mthsladeira/projetos1/README.md

# projetos1
Repositório para relatório e arquivos relativos à matéria Projetos de Aeronaves I (2018/1)
