mthsladeira/projetos1/titlepage.tex

\begin{titlepage}
	\centering
    \vfill
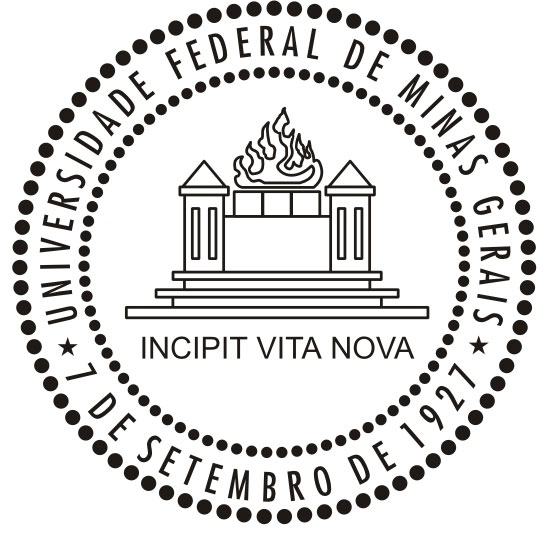
[picture p1: images/UFMG.jpg]
    \\[1.5 cm]	
    \textsc{\LARGE Universidade Federal de Minas Gerais}\\[1.0 cm]
	\textsc{\Large Engenharia Aeroespacial}\\[0.5 cm]
	\textsc{\large Projetos de Aeronaves I - EMA052}\\[0.5 cm]
    \vfill
	\rule{\linewidth}{0.2 mm} \\[0.4 cm]
	{ \huge \bfseries \thetitle}\\
	\rule{\linewidth}{0.2 mm} \\
	
    \vfill

	\theauthor
    
    \vfill
    
	{\large \thedate}\\
	
\end{titlepage}
