mthsladeira/projetos1/text/parte3/tabela_resumo.tex

\chapter{Resumo da Aeronave}
\label{tabelaresumo}

O forma em planta da aeronave está no \textbf{Anexo D} e as dimensões geométricas estão apresentadas no desenho. A \autoref{tbl:resumo} resumo as principais característica da aeronave.

\begin{table}[H]
\centering
\begin{tabular}{rcrc}
\toprule
$S$ & 53 $m^2$ & $MTOW$  & 20806 kg\\
$W/S$ & 341 $kg/m^2$ & $P/W$  & 0.183 $kW/kg$ \\
$P$ & 1846 kW & Motor & PW127 \\
$AR$ & 14 & $\lambda$ & 0.45 \\
$ROC$ & 11.2 $m/s$ & $V_C$ & 140 $m/s$ \\
Teto de Serviço & 7600 $m$ & TOFL (ISA SL) & 1200 $m$ \\
\bottomrule
\end{tabular}
\caption{Resumo da Aeronave}
\label{tbl:resumo}
\end{table}
