mthsladeira/projetos1/text/parte2/londonCityDecol.pdf

AD 2-EGLC-8-6 (15 Dec 11) | UK AIP
VISUAL APPROACH PROFILE | LONDON/CITY

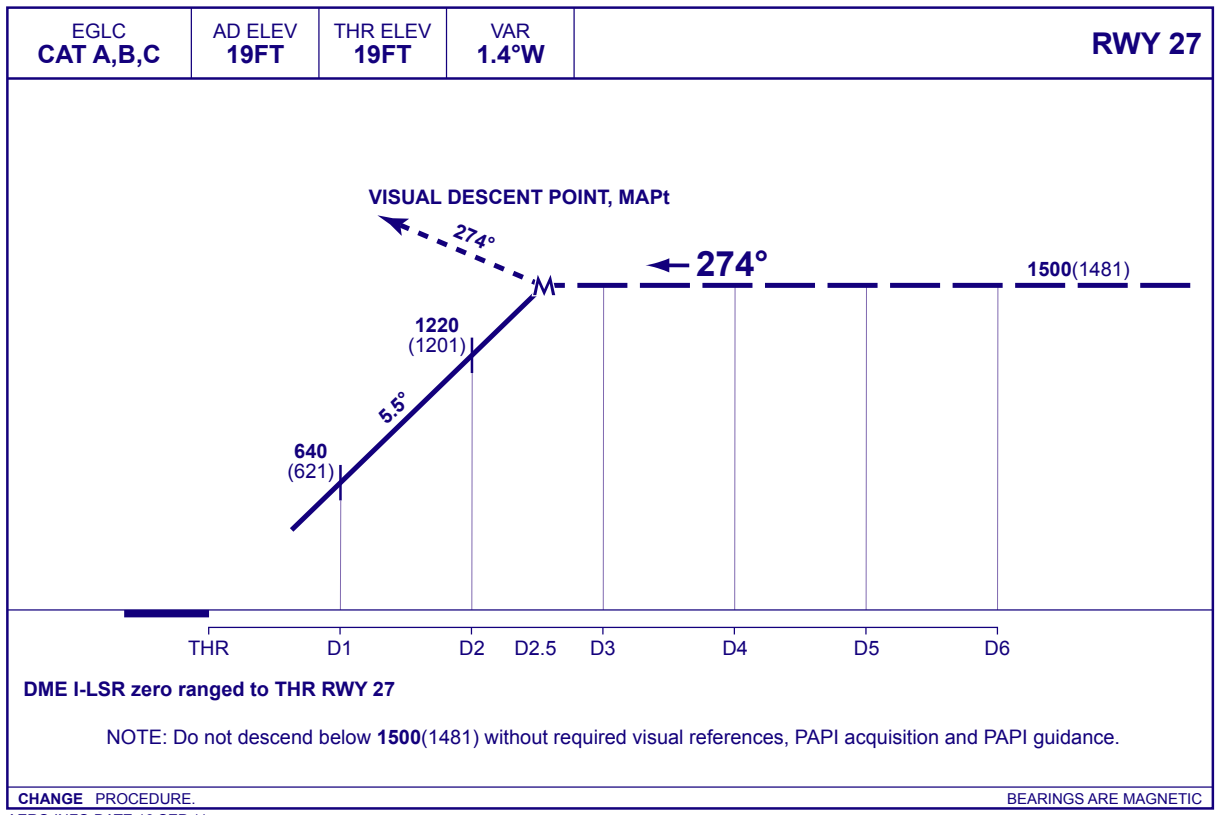
[picture p2: figure]
CHANGE PROCEDURE.; BEARINGS ARE MAGNETIC; EGLC CAT A,B,C; AD ELEV 19FT; THR ELEV 19FT; VAR; RWY 27; THR; DME I-LSR zero ranged to THR RWY 27; VISUAL DESCENT POINT, MAPt

AMDT 13/11 | Civil Aviation Authority

AERO INFO DATE 16 SEP 11

NOTE: Do not descend below 1500(1481) without required visual references, PAPI acquisition and PAPI guidance.
