mthsladeira/projetos1/header_and_footer.tex

\renewcommand{\footrulewidth}{0.4pt}%add line above footer
\pagestyle{fancy}
\fancyhf{}
\lhead{
	\vfill
    
    \vfill
}
\chead{
    \vfill
    \textsf{\textbf{\footnotesize
        Centro de Estudos Aeronáuticos UFMG \\
        Curso de Engenharia Aeroespacial \\
        }
        {\scriptsize
        Av. Antônio Carlos, 6627 – Pampulha – 31270-901 \\
        Belo Horizonte – Minas Gerais \\[-1.5\baselineskip]
        }
    }
}
\rhead{
\vfill

%\vspace{3pt}
}

\lfoot{Bernardo, Geovana, João,\\Laura, Matheus, Talitha}
\cfoot{\thepage\ de \pageref{LastPage}}
\rfoot{\thetitle}

\fancypagestyle{plain}{%
   \pagestyle{fancy}
}

%\fancypagestyle{empty}{
%	\pagestyle{fancy}
 %   \vfill
   % THIS PAGE LEFT BLANK
  %  \vfill
%}
