mthsladeira/projetos1/text/anexos.tex

\part*{Anexo A:\\~\\ Tabela Comparativa}
\addcontentsline{toc}{part}{Anexo A: Tabela Comparativa}
\label{anexoA}
  \includepdf[pages=-]{text/parte1/tabela_comparativa.pdf}

\part*{Anexo B:\\~\\ Cartas dos aeroportos London City e Santos Dumond}
\addcontentsline{toc}{part}{Anexo B: Cartas dos aeroportos London City e Santos Dumond}
\label{anexoB}
  \includepdf[pages=-]{text/parte2/londonCityAprox.pdf}
  \includepdf[pages=-]{text/parte2/londonCityDecol.pdf}
  \includepdf[pages=-]{text/parte2/santosDumond.pdf}

\part*{Anexo C:\\~\\ Tabela de CGs}
\addcontentsline{toc}{part}{Anexo C: Tabela de CGs}
\label{anexoC}
  \includepdf[pages=-]{text/parte2/tabelaCGs.pdf}

\part*{Anexo D:\\~\\ Desenho em 3 vistas inicial}
\addcontentsline{toc}{part}{Anexo D: Desenho em 3 vistas inicial}
\label{anexoD}
  \includepdf[pages=-]{text/parte3/3vistas.pdf}

\part*{Anexo E:\\~\\ Entradas do Programa AVL}
\addcontentsline{toc}{part}{Anexo E: Entradas do Programa AVL}
\label{anexoE}
\section*{Geometria da Aeronave}

\VerbatimInput{text/avl/aircraft.txt}

\section*{Condição de Voo}

\VerbatimInput{text/avl/batch_ref.txt}

\part*{Anexo F:\\~\\ Desenhos da aeronave}
\addcontentsline{toc}{part}{Anexo F: Desenhos da aeronave}
\label{anexoF}
  % \includepdf[pages=-, noautoscale]{Desenho/Aeronave-Modelo.pdf}
  % \includepdf[pages=-, noautoscale]{Desenho/Asa-Modelo.pdf}
  % \includepdf[pages=-, noautoscale]{Desenho/nervuras-Modelo.pdf}
  % \includepdf[pages=-, noautoscale]{Desenho/EH-Modelo.pdf}
  % \includepdf[pages=-, noautoscale]{Desenho/nervuras_EH-Modelo.pdf}
  % \includepdf[pages=-, noautoscale]{Desenho/fuselagem_estrutura-Modelo.pdf}
  % \includepdf[pages=-, noautoscale]{Desenho/fuselagem_estrutura_transversal-Modelo.pdf}
