mthsladeira/projetos1/text/parte2/aerodinamica.tex

\chapter{Aerodinâmica}
\section{Perfil aerodinâmico da asa}
\label{perfilasa}

O objetivo mais importante na escolha do perfil da asa foi a redução do arrasto, visando melhor desempenho e menor consumo em cruzeiro. Além disso, também foram considerados a sustentação máxima do perfil e a sua espessura. A sustentação máxima é essencial para o pouso e decolagem, mas ficou em segundo plano porque ela pode ser incrementada com o uso de superfícies hipersustentadoras---flaps e slats. Perfis mais espessos são desejáveis porque aumentam a eficiência estrutural da asa e o espaço disponível para combustível.

Com esses critérios em vista, é natural escolher um perfil de escoamento laminar (Natural Laminar Flow, NLF). Devido aos amplos dados experimentais disponíveis, a seleção se limitou à família NACA série 6. Os perfis selecionados após uma triagem inicial estão na tabela \ref{tbl:perfisNACASelecionados}.

\begin{table}[h]
  \label{tbl:perfisNACASelecionados}
  \caption{Perfis NACA selecionados}
  \centering
  \begin{tabular}{lcccc}
    \toprule
    Perfil &
    $ c_{l_{\max}} $ & $ c_{d_{\min}} $ & $ c_{m_{ac}} $ & t/c \\
    \midrule
    NACA 63\textsubscript{1}-412 & 1,77 &0,0044 & -0.075 & 0,12 \\
    NACA 64\textsubscript{2}-415 & 1,66 &0,0046 & -0.070 & 0,15 \\
    NACA 65\textsubscript{1}-412 & 1,64 &0,0038 & -0.070 & 0,12 \\
    NACA 66\textsubscript{3}-418 & 1,57 &0,0037 & -0.075 & 0,18 \\
    \bottomrule
  \end{tabular}
\end{table}

\begin{figure}[p]
    \input{autogenerated/tikzplots/aero_coef}
    \caption[Coeficientes Aerodinâmicos dos Perfis Selecionados]{Os dados foram
    obtidos através do software de CFD XFOIL\cite{xfoil}, configurado
    para $\text{Re} = 5\cdot10^6$ e $\text{Ma} =0,3$.}
    \label{fig:aero_coef}
\end{figure}

O perfil escolhido para o projeto foi o 66\textsubscript{3}-418, devido ao seu baixo ${c_d}_{\min}$ e grande balde laminar. Além disso ele é bem comportado no estol,que ocorre com relativamente alto ângulo de ataque e em um $c_l$ na mesma faixa dos outros perfis da série 6. Sua alta espessura é vantajosa para reduzir o peso estrutural da aeronave e permite amplo espaço para tanques de combustível.

A escolha de um perfil de escoamento laminar só é vantajosa se a operação do avião ocorrer dentro do balde laminar. Para verificar o atendimento a esse critério, é necessário calcular o coeficiente de sustentação para a situação de cruzeiro e subida.
\begin{equation}
  (C_L)_{\text{cruise}} =
    \left.
      \frac {W} {\frac{1}{2} \rho V^2 S}
    \right|_{\text{cruise}} =
    \frac
      {14549\si{kg} \cdot 9,8\si{N/kg} }
      {\frac{1}{2} \cdot 0,4135 \si{kg/m^3} \cdot (140\si{m/s})^2 \cdot 53 \si{m^2}}
    = 0,66
\end{equation}

\begin{equation}
  (C_L)_{\text{climb}} =
    \left.\frac
      {W}
      {\frac{1}{2} \rho V^2 S}
    \right|_{\text{climb}} =
    \frac
      {16957\si{kg} \cdot 9,8\si{N/kg}}
      {\frac{1}{2} \cdot 1,225 \si{kg/m^3}
    (58\si{m/s})^2 \cdot 53 \si{m^2}}
    = 1,52
\end{equation}

Considerando o peso de cruzeiro como o peso do avião com o máximo de passageiros e metade do combustível máximo, a 30000ft, e o início da subida, ao nível do mar, com o máximo de passageiros e 96,5\% do combustível, conforme sugerido por \cite{roskam} e velocidade ideal de subida.

A \autoref{fig:aero_coef} mostra que, no ponto de projeto atual, o valor de
$C_l$ para o cruzeiro está no balde laminar. O $C_l$ de subida está preocupantemente próximo do estol, então a velocidade de subida deve ser maior que $58\si{m/s}$. Com $62\si{m/s}$ o $C_l$ diminui para 1,33.

\section{Forma em planta da asa}
\label{formaemplanta_asa}

Para uma primeira aproximação, a asa foi definida como trapezoidal com um afilamento de $\lambda = 0,45$, conforme sugerido por \cite{raymer2012aircraft} para aproximar a distribuição de sustentação da ideal, elíptica. O alongamento foi estimado com base na comparação entre aeronaves da categoria como $A = 14$, ligeiramente maior que a dos concorrentes, para maior eficiência aerodinâmica. Veja a \autoref{fig:alongamento}. Além disso, conforme definido na \autoref{sec:ponto_de_projeto}, a área alar é de $S=53\si{m^2}$. O bordo de ataque será reto para evitar interferência da asa com a hélice, e também para melhorar as características de estol. O efeito estrutural do enflexamento negativo pode ser compensando com o uso de compósitos. Com esses parâmetros, é fácil derivar os outros parâmetros da asa, descritos na \autoref{tbl:asa_trapezoidal}

\begin{table} [H]
\caption{Parâmetros da asa trapezoidal}
\label{tbl:asa_trapezoidal}
\begin{tabular}{llccrl}
\toprule
					  & Nome        & Símbolo   & Fórmula & Valor & \\ \midrule
Parâmetros de projeto & Alongamento & $A$       &         & 14    & \\
                      & Afilamento  & $\lambda$ &         & 0,45  & \\
                      & Área alar   & $S$		&         & 53    & \si{m^2}\\ \midrule
Parâmetros calculados & Envergadura & $b$       & $\sqrt{AS}$ & 27,240&\si{m} \\
                      & Corda na raiz & $c_r$ & $\frac{2b}{(1+\lambda)A}$ & 2,684 & \si{m} \\
                      & Corda média aerodinâmica & CMA & $\frac{2}{3} c_r \frac{1+\lambda +\lambda^2}{1+\lambda}$ & 2,039 & \si{m} \\
                      & Corda na ponta & $c_t$ & $\lambda c_r$ & 1,207 & \si{m} \\
                      & Enflexamento & $\gamma$ & $-\arctan\left(\frac{c_r-c_t}{2b}\right)$ & -1,55 & deg\\
\bottomrule
\end{tabular}
\end{table}

\section{Dimensionamento Inicial das Empenagens}
\label{formaemplanta_empenagens}
% --------------------------
% DIMENSIONAMENTO EMPENAGENS
% --------------------------

Definido o ponto de projeto em termos de P, W e S, a próxima etapa é a determinação das áreas das empenagens. A metodologia aplicada consiste em atingir o volume de cauda típico para a classe de aeronaves turboélice como sugerido por \cite{raymer2012aircraft}. A definição do volume de cauda para empenagens horizontal e vertical são apresentadas abaixo.

%%%%%%%%%
% DEIXAR EQUAÇÕES BONITAS
%%%%%%%%%

%% Equação volume de cauda
\begin{equation}
\overline{V}_{eh} = \frac{S \overline{c}_w}{S_{eh} l_t} 
\end{equation}

\begin{equation}
\overline{V}_{ev} = \frac{S b_w}{S_{ev} l_t} 
\end{equation}

Os valores típicos para o volume de cauda utilizados foram baseados em \cite{raymer2012aircraft} e estão apresentados na tabela abaixo para aeronaves turboélice.

\begin{table}[H]
\centering
\caption{Volume de cauda típicos para aeronaves turboélice}
\label{tbl:vbar}
\begin{tabular}{cc}
\toprule
$\overline{V}_{eh}$ & 0.9  \\
$\overline{V}_{ev}$  & 0.08  \\
\bottomrule
\end{tabular}
\end{table}

Para dimensionamento das empenagens, é necessário o conhecimento da corda média aerodinâmica ($\overline{c}_w$) e envergadura da asa e distância do centro aerodinâmico da asa ao centro aerodinâmico das empenagens que, por simplicidade, é considerado o mesmo para a empenagem horizontal e vertical ($l_t$). A estimativa considerou o ponto de projeto escolhido e o comprimento de fuselagem definido na Parte I deste trabalho ($l_{fus} = 29.87$). A tabela abaixo apresenta os valores considerados

\begin{table}[H]
\centering
\caption{Corda média aerodinâmica da asa e distância do centro aerodinâmico da asa ao centro aerodinâmico das empenagens}
\label{tbl:lt}
\begin{tabular}{cc}
\toprule
$\overline{c}_w$ & 2.039 m \\
$b_w$  & 27.240 m \\
$l_t$  & 13.5 m \\
\bottomrule
\end{tabular}
\end{table}

A partir do volume de cauda típico e estimativas referentes a geometria externas da aeronave, tem-se abaixo as áreas necessárias para a empenagem horizontal e vertical.

\begin{table}[H]
\centering
\caption[Área das Empenagens]{Área das empenagens}
\label{tbl:s_eh}
\begin{tabular}{cc}
\toprule
$S_{eh}$ & 7.1 $m^2$ \\
$S_{ev}$  & 8.8 $m^2$ \\
\bottomrule
\end{tabular}
\end{table}

Por fim, a \autoref{tbl:Dimensoes_iniciais} resume os parâmetros da aeronave definidos a partir do ponto de projeto escolhido e do dimensionamento das empenagens.

\begin{table}[H]
\centering
\caption[Dimensionamento inicial da aeronave]{Dimensionamento inicial da aeronave}
\label{tbl:Dimensoes_iniciais}
\begin{tabular}{cc}
\toprule
$P$ & 1846 $kW$ \\
$S$ & 53 $m^2$ \\
$S_{eh}$ & 7.1 $m^2$ \\
$S_{ev}$  & 8.8 $m^2$ \\
$l_t$ & 13.5 $m$ \\
$\overline{c}_w$ & 2 $m$ \\
\bottomrule
\end{tabular}
\end{table}
