mthsladeira/projetos1/text/parte3/3vistas.docx

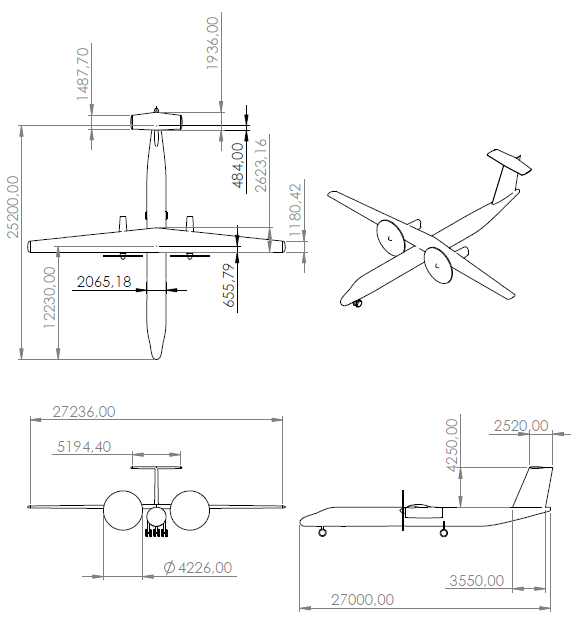
[picture p3: figure]

Projeto PRJ-400 Date: 25/9/2018 Page: 1/1 Revision: Execution:

Centro de Estudos Aeronáuticos UFMG Curso de Engenharia Aeroespacial Av. Antônio Carlos, 6627 – Pampulha – 31270-901 Belo Horizonte – Minas Gerais Report number: Approved:
