mthsladeira/projetos1/Desenho/configuracao_interna.pdf

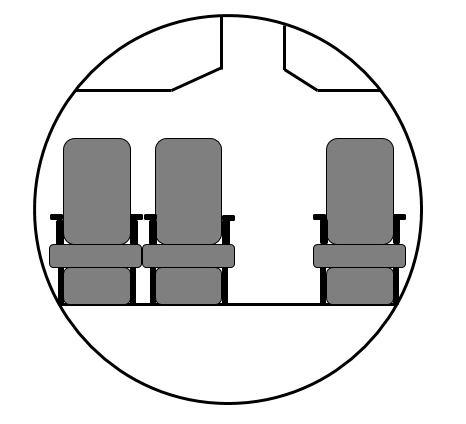
[picture p4: figure]

Configuração interna
