mthsladeira/projetos1/images/parte1/Tabela_Comparativa_-_RASCUNHO2.pdf

n | Modelo | Passageiros | Tipo de motor Ano - Primeiro Voo Posicao Asa | | | Forma em Planta da Asa | Geometria Empenagens | Trem de Pouso | Enflechamento
4 | Douglas DC-3 | 32 | Piston | 1935 | Baixa | Trapezoidal | Convencional | Convencional | Nulo
6 | Curtis C46 Commando | 36 | Piston | 1940 | Baixa | Retotrapezoidal | Convencional | Triciclo | Nulo
12 | Douglas DC-4 | 44 | Piston | 1942 | Baixa | Trapezoidal | Convencional | Triciclo | Nulo
29 | Douglas DC-6 | 54 | Piston | 1946 | Baixa | Trapezoidal | Convencional | Triciclo | Nulo
10 | Convair 240 | 40 | Piston | 1947 | Baixa | Trapezoidal | Convencional | Triciclo | Nulo
21 | Canadair CL-600 Regional Jet CRJ-100 & 200 | 50 | Turbofan | 1978 | Baixa | Bitrapezoidal com winglet | Em T | Triciclo | Positivo
20 | Bombardier CRJ200 | 50 | Turbofan | 1991 | Baixa | Bitrapezoidal com winglet | Em T | Triciclo | Positivo
16 | Embraer ERJ145 | 48 | Turbofan | 1995 | Baixa | Bitrapezoidal | Em T | Triciclo | Positivo
5 | Fairchild Dornier 328JET | 34 | Turbofan | 1996 | Alta | Retotrapezoidal | Em T | Triciclo | Nulo
35 | Embraer E170 | 72 | Turbofan | 2002 | Baixa | Bitrapezoidal com winglet | Convencional | Triciclo | Positivo
30 | Convair 580 | 56 | Turboprop | 1947 | Baixa | Trapezoidal | Convencional | Triciclo | Nulo
27 | Convair 440 | 52 | Turboprop | 1947 | Baixa | Trapezoidal | Convencional | Triciclo | Nulo
26 | Convair 340 | 52 | Turboprop | 1947 | Baixa | Trapezoidal | Convencional | Triciclo | Nulo
28 | Fokker F-27 | 52 | Turboprop | 1955 | Alta | Trapezoidal | Convencional | Triciclo | Nulo
15 | Handley Page Herald | 47 | Turboprop | 1955 | Alta | Retotrapezoidal | Convencional | Triciclo | Nulo
17 | Antonov An-24 | 50 | Turboprop | 1959 | Alta | Retotrapezoidal | Convencional | Triciclo | Nulo
24 | Hawker Siddeley HS-748 | 51 | Turboprop | 1960 | Baixa | Trapezoidal | Convencional | Triciclo | Nulo
2 | Aerospatiale N 262 Fregate a Mohawk 298 | 29 | Turboprop | 1962 | Alta | Trapezoidal | Convencional | Triciclo | Nulo
36 | BAe 146-100 / Avro RJ70 | 82 | Turboprop | 1981 | Alta | Trapezoidal | Em T | Triciclo | Positivo
7 | Short 360 | 36 | Turboprop | 1981 | Alta | Reta | Convencional | Triciclo | Nulo
37 | Bombadier Dash 8 Q400 | 82 | Turboprop | 1983 | Alta | Trapezoidal | Em T | Triciclo | Nulo
14 | Casa/IPTN CN235 | 45 | Turboprop | 1983 | Alta | Retotrapezoidal | Convencional | Triciclo | Nulo
13 | Casa CN235 | 45 | Turboprop | 1983 | Alta | Retotrapezoidal | Convencional | Triciclo | Nulo
19 | Bombadier Dash 8 Q300 | 50 | Turboprop | 1983 | Alta | Retotrapezoidal | Convencional | Triciclo | Nulo
8 | Bombardier Dash 8 Q200 | 37 | Turboprop | 1983 | Alta | Retotrapezoidal | Em T | Triciclo | Nulo
3 | Embraer EMB120 Brasilia | 30 | Turboprop | 1983 | Baixa | Bitrapezoidal | Em T | Triciclo | Nulo
18 | ATR 42-600 | 50 | Turboprop | 1984 | Alta | Retotrapezoidal | Em T | Triciclo | Nulo
22 | Fokker 50 | 50 | Turboprop | 1985 | Alta | Trapezoidal | Convencional | Triciclo | Nulo
1 | Piaggio P180 Avanti | 8 | Turboprop | 1986 | Alta | Trapezoidal | Em T | Triciclo | Nulo
34 | ATR 72-600 | 70 | Turboprop | 1988 | Alta | Retotrapezoidal | Em T | Triciclo | Nulo
33 | Ilyushin 114 | 64 | Turboprop | 1990 | Baixa | Trapezoidal | Convencional | Triciclo | Nulo
9 | Dornier 328 | 39 | Turboprop | 1991 | Alta | Retotrapezoidal | Em T | Triciclo | Nulo
11 | Let L-610 | 40 | Turboprop | 1992 | Alta | Trapezoidal | Em T | Triciclo | Nulo
31 | Saab 2000 | 58 | Turboprop | 1992 | Baixa | Retotrapezoidal | Convencional | Triciclo | Nulo
23 | IPTN N-25050 | 50 | Turboprop | 1995 | Alta | Trapezoidal | Em T | Triciclo | Nulo
25 | Antonov An-140 | 52 | Turboprop | 1997 | Alta | Trapezoidal | Convencional | Triciclo | Nulo
32 | Xian MA60 | 62 | Turboprop | 2000 | Alta | Retotrapezoidal | Convencional | Triciclo | Nulo
