mthsladeira/projetos1/images/parte1/Tabela_Comparativa_CONCEITOS.pdf

n | Modelo | Passageiros | Tipo de motor | Primeiro Voo | Posicao Asa | Forma em Planta da Asa | Geometria Empenagens | Trem de Pouso | Enflechamento
4 | Douglas DC-3 | 32 | Pistão | 1935 | Baixa | Trapezoidal | Convencional | Convencional | Nulo
6 | Curtis C46 Commando | 36 | Pistão | 1940 | Baixa | Retotrapezoidal | Convencional | Triciclo | Nulo
12 | Douglas DC-4 | 44 | Pistão | 1942 | Baixa | Trapezoidal | Convencional | Triciclo | Nulo
29 | Douglas DC-6 | 54 | Pistão | 1946 | Baixa | Trapezoidal | Convencional | Triciclo | Nulo
10 | Convair 240 | 40 | Pistão | 1947 | Baixa | Trapezoidal | Convencional | Triciclo | Nulo
26 | Convair 340 | 52 | Turbo-hélice | 1947 | Baixa | Trapezoidal | Convencional | Triciclo | Nulo
27 | Convair 440 | 52 | Turbo-hélice | 1947 | Baixa | Trapezoidal | Convencional | Triciclo | Nulo
30 | Convair 580 | 56 | Turbo-hélice | 1947 | Baixa | Trapezoidal | Convencional | Triciclo | Nulo
15 | Handley Page Herald | 47 | Turbo-hélice | 1955 | Alta | Retotrapezoidal | Convencional | Triciclo | Nulo
28 | Fokker F-27 | 52 | Turbo-hélice | 1955 | Alta | Trapezoidal | Convencional | Triciclo | Nulo
17 | Antonov An-24 | 50 | Turbo-hélice | 1959 | Alta | Retotrapezoidal | Convencional | Triciclo | Nulo
24 | Hawker Siddeley HS-748 | 51 | Turbo-hélice | 1960 | Baixa | Trapezoidal | Convencional | Triciclo | Nulo
2 | Aerospatiale N 262 Fregate a Mohawk 298 | 29 | Turbo-hélice | 1962 | Alta | Trapezoidal | Convencional | Triciclo | Nulo
7 | Short 360 | 36 | Turbo-hélice | 1981 | Alta | Reta | Convencional | Triciclo | Nulo
3 | Embraer EMB120 Brasilia | 30 | Turbo-hélice | 1983 | Baixa | Bitrapezoidal | Em T | Triciclo | Nulo
8 | Bombardier Dash 8 Q200 | 37 | Turbo-hélice | 1983 | Alta | Retotrapezoidal | Em T | Triciclo | Nulo
13 | Casa CN235 | 45 | Turbo-hélice | 1983 | Alta | Retotrapezoidal | Convencional | Triciclo | Nulo
14 | Casa/IPTN CN235 | 45 | Turbo-hélice | 1983 | Alta | Retotrapezoidal | Convencional | Triciclo | Nulo
19 | Bombadier Dash 8 Q300 | 50 | Turbo-hélice | 1983 | Alta | Retotrapezoidal | Convencional | Triciclo | Nulo
37 | Bombadier Dash 8 Q400 | 82 | Turbo-hélice | 1983 | Alta | Trapezoidal | Em T | Triciclo | Nulo
18 | ATR 42-600 | 50 | Turbo-hélice | 1984 | Alta | Retotrapezoidal | Em T | Triciclo | Nulo
22 | Fokker 50 | 50 | Turbo-hélice | 1985 | Alta | Trapezoidal | Convencional | Triciclo | Nulo
1 | Piaggio P180 Avanti | 8 | Turbo-hélice | 1986 | Alta | Trapezoidal | Em T | Triciclo | Nulo
34 | ATR 72-600 | 70 | Turbo-hélice | 1988 | Alta | Retotrapezoidal | Em T | Triciclo | Nulo
33 | Ilyushin 114 | 64 | Turbo-hélice | 1990 | Baixa | Trapezoidal | Convencional | Triciclo | Nulo
9 | Dornier 328 | 39 | Turbo-hélice | 1991 | Alta | Retotrapezoidal | Em T | Triciclo | Nulo
11 | Let L-610 | 40 | Turbo-hélice | 1992 | Alta | Trapezoidal | Em T | Triciclo | Nulo
31 | Saab 2000 | 58 | Turbo-hélice | 1992 | Baixa | Retotrapezoidal | Convencional | Triciclo | Nulo
23 | IPTN N-25050 | 50 | Turbo-hélice | 1995 | Alta | Trapezoidal | Em T | Triciclo | Nulo
25 | Antonov An-140 | 52 | Turbo-hélice | 1997 | Alta | Trapezoidal | Convencional | Triciclo | Nulo
32 | Xian MA60 | 62 | Turbo-hélice | 2000 | Alta | Retotrapezoidal | Convencional | Triciclo | Nulo
21 | Canadair CL-600 Regional Jet CRJ-100 & 200 | 50 | Turbofan | 1978 | Baixa | Bitrapezoidal com winglet | Em T | Triciclo | Positivo
36 | BAe 146-100 / Avro RJ70 | 82 | Turbofan | 1981 | Alta | Trapezoidal | Em T | Triciclo | Positivo
20 | Bombardier CRJ200 | 50 | Turbofan | 1991 | Baixa | Bitrapezoidal com winglet | Em T | Triciclo | Positivo
16 | Embraer ERJ145 | 48 | Turbofan | 1995 | Baixa | Bitrapezoidal | Em T | Triciclo | Positivo
5 | Fairchild Dornier 328JET | 34 | Turbofan | 1996 | Alta | Retotrapezoidal | Em T | Triciclo | Nulo
35 | Embraer E170 | 72 | Turbofan | 2002 | Baixa | Bitrapezoidal com winglet | Convencional | Triciclo | Positivo
