mthsladeira/projetos1/cargas/imagens/Cargas_tdp.jpg

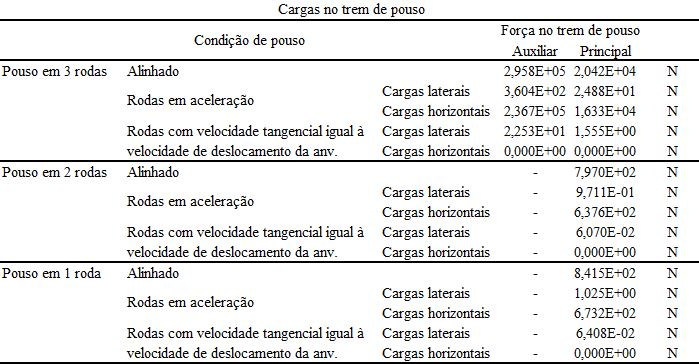
cargas/imagens/Cargas_tdp.jpg
