mthsladeira/projetos1/cargas/imagens/cort_ASA.jpg

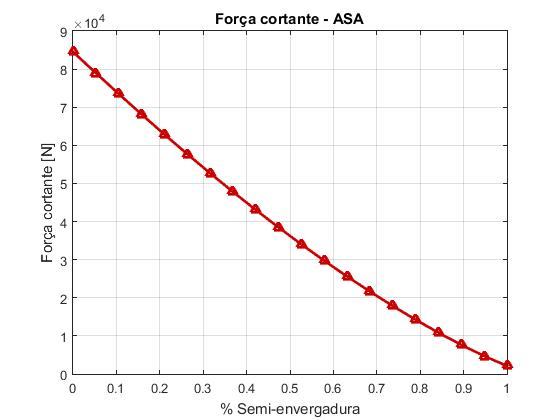
cargas/imagens/cort_ASA.jpg
