mthsladeira/projetos1/cargas/imagens/cort_EH.jpg

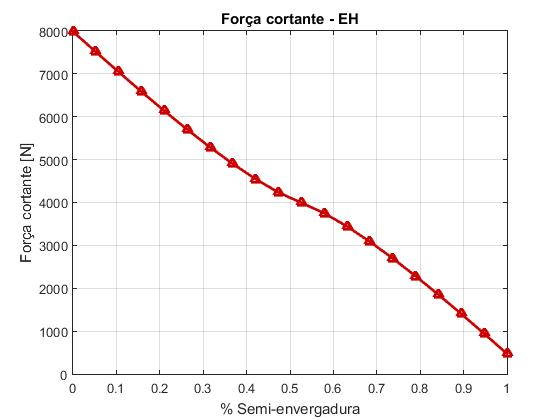
cargas/imagens/cort_EH.jpg
