mthsladeira/projetos1/cargas/imagens/cort_FUS.jpg

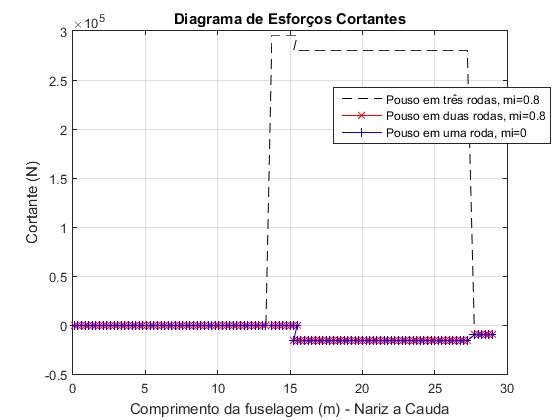
cargas/imagens/cort_FUS.jpg
