mthsladeira/projetos1/cargas/imagens/cort_FUSV.jpg

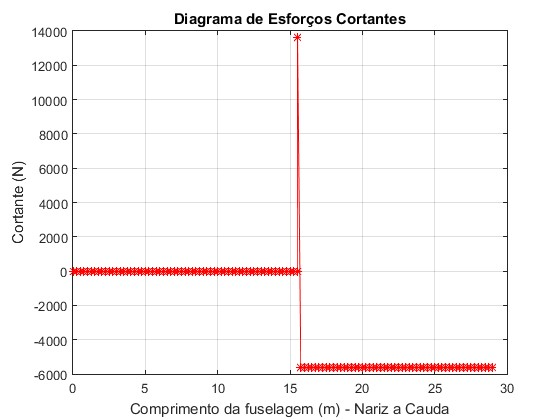
cargas/imagens/cort_FUSV.jpg
