mthsladeira/projetos1/cargas/imagens/flet_ASA.jpg

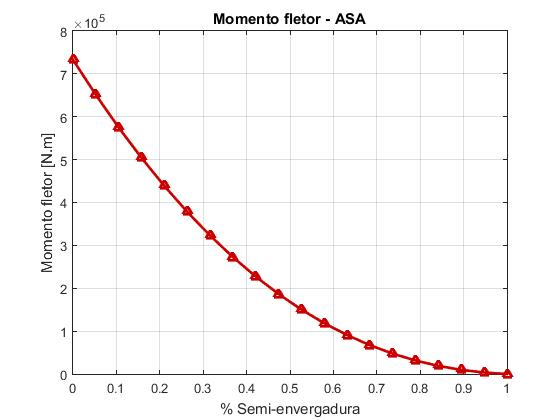
cargas/imagens/flet_ASA.jpg
