mthsladeira/projetos1/cargas/imagens/flet_EH.jpg

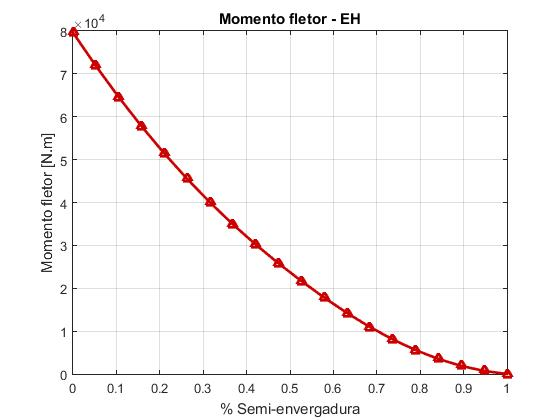
cargas/imagens/flet_EH.jpg
