mthsladeira/projetos1/cargas/imagens/flet_FUS.jpg

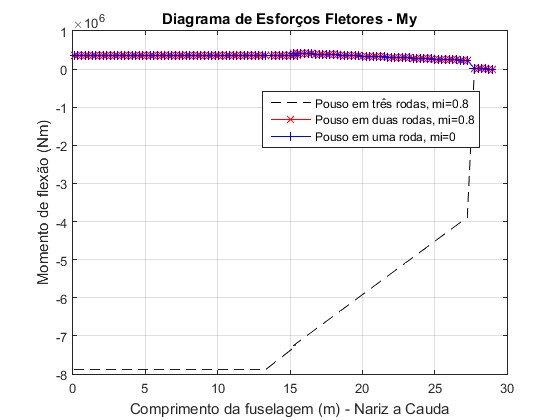
cargas/imagens/flet_FUS.jpg
