mthsladeira/projetos1/cargas/imagens/flet_FUSV2.jpg

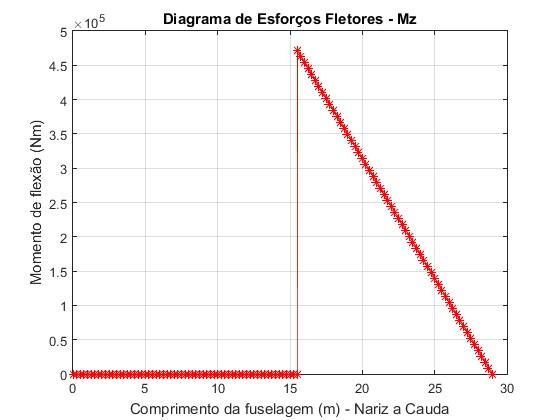
cargas/imagens/flet_FUSV2.jpg
