mthsladeira/projetos1/cargas/imagens/norm_FUS.jpg

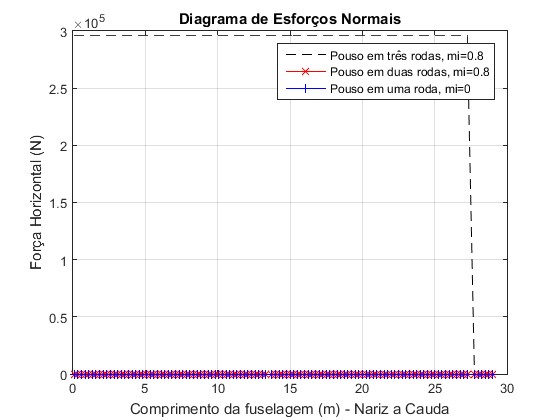
cargas/imagens/norm_FUS.jpg
