mthsladeira/projetos1/cargas/imagens/torc_ASA.jpg

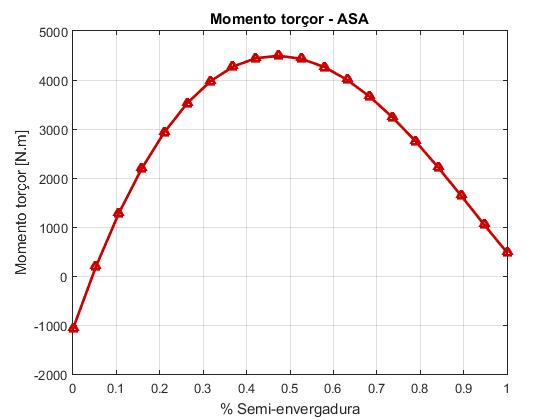
cargas/imagens/torc_ASA.jpg
