mthsladeira/projetos1/cargas/imagens/torc_EH.jpg

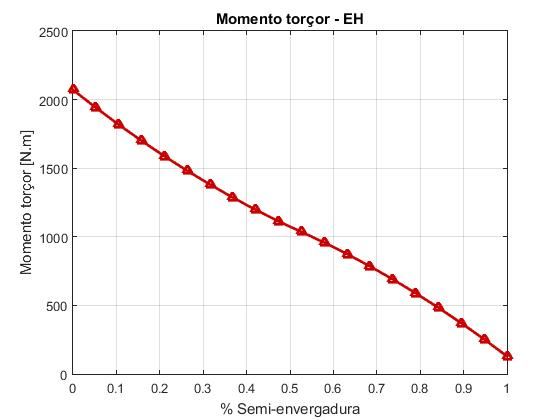
cargas/imagens/torc_EH.jpg
