mthsladeira/projetos1/cargas/imagens/torc_EV.jpg

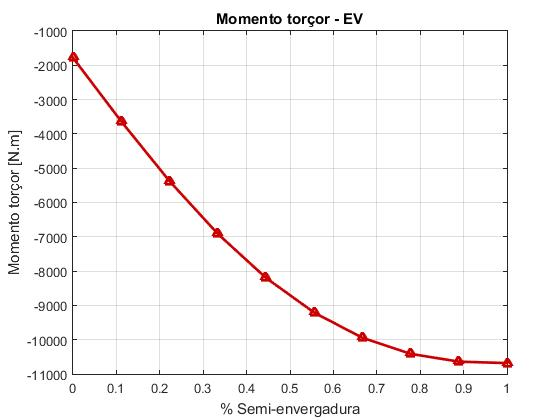
cargas/imagens/torc_EV.jpg
