mthsladeira/projetos1/cargas/imagens/torc_FUSV.jpg

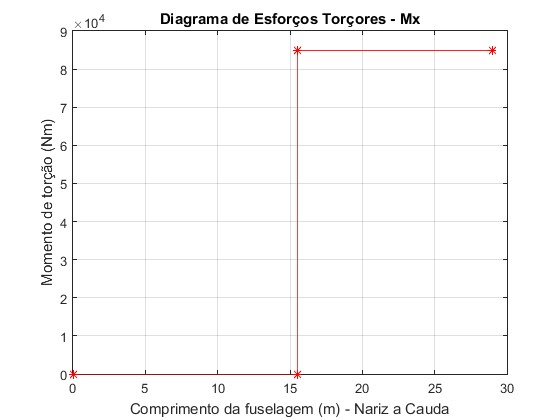
cargas/imagens/torc_FUSV.jpg
