mthsladeira/projetos1/images/cabin_envelope.png

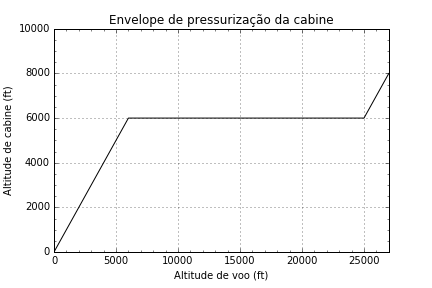
images/cabin_envelope.png
