mthsladeira/projetos1/images/imagem1.jpg

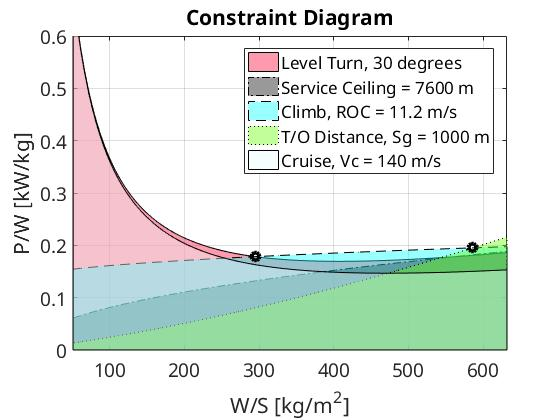
images/imagem1.jpg
