mthsladeira/projetos1/images/imagem3.jpg

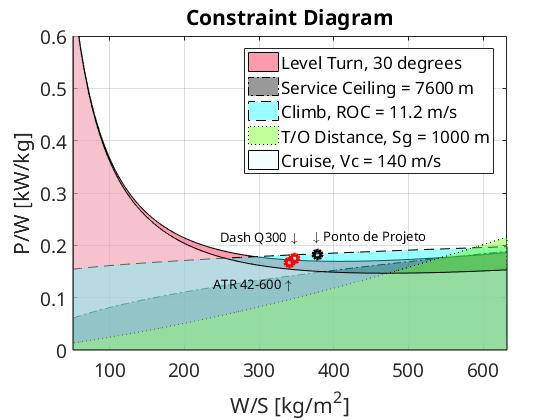
images/imagem3.jpg
