mthsladeira/projetos1/images/naca-helice.png

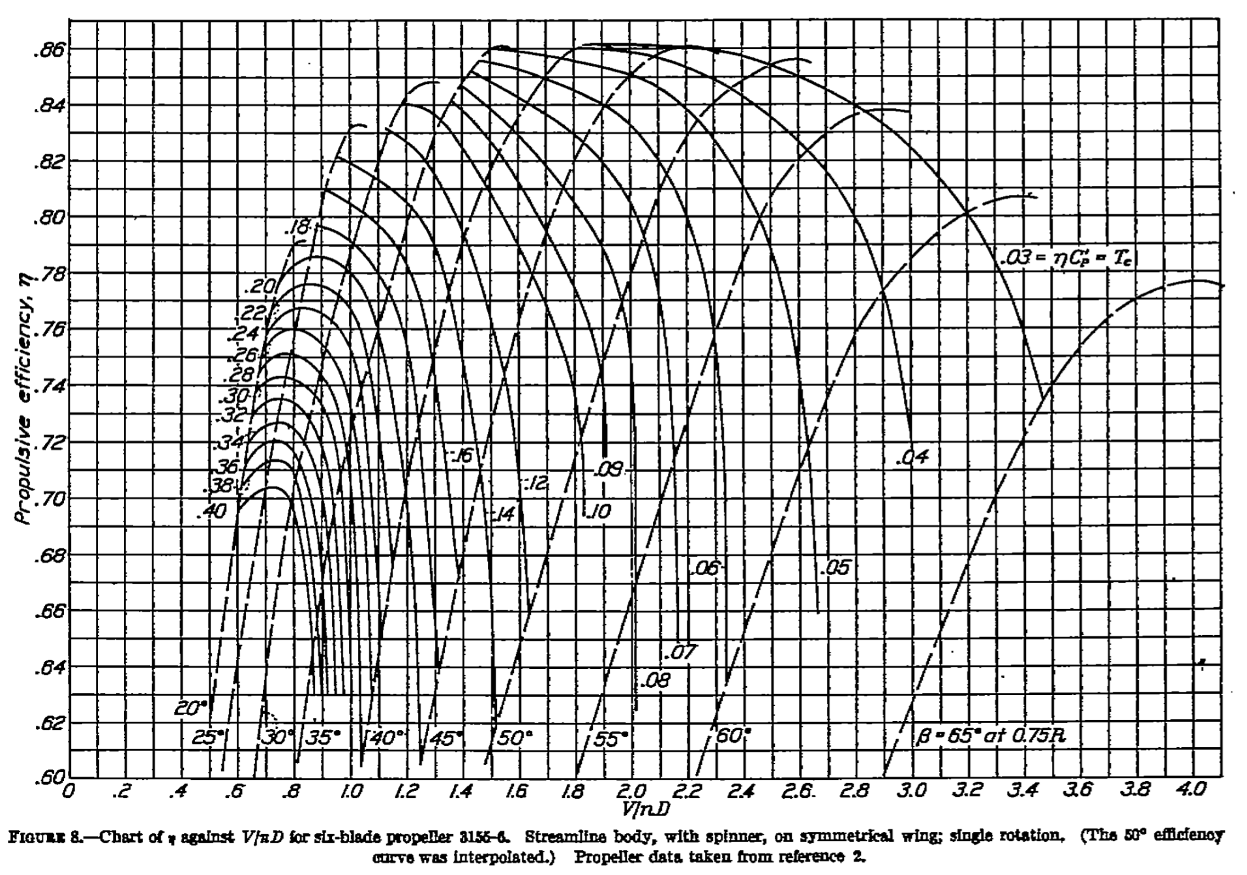
images/naca-helice.png
