mthsladeira/projetos1/images/parte1/LopaPRJ1.JPG

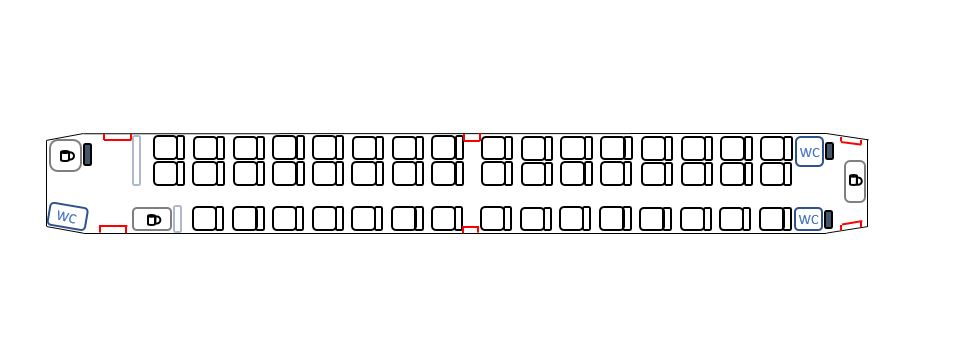
images/parte1/LopaPRJ1.JPG
