mthsladeira/projetos1/images/parte1/MISSAO_GENERICA.png

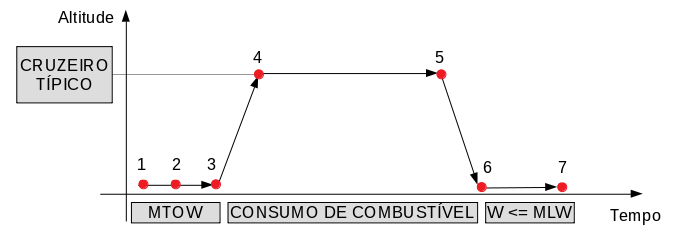
images/parte1/MISSAO_GENERICA.png
