mthsladeira/projetos1/images/parte1/Modelos_Projetos_1_1.jpg

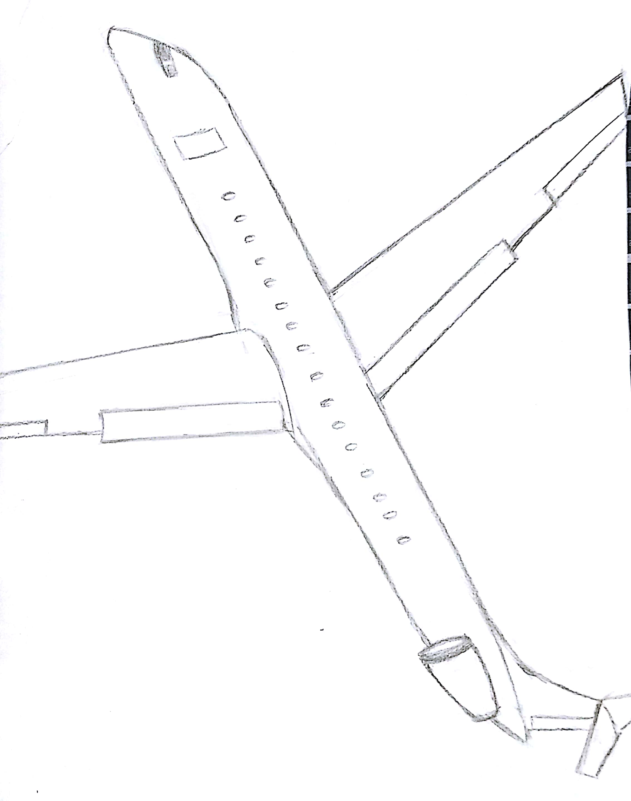
images/parte1/Modelos_Projetos_1_1.jpg
