mthsladeira/projetos1/images/parte1/Modelos_Projetos_1_2.jpg

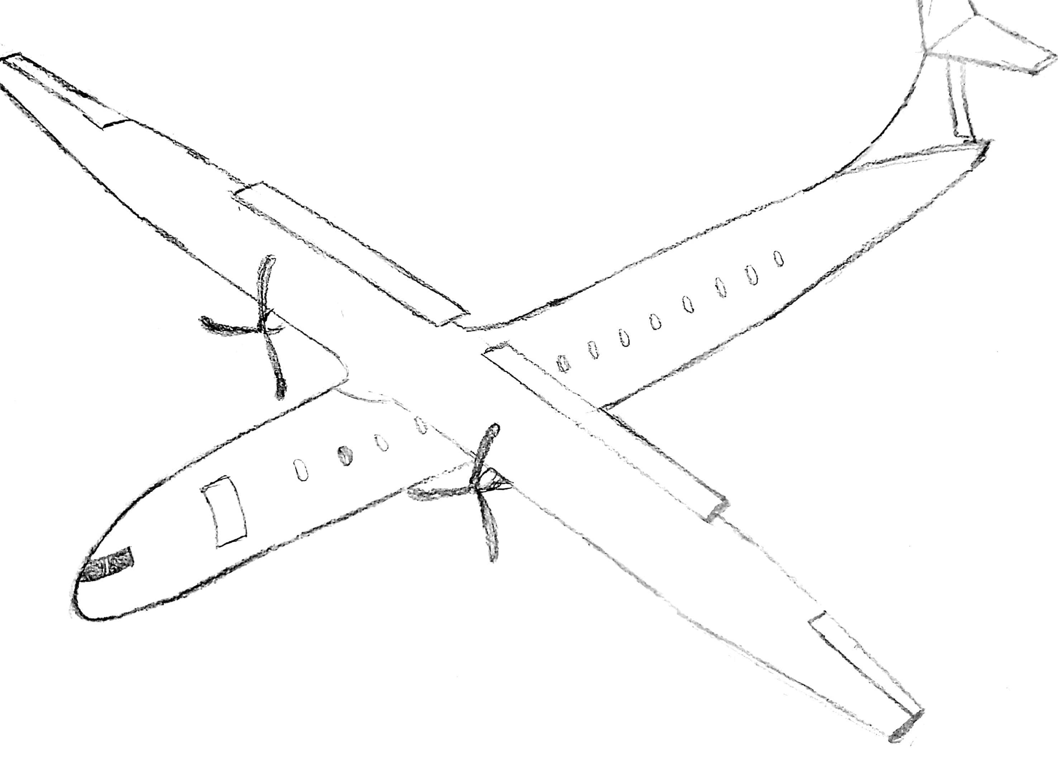
images/parte1/Modelos_Projetos_1_2.jpg
