mthsladeira/projetos1/images/parte1/pesquisademercado/ATR42.jpg

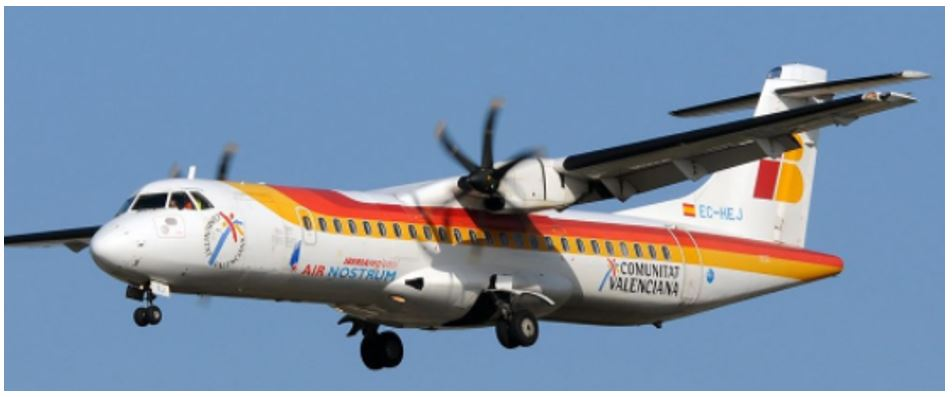
images/parte1/pesquisademercado/ATR42.jpg
