mthsladeira/projetos1/images/parte1/pesquisademercado/BombardierCRJ200.jpg

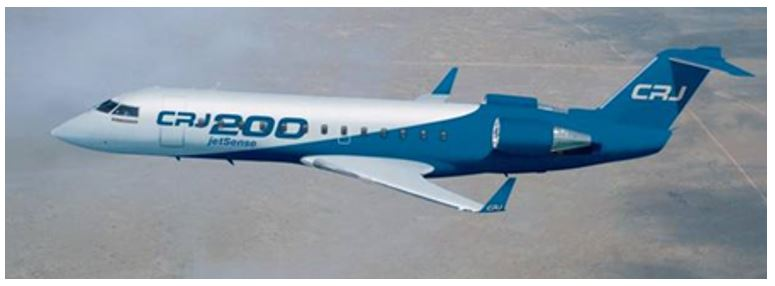
images/parte1/pesquisademercado/BombardierCRJ200.jpg
