mthsladeira/projetos1/images/parte1/pesquisademercado/BombardierDash8.jpg

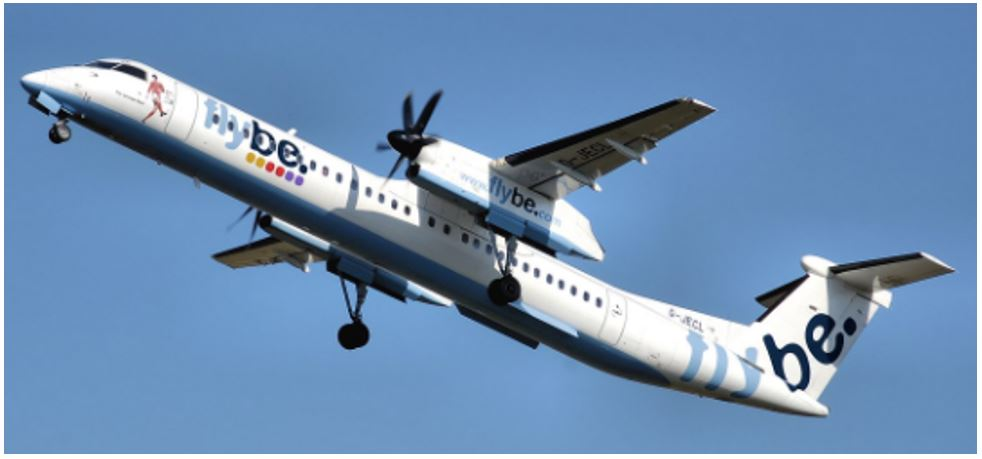
images/parte1/pesquisademercado/BombardierDash8.jpg
