mthsladeira/projetos1/images/parte1/pesquisademercado/dimensoesExternasATR42.jpg

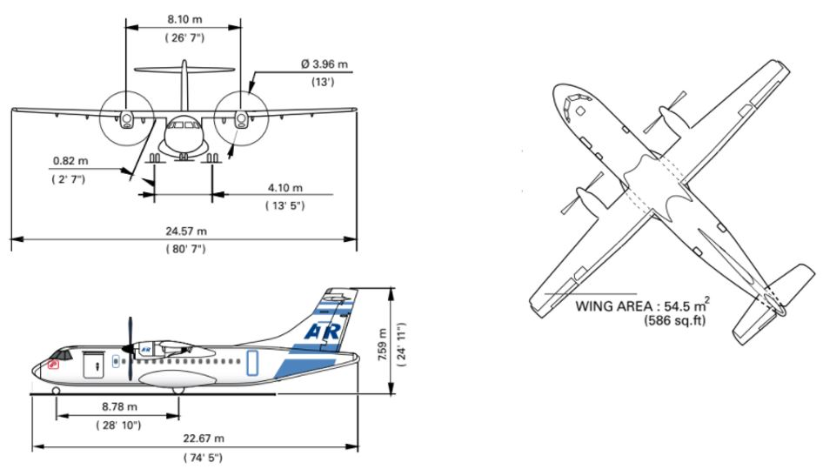
images/parte1/pesquisademercado/dimensoesExternasATR42.jpg
