mthsladeira/projetos1/images/parte1/pesquisademercado/dimensoesExternasBombardierCRJ200.jpg

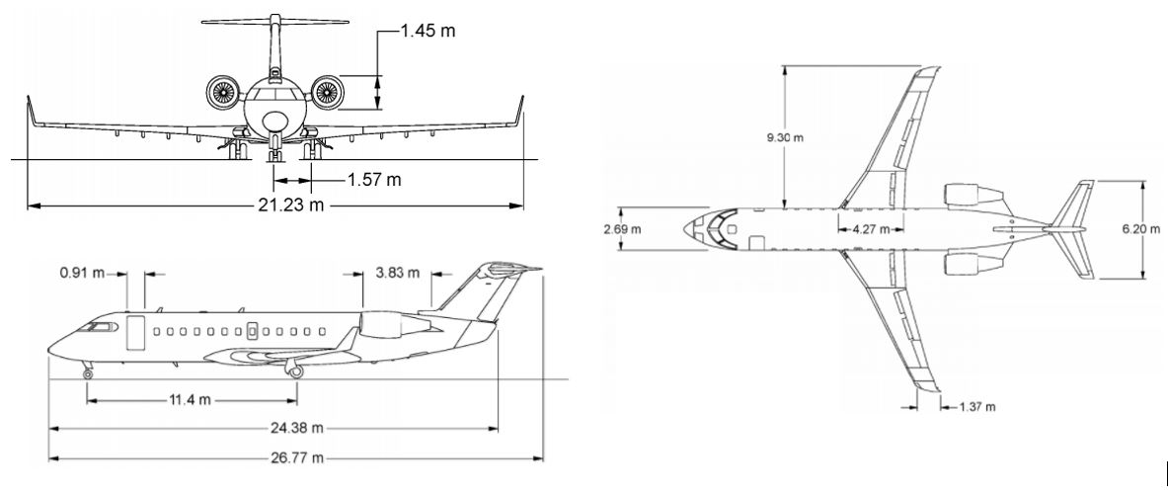
images/parte1/pesquisademercado/dimensoesExternasBombardierCRJ200.jpg
