mthsladeira/projetos1/images/parte1/pesquisademercado/dimensoesExternasBombardierDash8.jpg

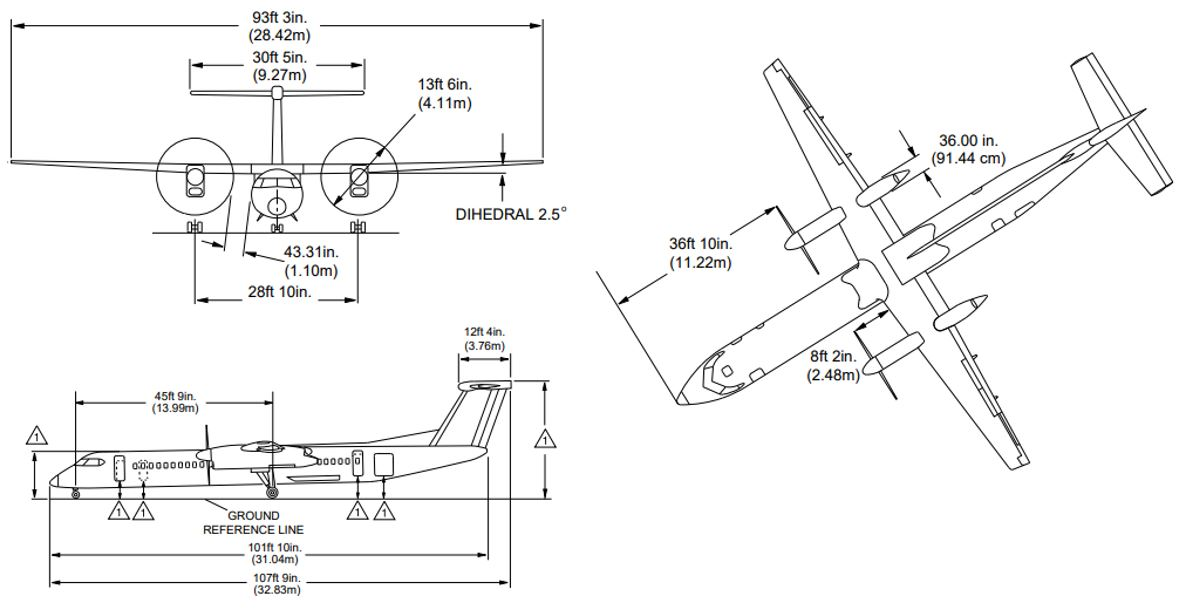
images/parte1/pesquisademercado/dimensoesExternasBombardierDash8.jpg
