mthsladeira/projetos1/images/parte1/pesquisademercado/dimensoesExternasEmbraerE170.jpg

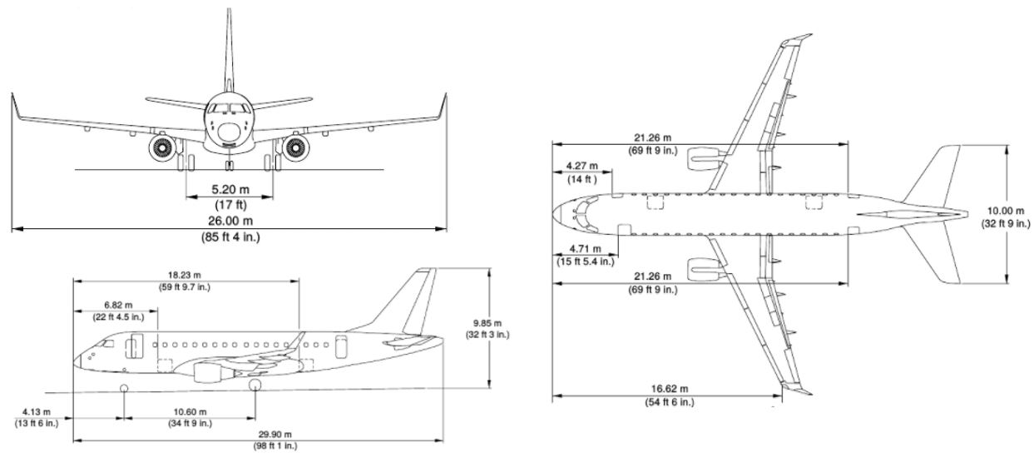
images/parte1/pesquisademercado/dimensoesExternasEmbraerE170.jpg
