mthsladeira/projetos1/images/parte1/pesquisademercado/dimensoesExternasEmbraerEMB120.jpg

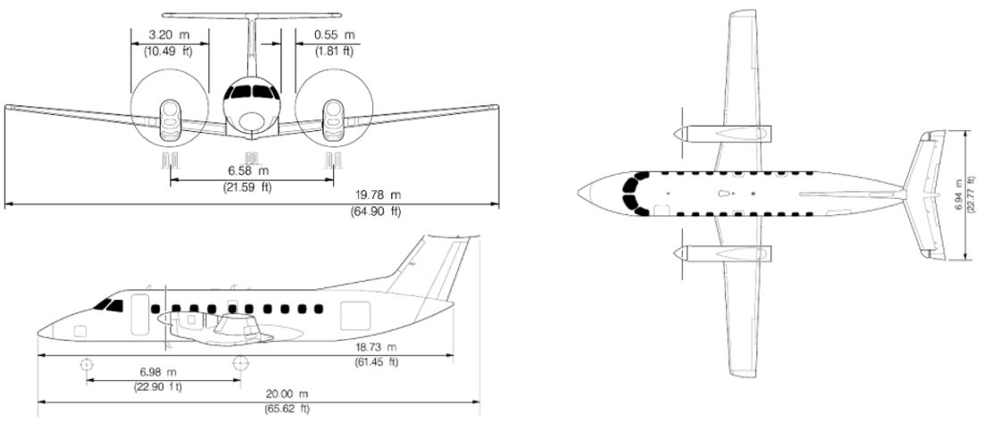
images/parte1/pesquisademercado/dimensoesExternasEmbraerEMB120.jpg
