mthsladeira/projetos1/images/parte1/pesquisademercado/dimensoesExternasEmbraerERJ145.jpg

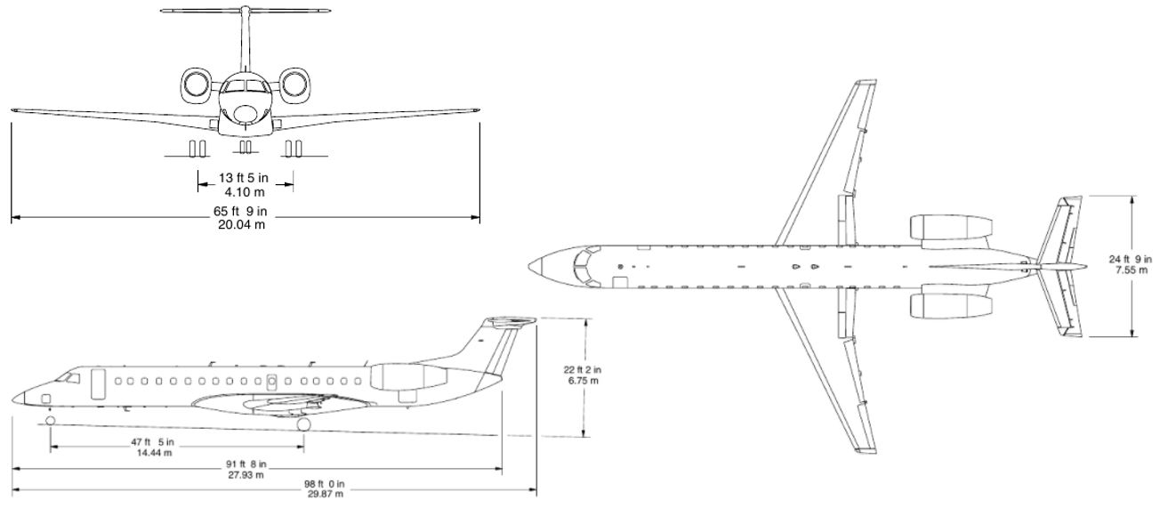
images/parte1/pesquisademercado/dimensoesExternasEmbraerERJ145.jpg
