mthsladeira/projetos1/images/parte1/pesquisademercado/dimensoesInternasATR42.jpg

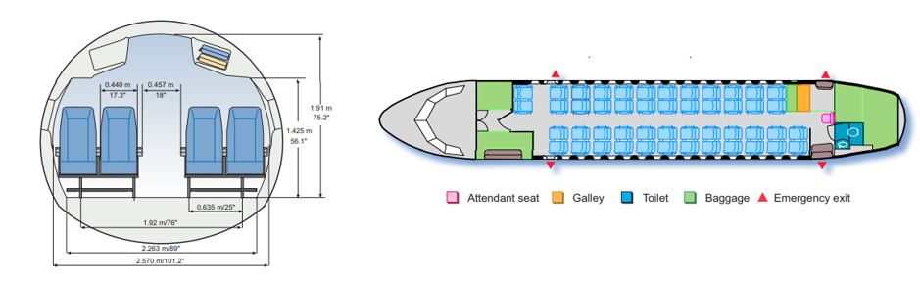
images/parte1/pesquisademercado/dimensoesInternasATR42.jpg
