mthsladeira/projetos1/images/parte1/pesquisademercado/dimensoesInternasBombardierCRJ200.jpg

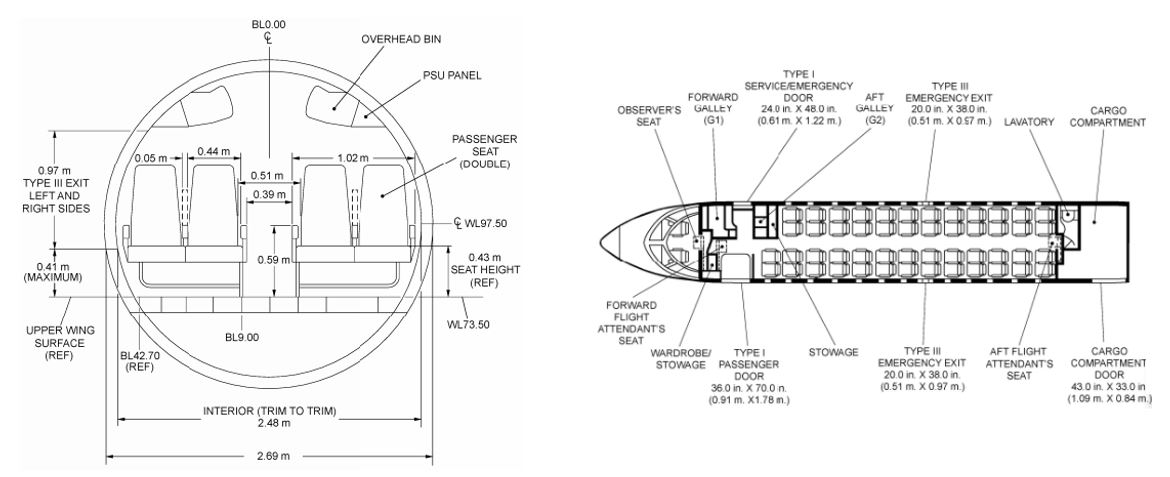
images/parte1/pesquisademercado/dimensoesInternasBombardierCRJ200.jpg
