mthsladeira/projetos1/images/parte1/pesquisademercado/dimensoesInternasBombardierDash8.jpg

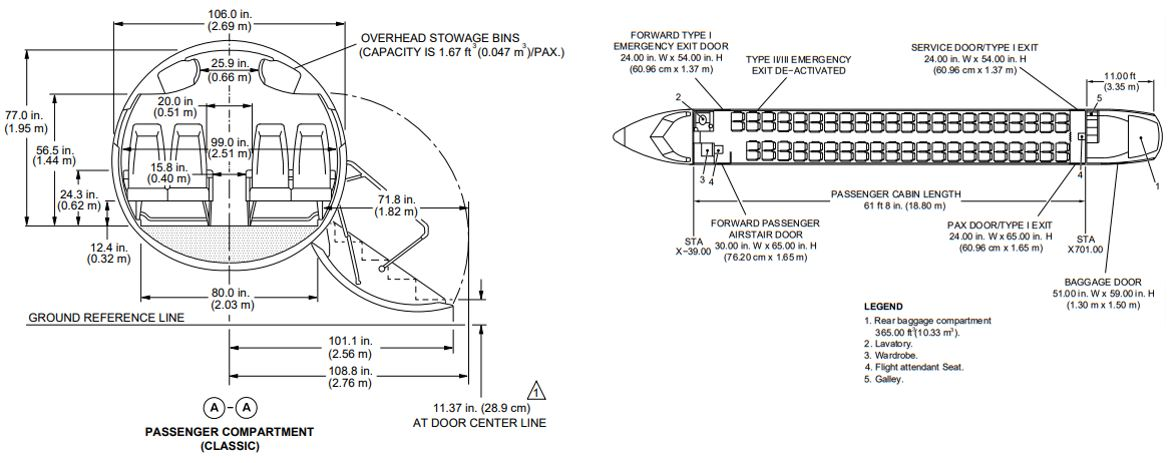
images/parte1/pesquisademercado/dimensoesInternasBombardierDash8.jpg
