mthsladeira/projetos1/images/parte1/pesquisademercado/dimensoesInternasEmbraerE170.jpg

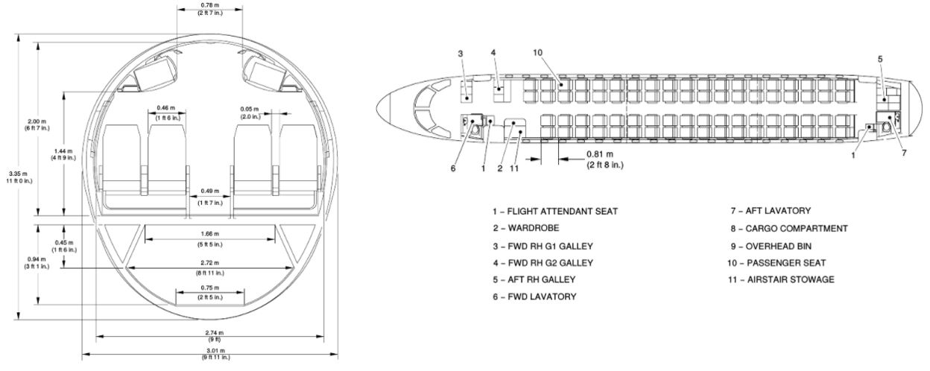
images/parte1/pesquisademercado/dimensoesInternasEmbraerE170.jpg
