mthsladeira/projetos1/images/parte1/pesquisademercado/dimensoesInternasEmbraerEMB120.jpg

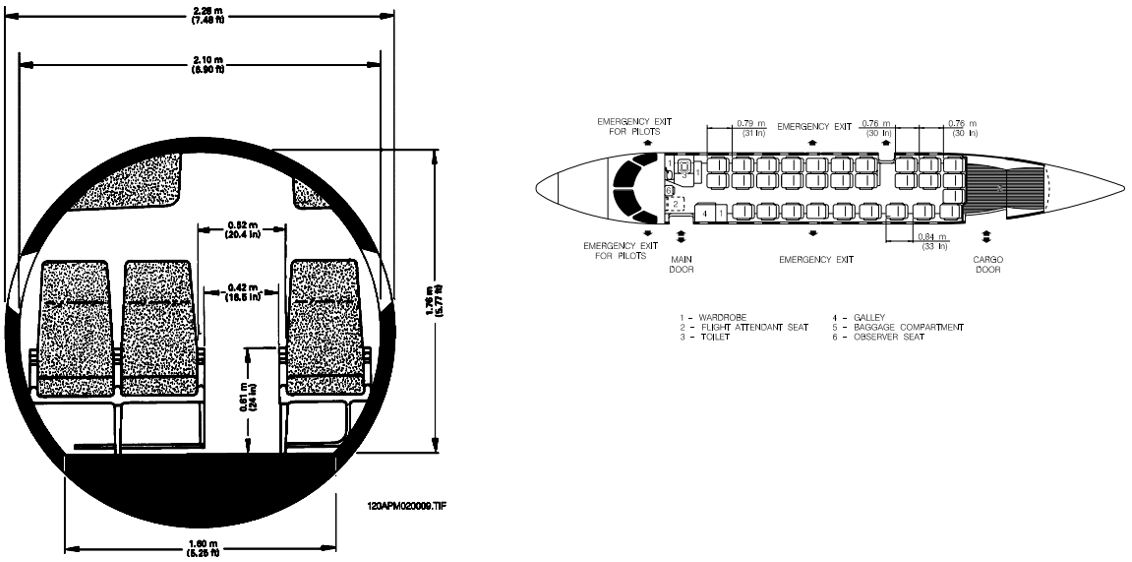
images/parte1/pesquisademercado/dimensoesInternasEmbraerEMB120.jpg
