mthsladeira/projetos1/images/parte1/pesquisademercado/dimensoesInternasEmbraerERJ145.jpg

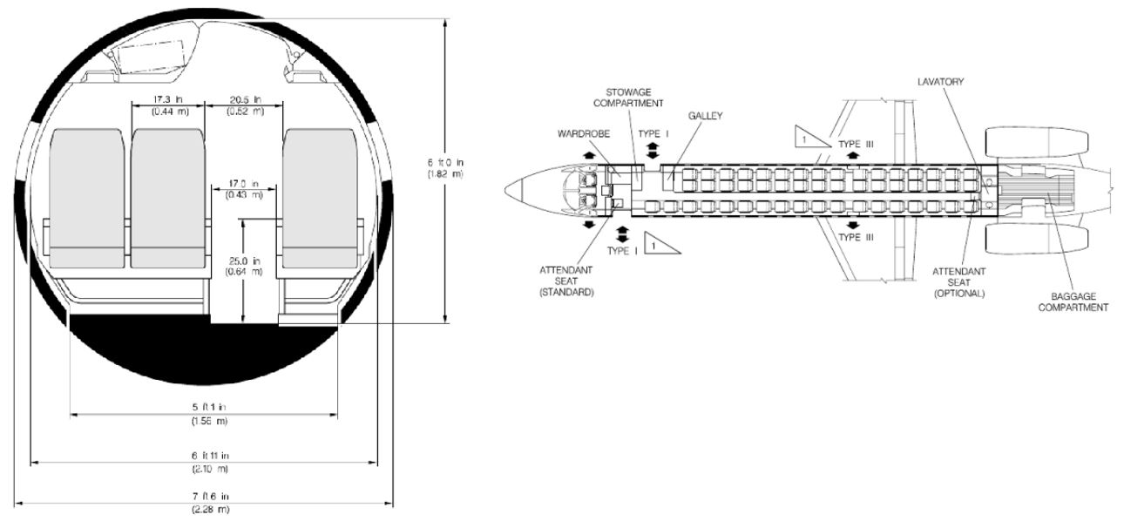
images/parte1/pesquisademercado/dimensoesInternasEmbraerERJ145.jpg
