mthsladeira/projetos1/images/parte1/pesquisademercado/EmbraerE170.jpg

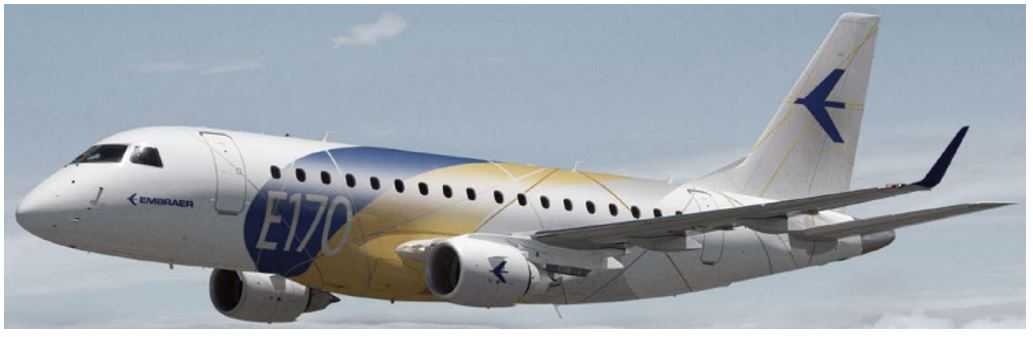
images/parte1/pesquisademercado/EmbraerE170.jpg
