mthsladeira/projetos1/images/parte1/pesquisademercado/EmbraerEMB120.jpg

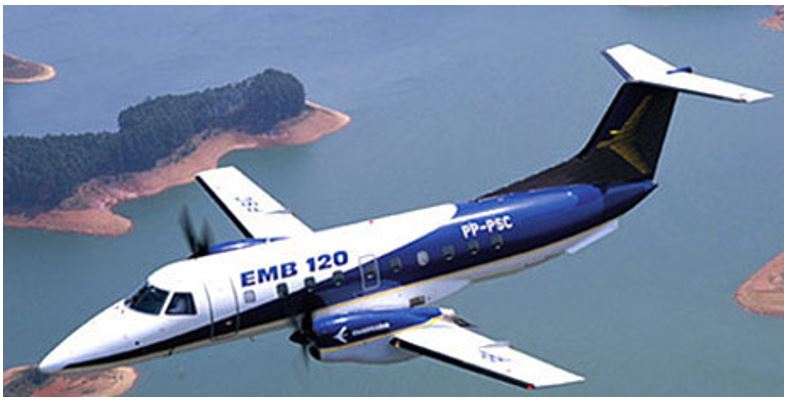
images/parte1/pesquisademercado/EmbraerEMB120.jpg
