mthsladeira/projetos1/images/parte1/pesquisademercado/EmbraerERJ145.jpg

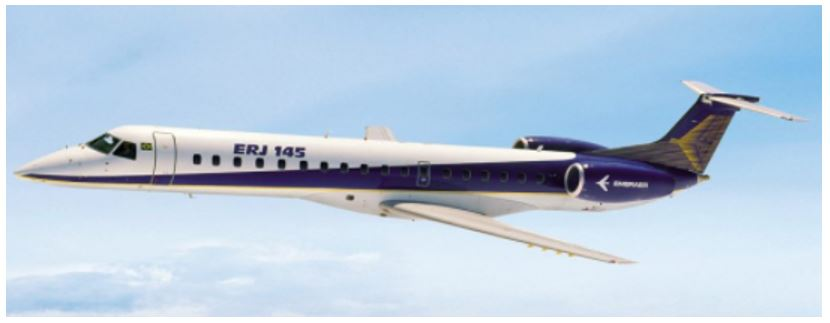
images/parte1/pesquisademercado/EmbraerERJ145.jpg
