mthsladeira/projetos1/images/parte1/pesquisademercado/fleet.jpg

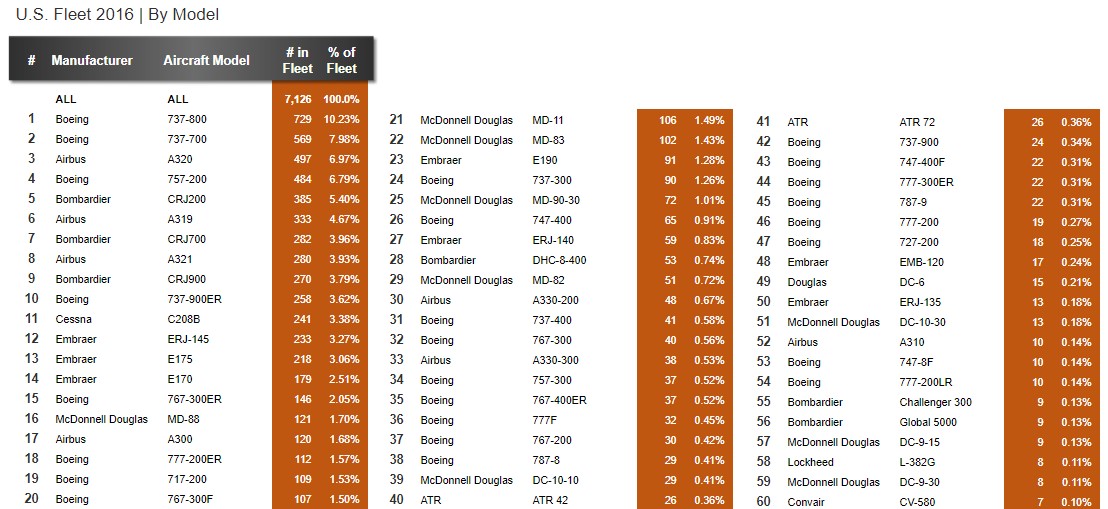
images/parte1/pesquisademercado/fleet.jpg
