mthsladeira/projetos1/images/parte1/pesquisademercado/Frota_EUA.jpg

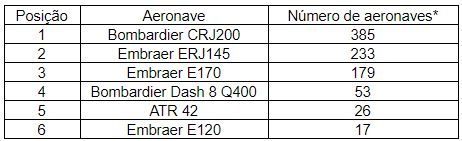
images/parte1/pesquisademercado/Frota_EUA.jpg
