mthsladeira/projetos1/images/parte1/pesquisademercado/major-domestic-markets.png

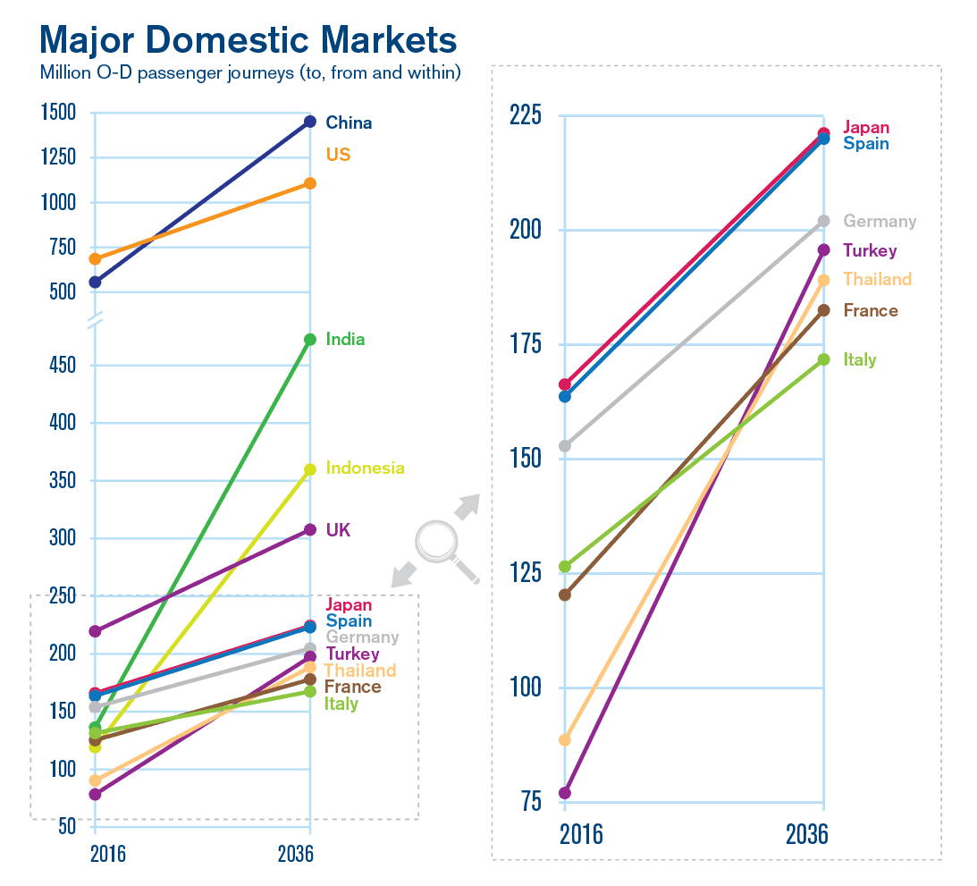
images/parte1/pesquisademercado/major-domestic-markets.png
