mthsladeira/projetos1/images/parte1/pesquisademercado/marketforecast.jpg

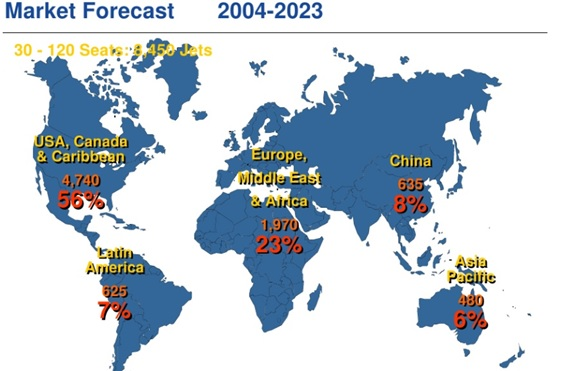
images/parte1/pesquisademercado/marketforecast.jpg
