mthsladeira/projetos1/images/parte1/pesquisademercado/tabelaATR42.jpg

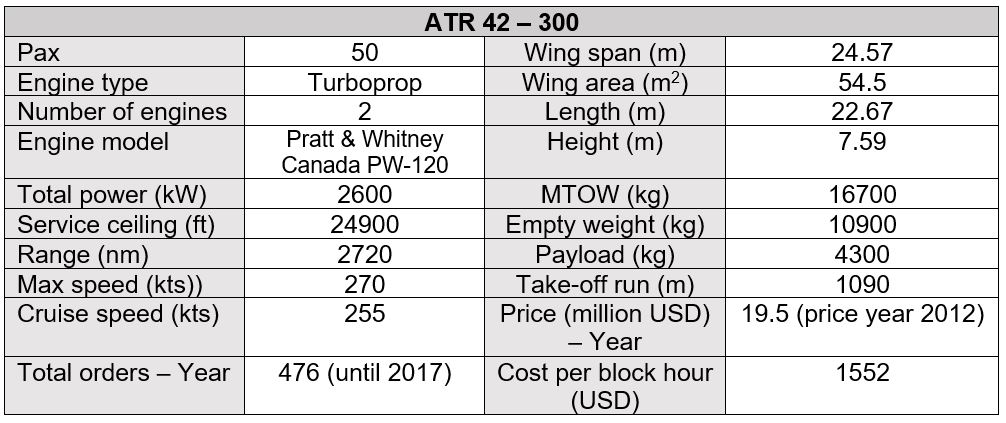
images/parte1/pesquisademercado/tabelaATR42.jpg
