mthsladeira/projetos1/images/parte1/pesquisademercado/tabelaBombardierCRJ200.jpg

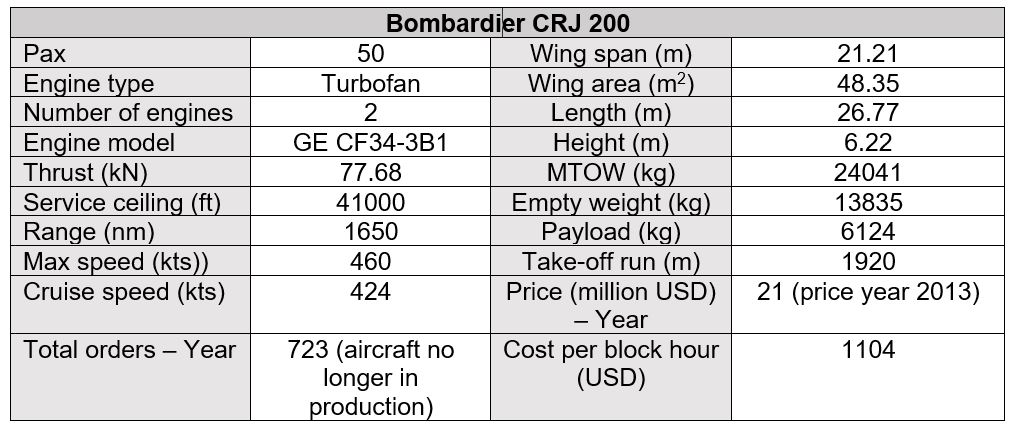
images/parte1/pesquisademercado/tabelaBombardierCRJ200.jpg
