mthsladeira/projetos1/images/parte1/pesquisademercado/tabelaBombardierDash8.jpg

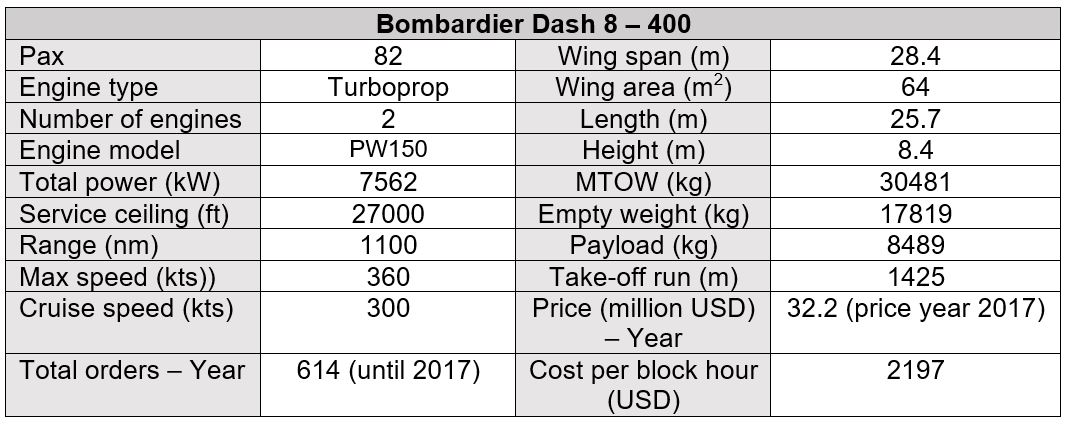
images/parte1/pesquisademercado/tabelaBombardierDash8.jpg
