mthsladeira/projetos1/images/parte1/pesquisademercado/tabelaEmbraerE170.jpg

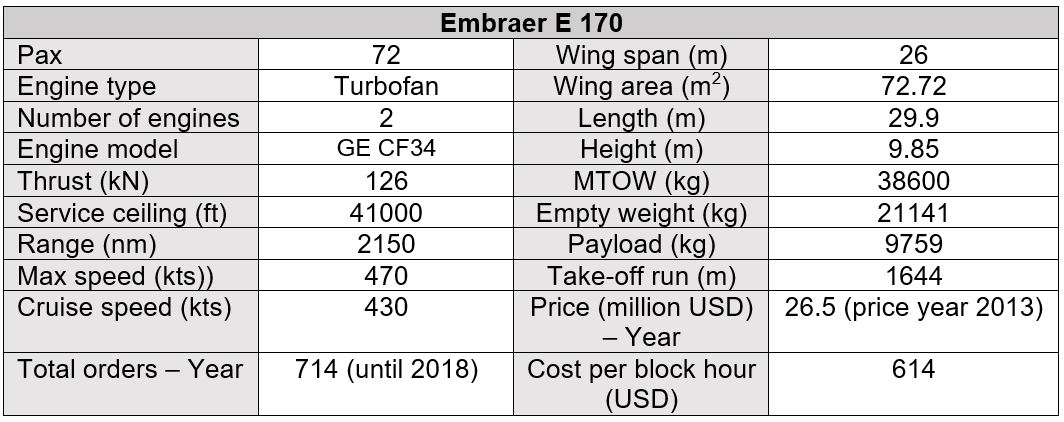
images/parte1/pesquisademercado/tabelaEmbraerE170.jpg
