mthsladeira/projetos1/images/parte1/pesquisademercado/tabelaEmbraerEMB120.jpg

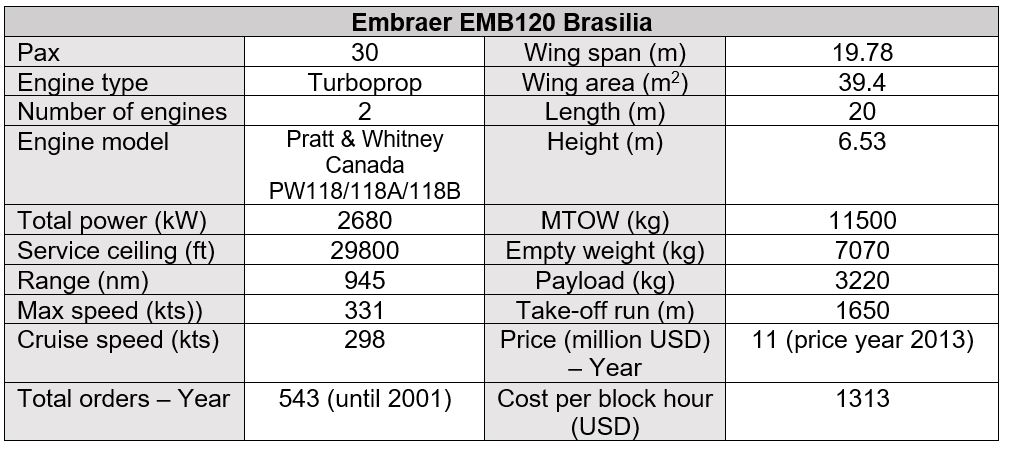
images/parte1/pesquisademercado/tabelaEmbraerEMB120.jpg
