mthsladeira/projetos1/images/parte1/pesquisademercado/tabelaEmbraerERJ145.jpg

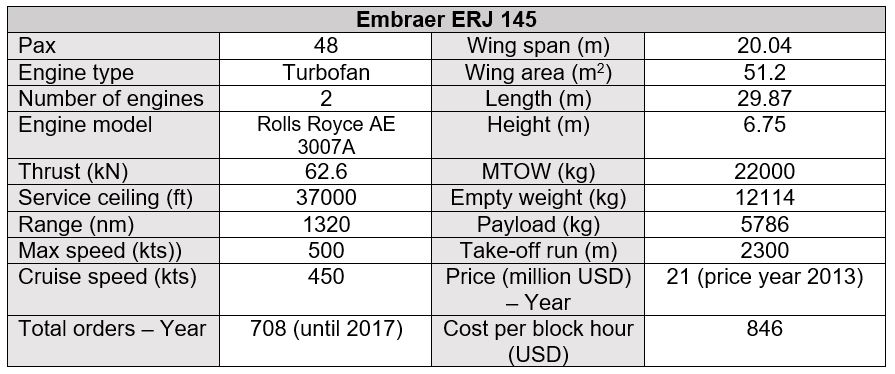
images/parte1/pesquisademercado/tabelaEmbraerERJ145.jpg
