mthsladeira/projetos1/images/parte2/graficosMotores.JPG

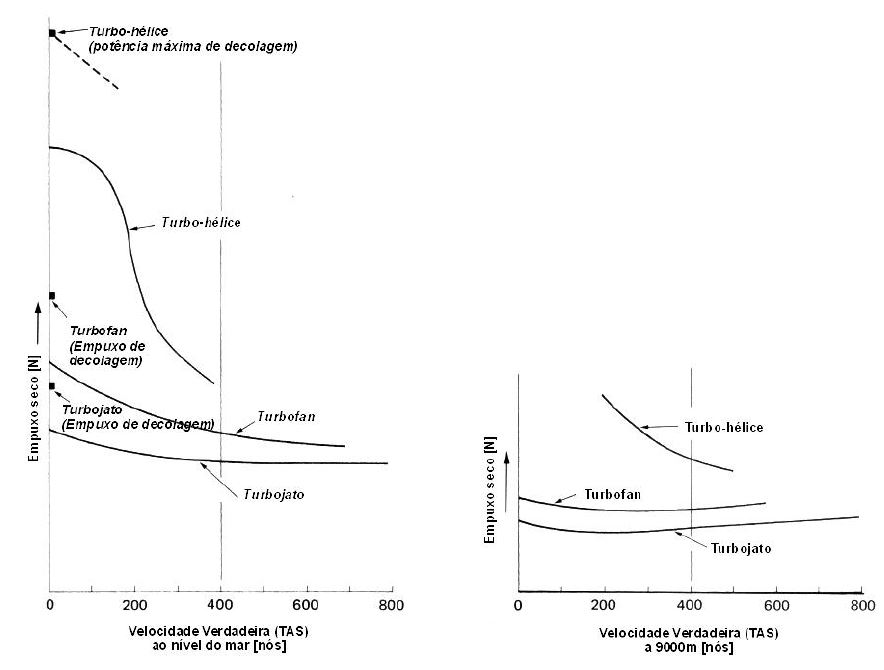
images/parte2/graficosMotores.JPG
