mthsladeira/projetos1/images/parte3/asa_cl_alfa.png

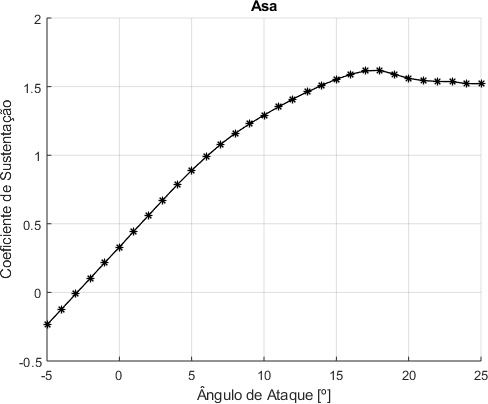
images/parte3/asa_cl_alfa.png
