mthsladeira/projetos1/images/parte3/asa_cl_cd.png

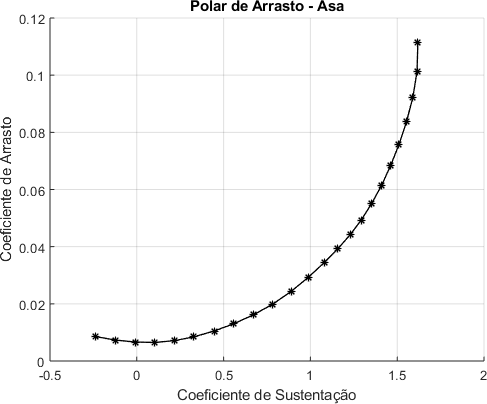
images/parte3/asa_cl_cd.png
