mthsladeira/projetos1/images/parte3/comparacao_deflexao.png

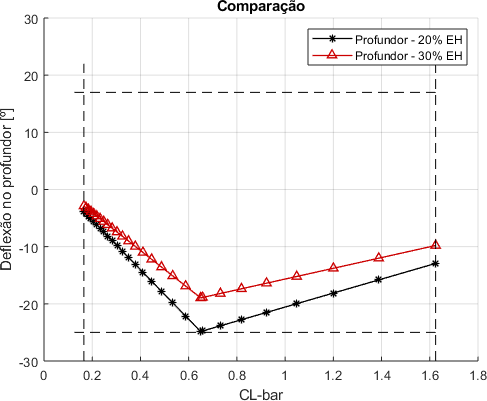
images/parte3/comparacao_deflexao.png
