mthsladeira/projetos1/images/parte3/comparacao_hingemoment.png

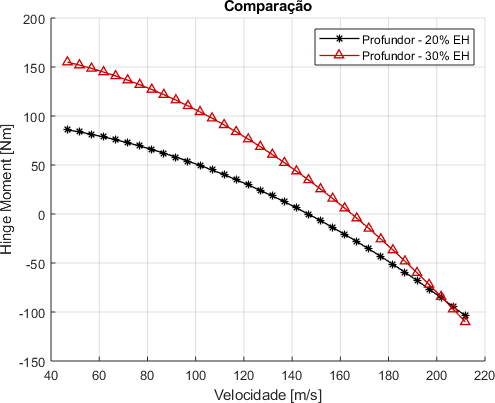
images/parte3/comparacao_hingemoment.png
