mthsladeira/projetos1/images/parte3/De_equi_c20.png

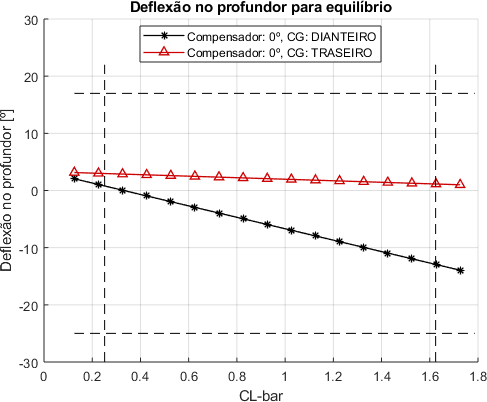
images/parte3/De_equi_c20.png
