mthsladeira/projetos1/images/parte3/diagramavn_asalimpa.png

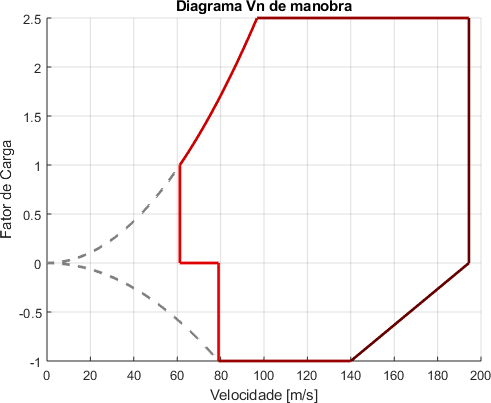
images/parte3/diagramavn_asalimpa.png
