mthsladeira/projetos1/images/parte3/eh_cl_alfa.png

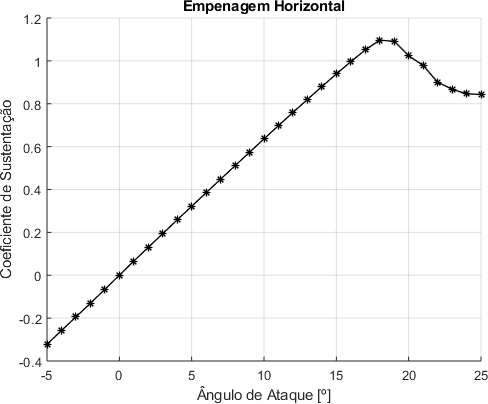
images/parte3/eh_cl_alfa.png
