mthsladeira/projetos1/images/parte3/eh_cl_cd.png

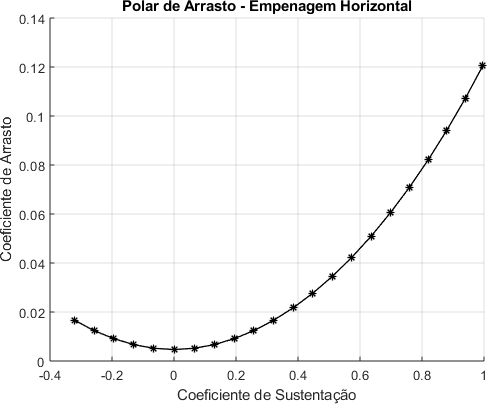
images/parte3/eh_cl_cd.png
