mthsladeira/projetos1/images/parte3/ev_cl_alfa.png

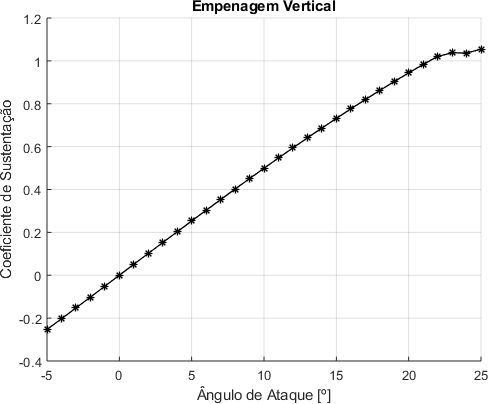
images/parte3/ev_cl_alfa.png
