mthsladeira/projetos1/images/parte3/ev_cl_cd.png

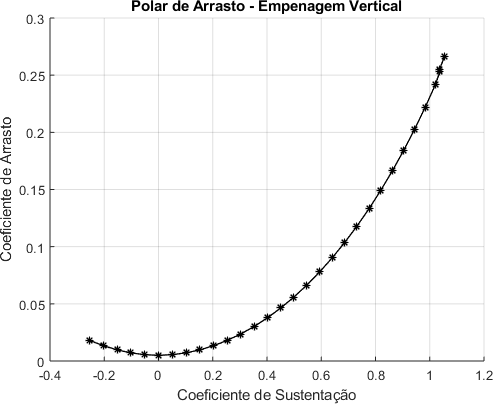
images/parte3/ev_cl_cd.png
