mthsladeira/projetos1/images/parte3/loads_bending.png

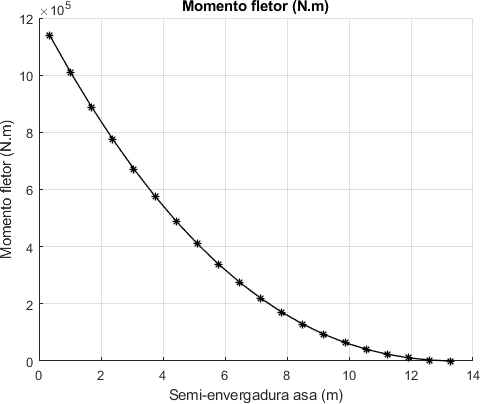
images/parte3/loads_bending.png
