mthsladeira/projetos1/images/parte3/loads_lift.png

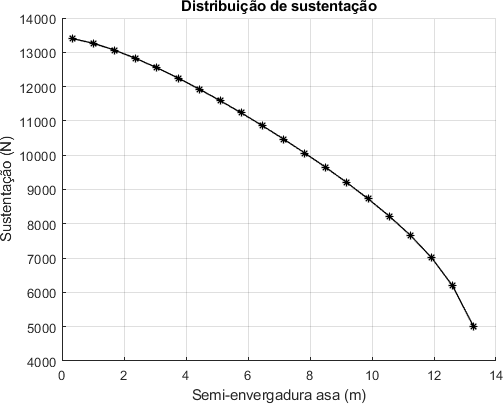
images/parte3/loads_lift.png
