mthsladeira/projetos1/images/parte3/loads_shear.png

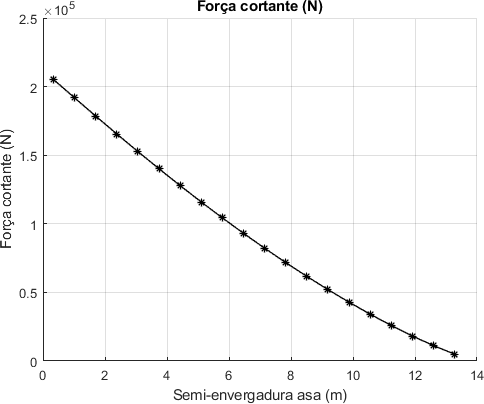
images/parte3/loads_shear.png
