mthsladeira/projetos1/images/parte3/malha_eh.PNG

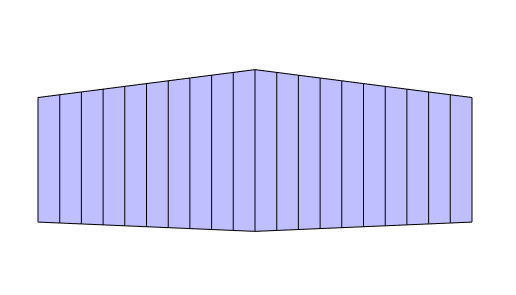
images/parte3/malha_eh.PNG
