mthsladeira/projetos1/images/parte3/malha_ev.PNG

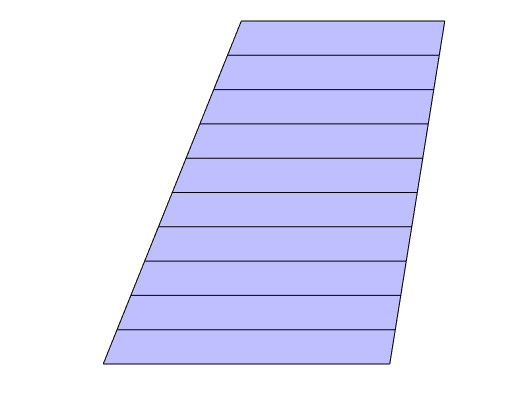
images/parte3/malha_ev.PNG
