mthsladeira/projetos1/images/parte3/passeioCG.PNG

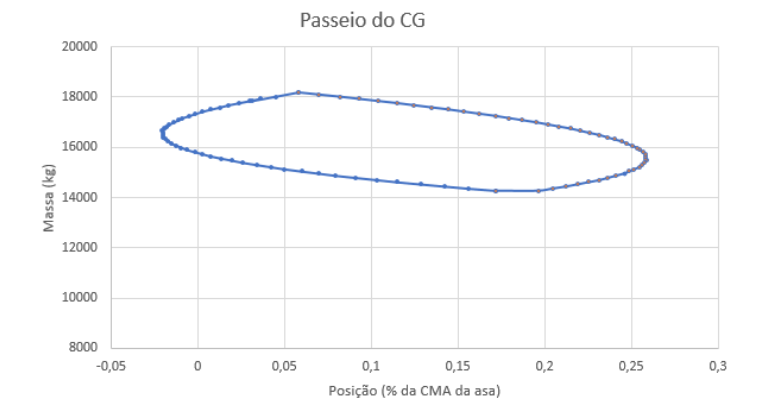
images/parte3/passeioCG.PNG
