mthsladeira/projetos1/images/parte3/sistemas_ambientacao.png

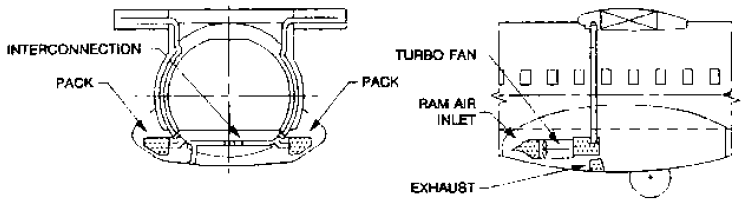
images/parte3/sistemas_ambientacao.png
