mthsladeira/projetos1/images/parte3/sistemas_ambientacao_esquema.png

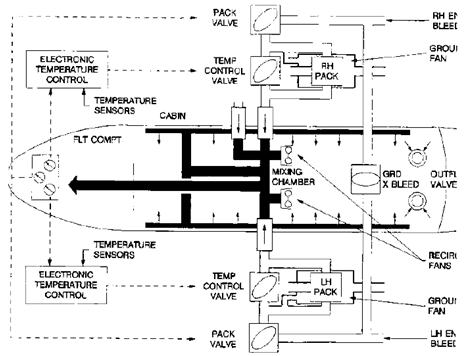
images/parte3/sistemas_ambientacao_esquema.png
