mthsladeira/projetos1/images/parte3/sistemas_ambientacao_esquema_2.png

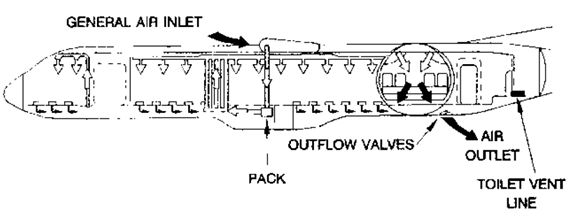
images/parte3/sistemas_ambientacao_esquema_2.png
