mthsladeira/projetos1/images/parte3/sistemas_antigelo_degelo.png

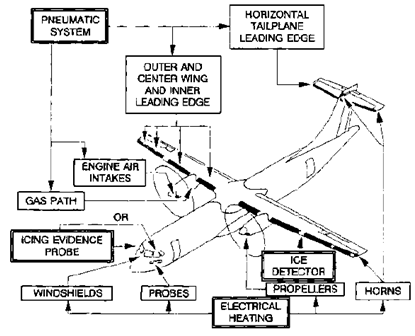
images/parte3/sistemas_antigelo_degelo.png
