mthsladeira/projetos1/images/parte3/sistemas_combustivel.png

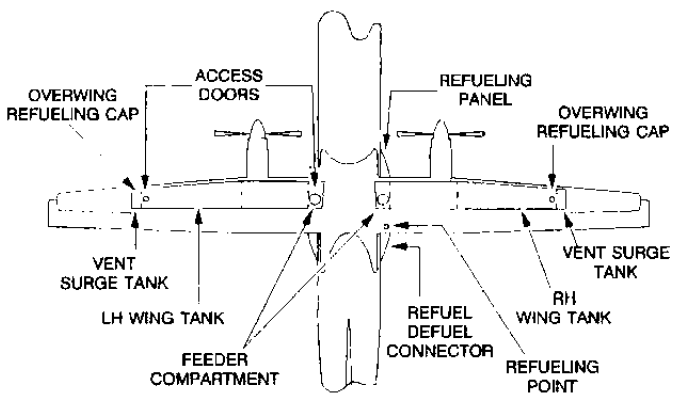
images/parte3/sistemas_combustivel.png
