mthsladeira/projetos1/images/parte3/sistemas_extincao_incendio.png

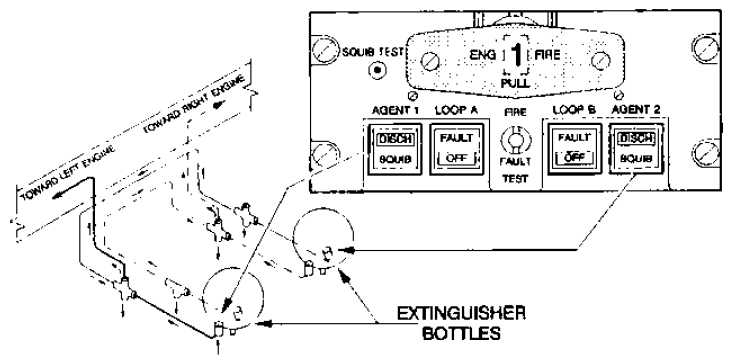
images/parte3/sistemas_extincao_incendio.png
