mthsladeira/projetos1/images/parte3/sistemas_hidraulico.png

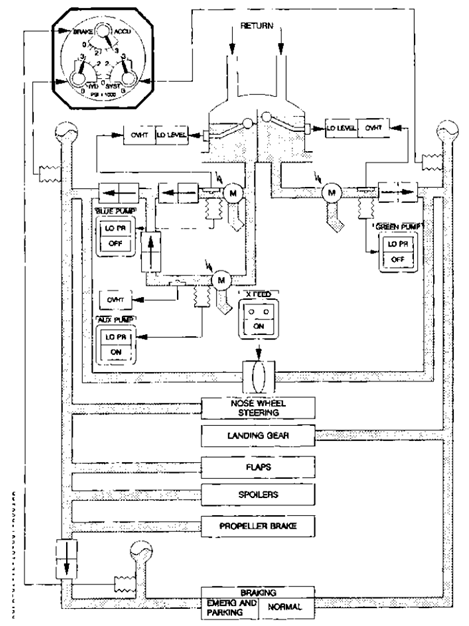
images/parte3/sistemas_hidraulico.png
