mthsladeira/projetos1/images/parte3/sistemas_instrumentacao.png

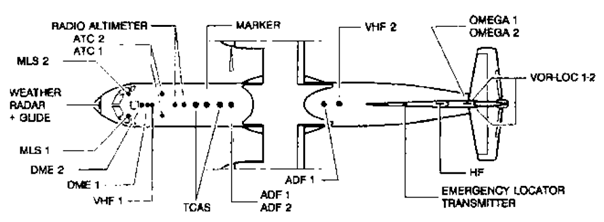
images/parte3/sistemas_instrumentacao.png
