mthsladeira/projetos1/images/parte3/sistemas_pressurizacao.png

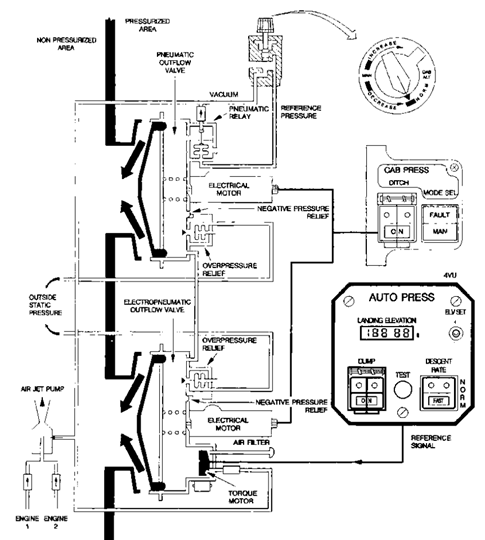
images/parte3/sistemas_pressurizacao.png
