mthsladeira/projetos1/images/parte3/sistemas_trem_de_pouso.png

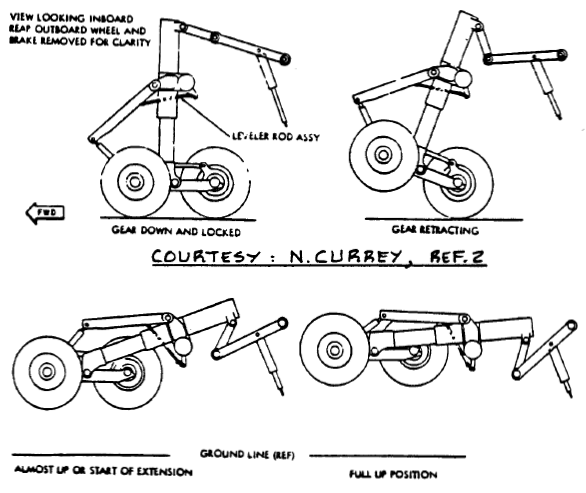
images/parte3/sistemas_trem_de_pouso.png
