mthsladeira/projetos1/images/parte4/aero0.png

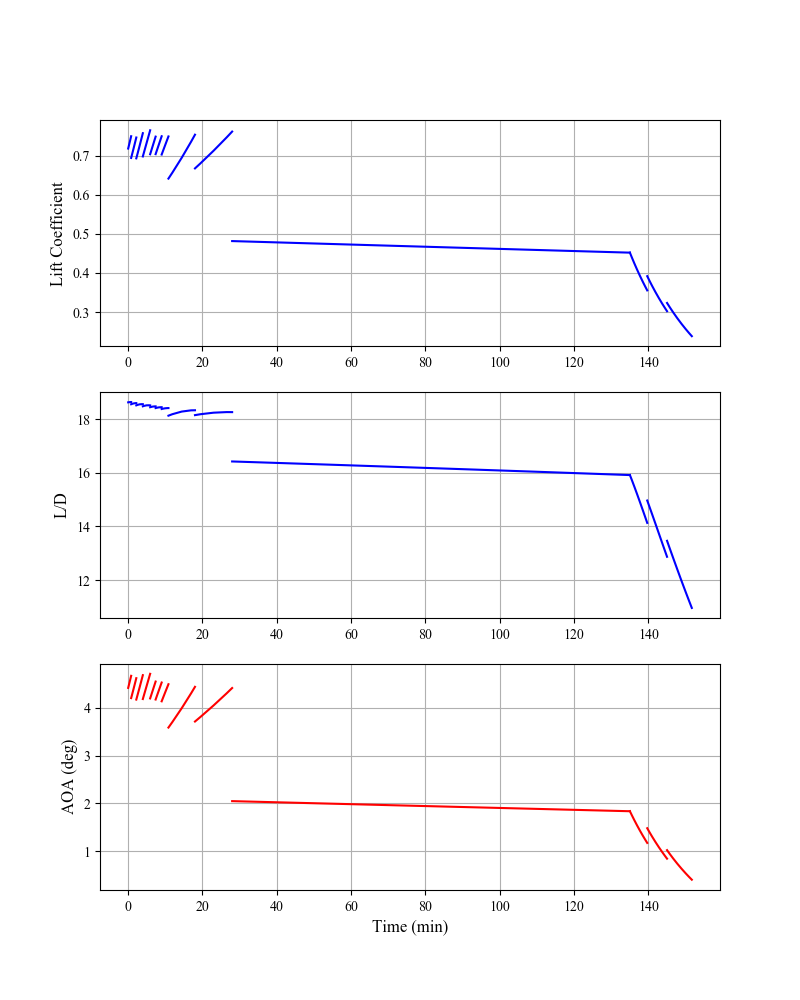
images/parte4/aero0.png
