mthsladeira/projetos1/images/parte4/avl.JPG

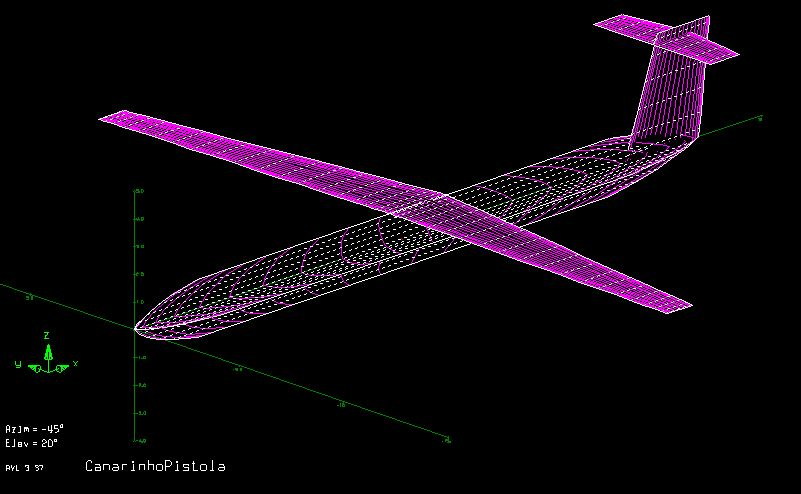
images/parte4/avl.JPG
