mthsladeira/projetos1/images/parte4/cp.png

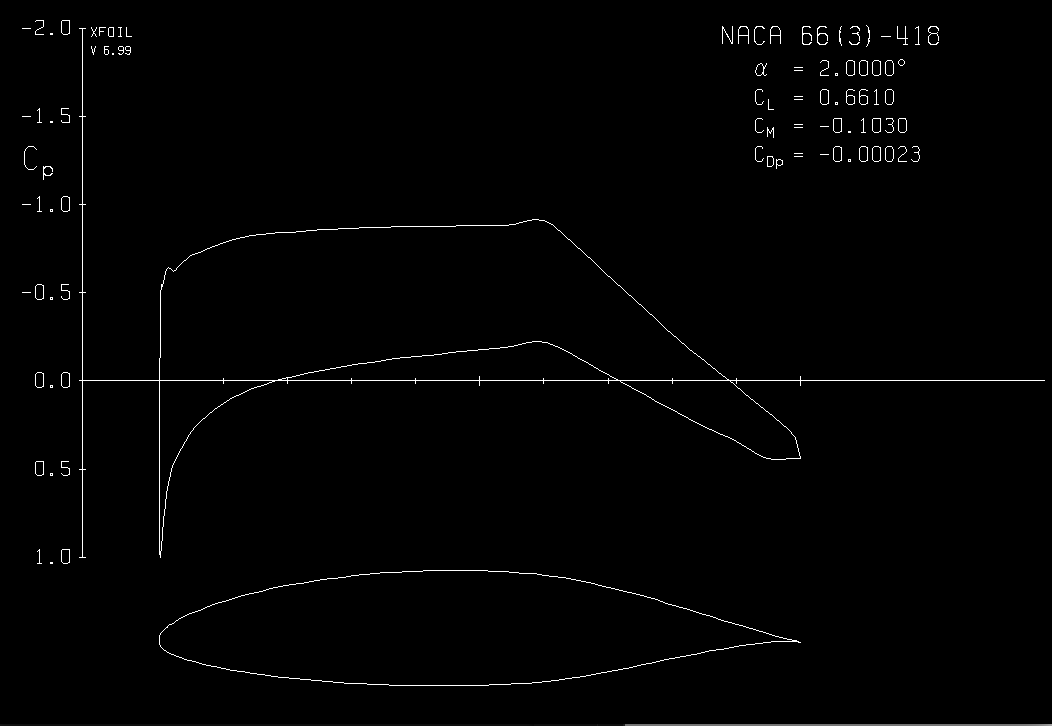
images/parte4/cp.png
