mthsladeira/projetos1/images/parte4/engine0.png

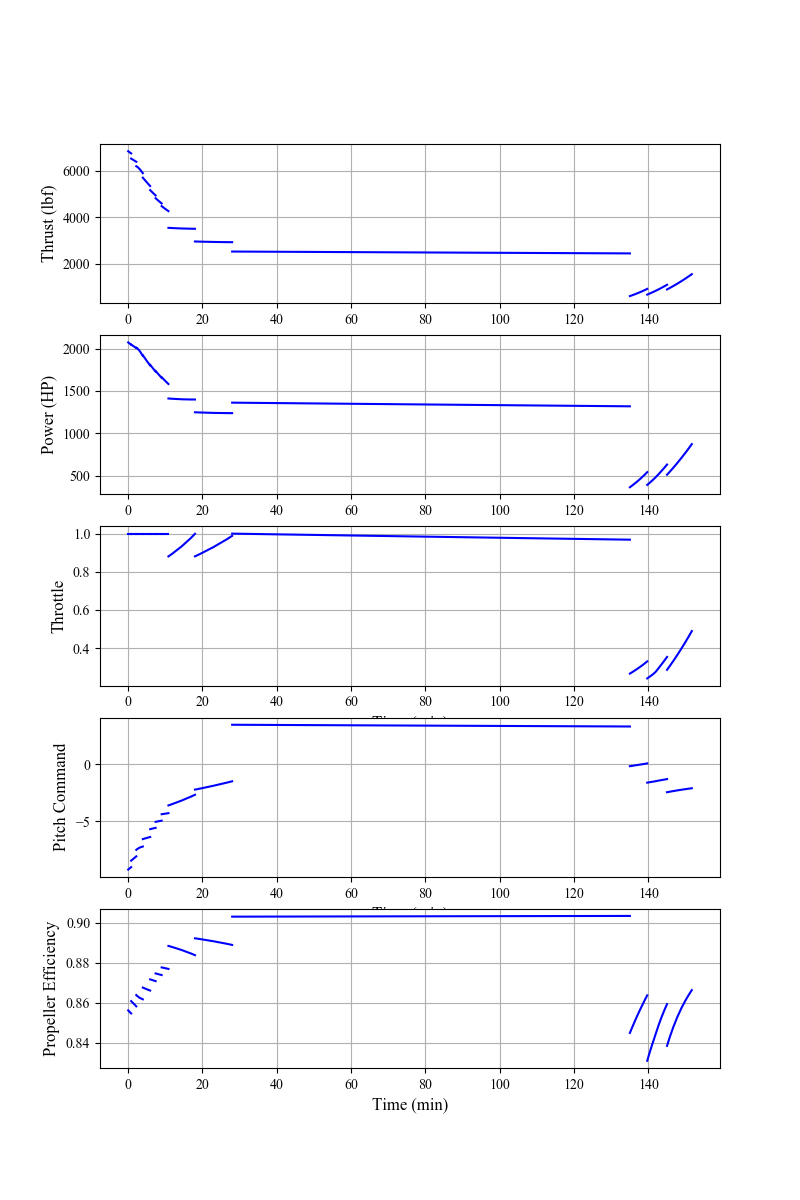
images/parte4/engine0.png
