mthsladeira/projetos1/images/parte4/LFL.JPG

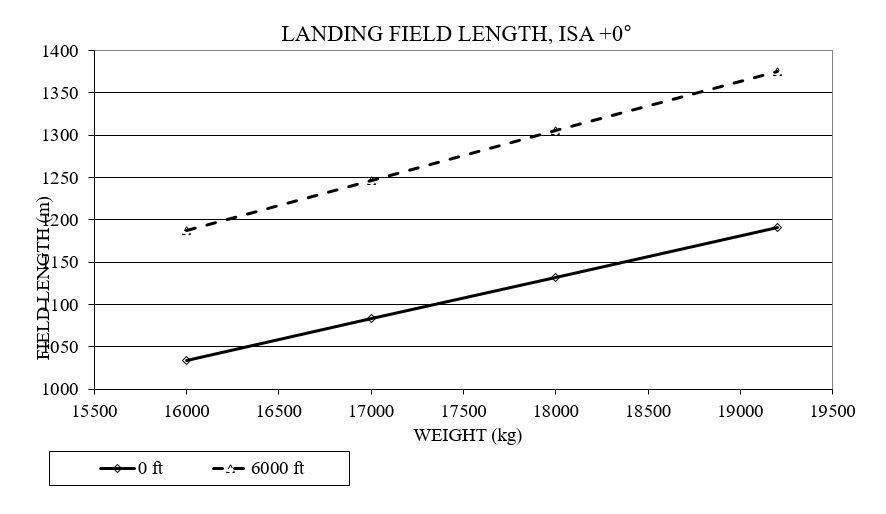
images/parte4/LFL.JPG
