mthsladeira/projetos1/images/parte4/missao_tipica_generica.PNG

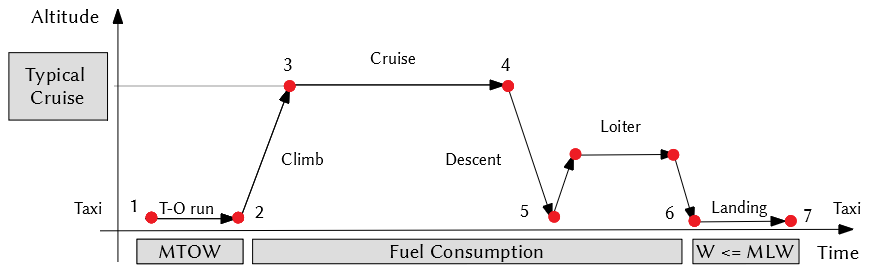
images/parte4/missao_tipica_generica.PNG
