mthsladeira/projetos1/images/parte4/mission0.png

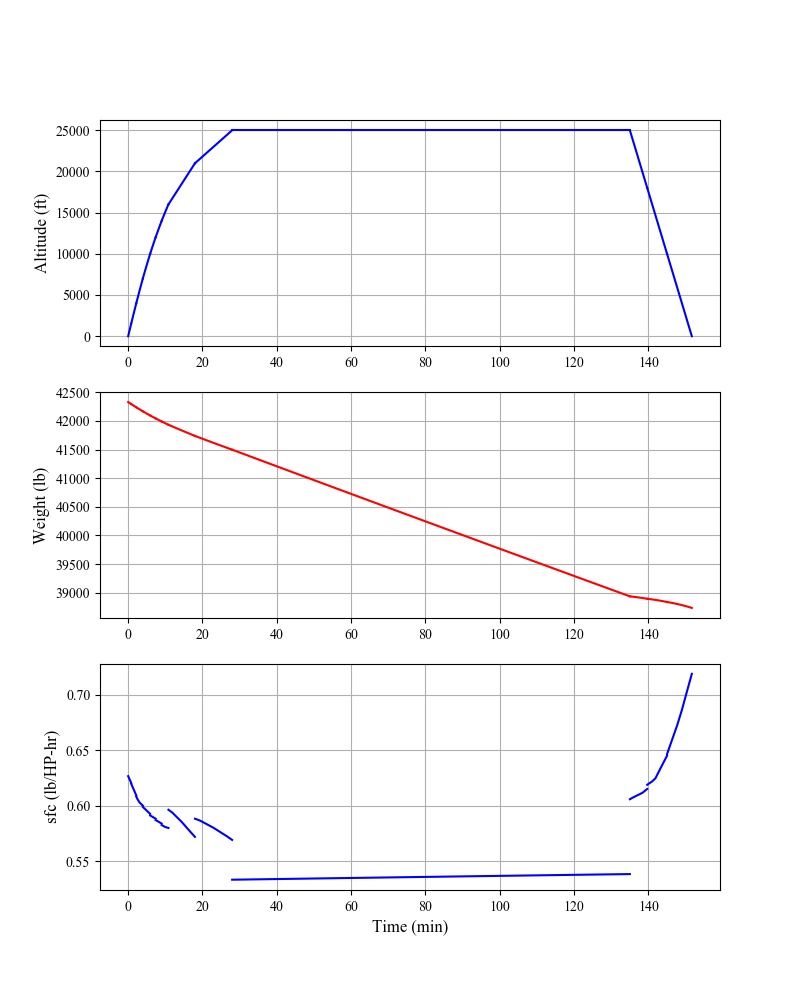
images/parte4/mission0.png
