mthsladeira/projetos1/images/parte4/nervura2.JPG

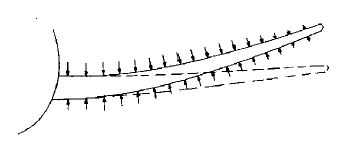
images/parte4/nervura2.JPG
