mthsladeira/projetos1/images/parte4/nervura.JPG

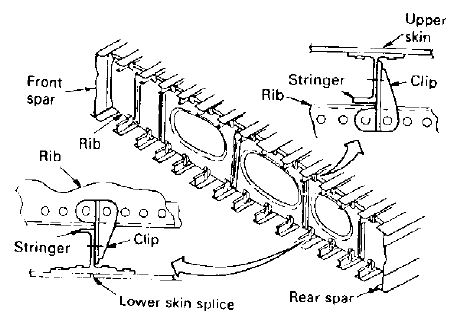
images/parte4/nervura.JPG
