mthsladeira/projetos1/images/parte4/payload_range.JPG

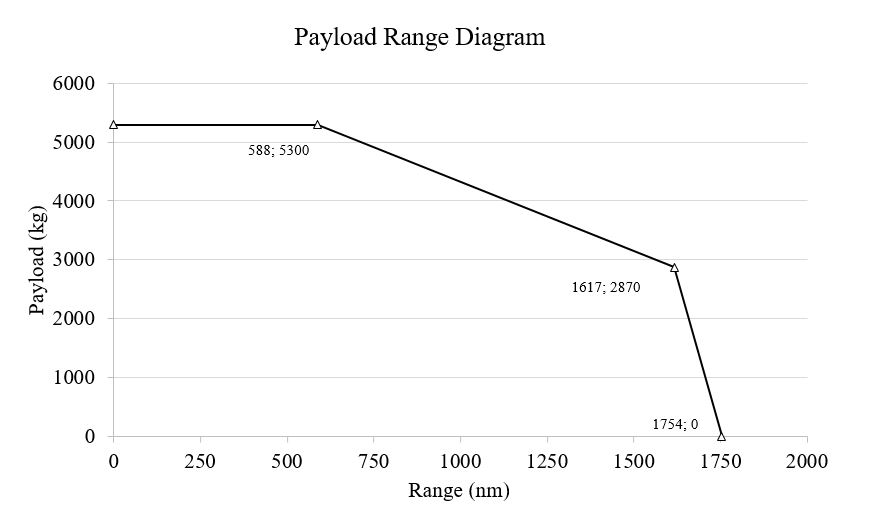
images/parte4/payload_range.JPG
