mthsladeira/projetos1/images/parte4/payloadrangediagram.png

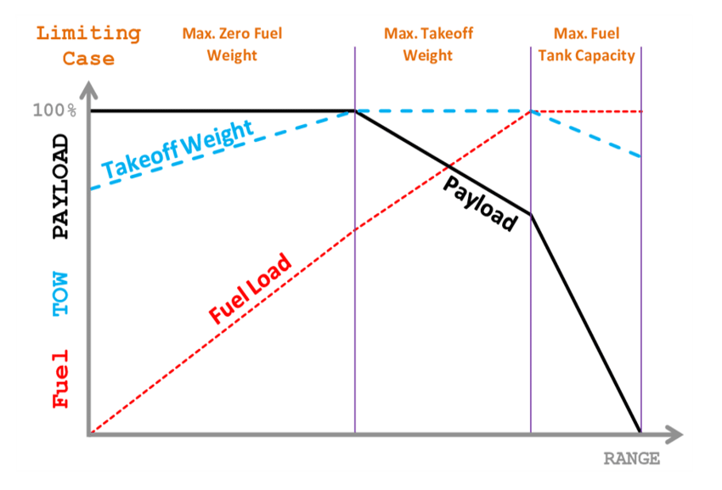
images/parte4/payloadrangediagram.png
