mthsladeira/projetos1/images/parte4/TOFL.JPG

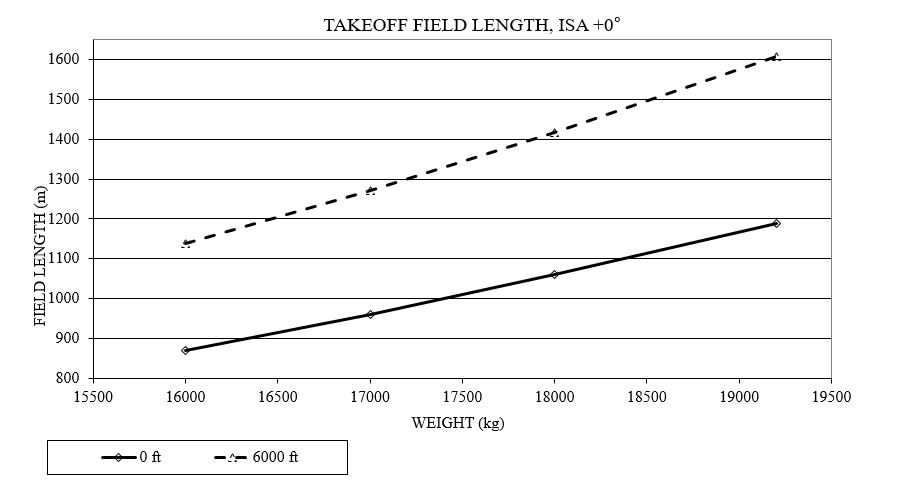
images/parte4/TOFL.JPG
