mthsladeira/projetos1/images/parte4/vel0.png

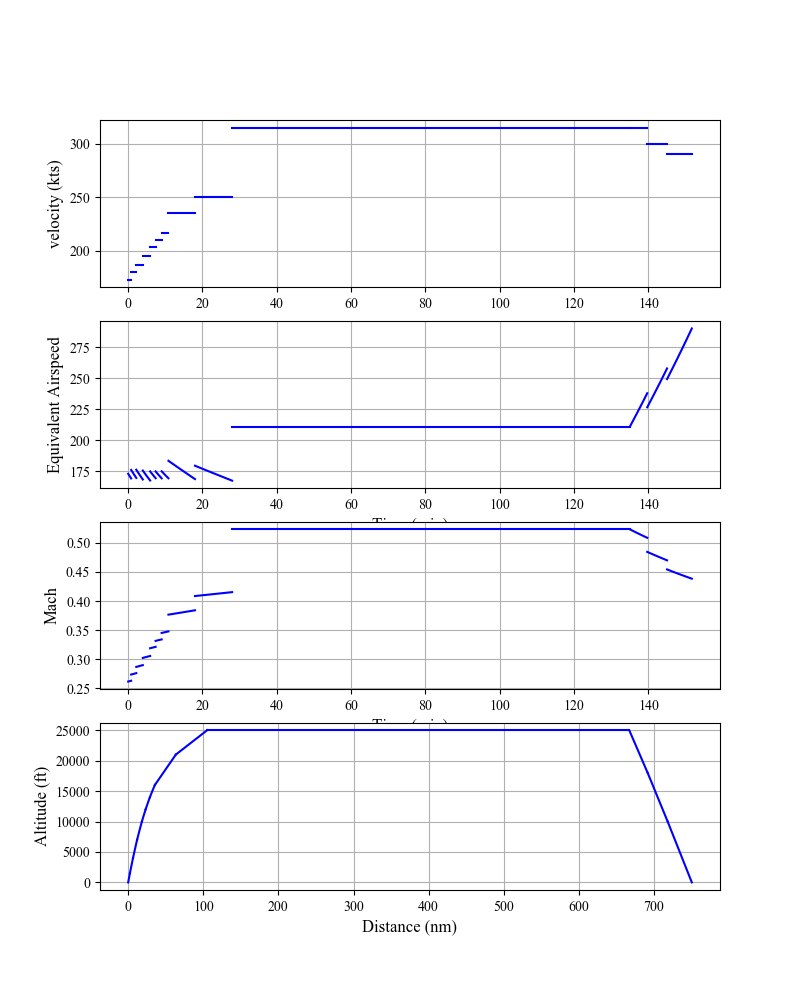
images/parte4/vel0.png
