mthsladeira/projetos1/Desenho/Aeronave.SLDASM

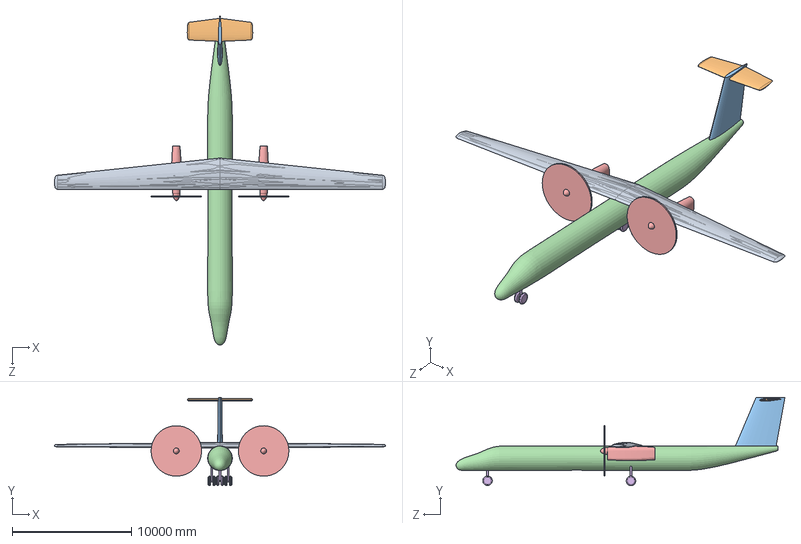
[picture p97: CAD file, 2018-10-27]
Desenho/Aeronave.SLDASM
27740.0 x 7412.8 x 27569.7 mm
Asa
Empenagem horizontal
Empenagem vertical
Fuselagem
Motor x 2
Trem de Pouso x 3
