mthsladeira/projetos1/Desenho/Asa.SLDPRT

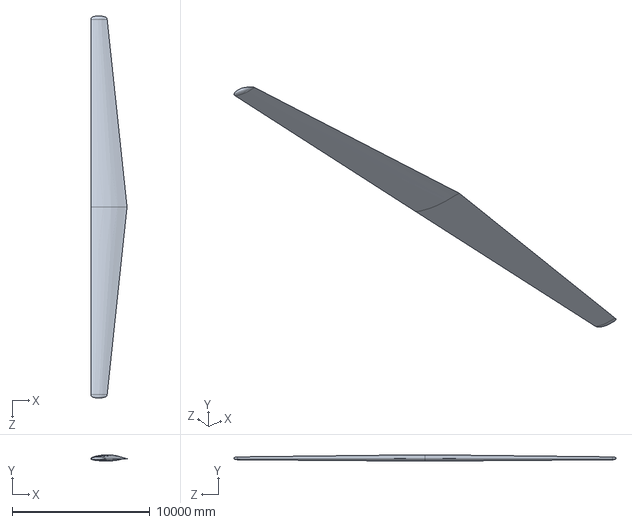
[picture p98: CAD file, 2018-11-25]
Desenho/Asa.SLDPRT
2623.2 x 463.6 x 27740.0 mm
