mthsladeira/projetos1/Desenho/Empenagem vertical.SLDPRT

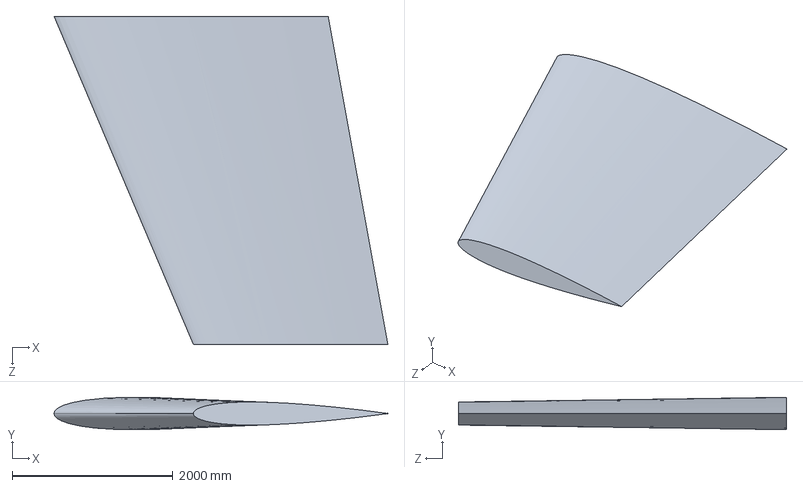
[picture p99: CAD file, 2018-10-27]
Desenho/Empenagem vertical.SLDPRT
4152.5 x 403.1 x 4080.0 mm
