mthsladeira/projetos1/Desenho/Empenagem horizontal.SLDPRT

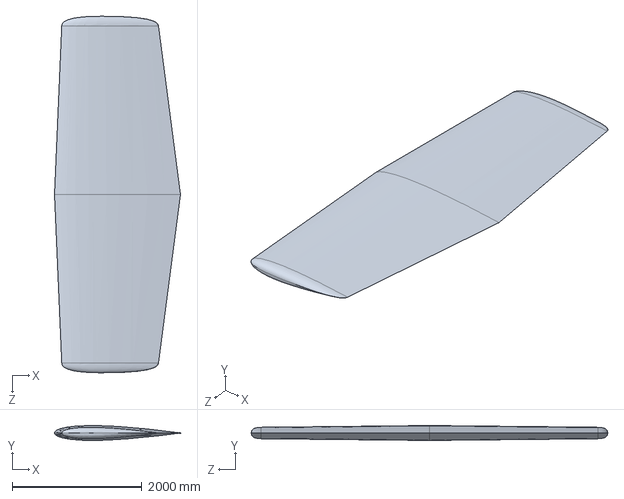
[picture p100: CAD file, 2018-10-27]
Desenho/Empenagem horizontal.SLDPRT
1940.0 x 230.2 x 5490.0 mm
