mthsladeira/projetos1/Desenho/Fuselagem.SLDPRT

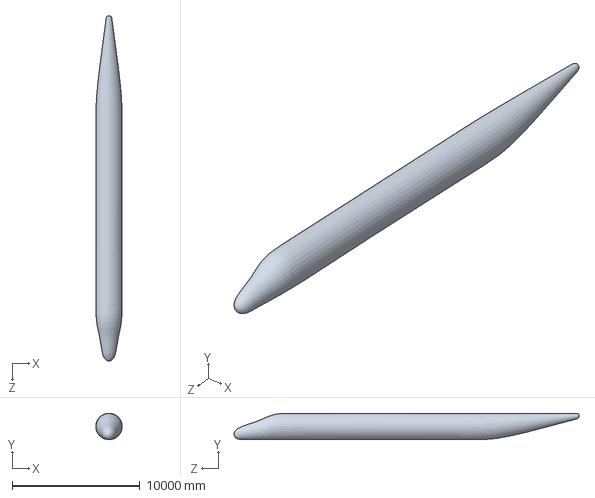
[picture p101: CAD file, 2018-09-24]
Desenho/Fuselagem.SLDPRT
2070.8 x 2073.6 x 27000.0 mm
