mthsladeira/projetos1/Desenho/Trem de Pouso.SLDPRT

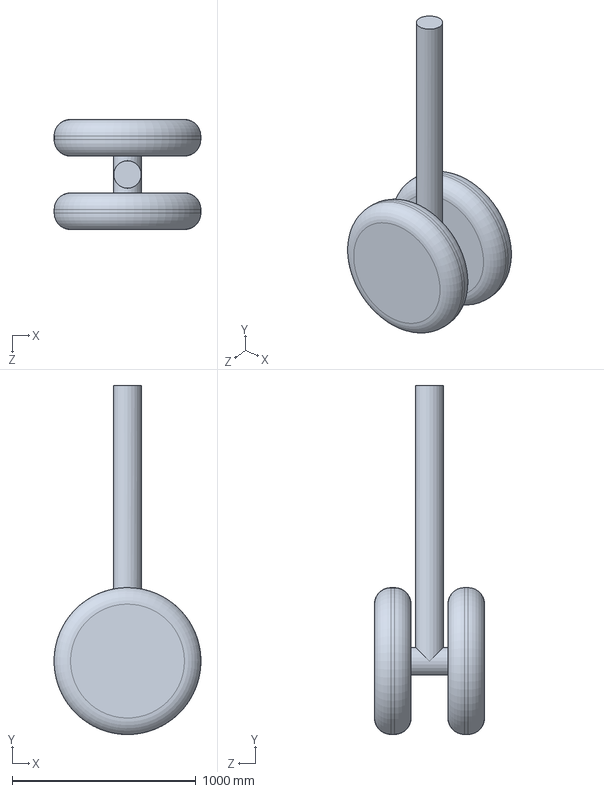
[picture p102: CAD file, 2018-06-22]
Desenho/Trem de Pouso.SLDPRT
800.0 x 1899.8 x 600.0 mm
