mthsladeira/projetos1/Desenho/Motor.SLDPRT

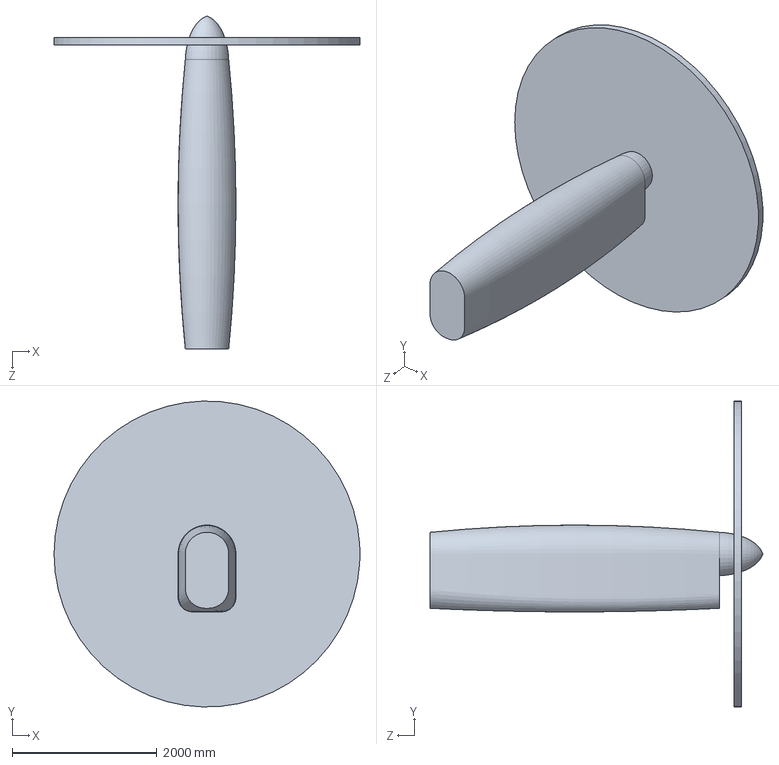
[picture p103: CAD file, 2018-06-22]
Desenho/Motor.SLDPRT
4226.0 x 4224.1 x 4600.0 mm
