mthsladeira/projetos1/(list of files, cad)

Other CAD files:
Desenho/fuselagem_estrutura_transversal.DWG
Desenho/fuselagem_estrutura.DWG
Desenho/EH.DWG
Desenho/posicao sistemas.dwg
Desenho/mecanismo_atuacao2.dwg
Desenho/nervuras.DWG
Desenho/nervuras_EH.DWG
Desenho/mecanismo_atuacao.DWG
Desenho/Aeronave.DWG
Desenho/Aeronave.SLDDRW
Desenho/Asa.DWG
Desenho/Asa.x_t
