mthsladeira/projetos1/TODO.txt

tdp foi modificado de forma que o do nariz leva agora 18% da carga ao inves de 15%
