mthsladeira/projetos1/text/parte3/3vistas (sld).pdf

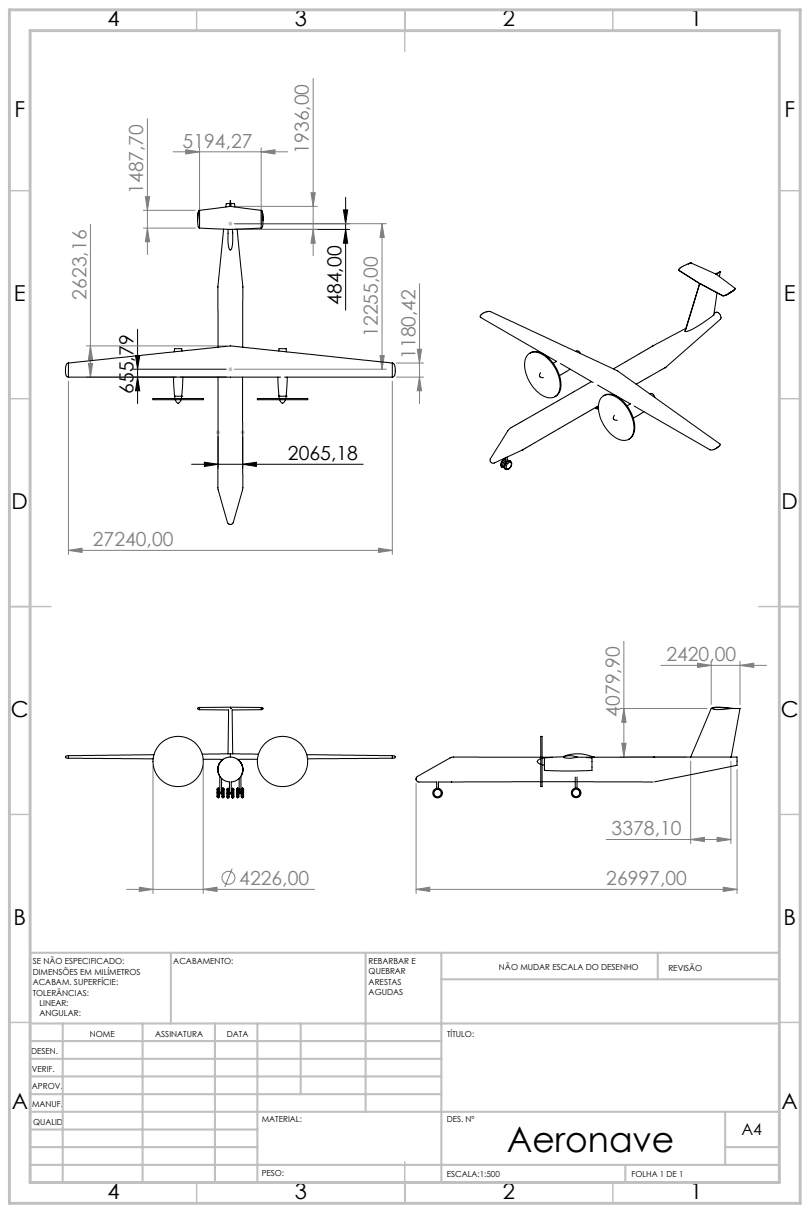
[picture p104: page 1]
ACABAMENTO:; REBARBAR E; NÃO MUDAR ESCALA DO DESENHO; REVISÃO; ESCALA:1:500; FOLHA 1 DE 1

SE NÃO ESPECIFICADO:
DIMENSÕES EM MILÍMETROS
ACABAM. SUPERFÍCIE:
TOLERÂNCIAS:
LINEAR:
ANGULAR:

NOME | ASSINATURA | DATA | | | | TÍTULO:

DESEN.
VERIF.
APROV.
MANUF.
QUALID | | | | MATERIAL: | DES. Nº Aeronave | A4
