mthsladeira/projetos1/autogenerated/graficos_comparativos/alcance.pdf

## Comparac¸ao do Alcance ˜

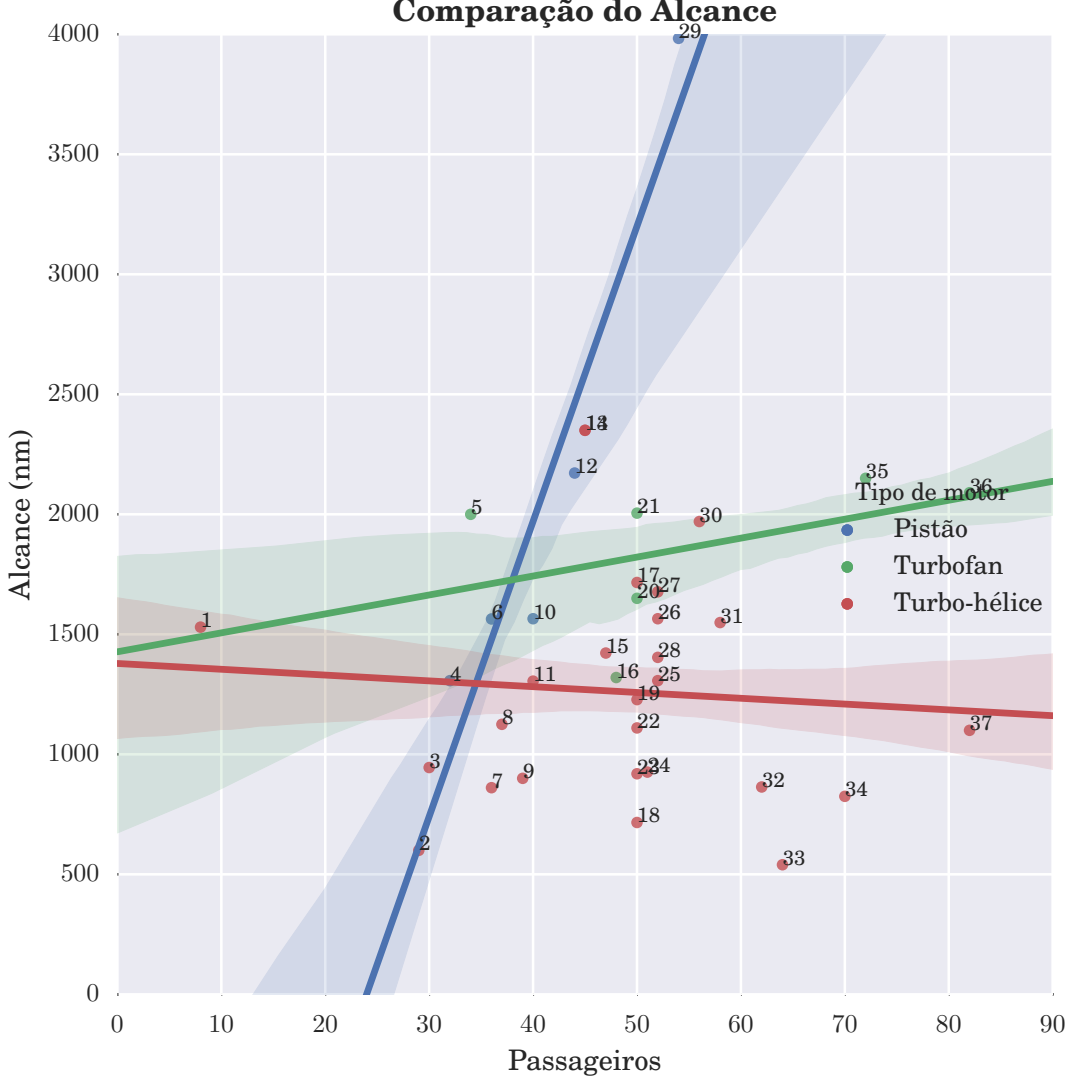
[picture p105: page 1]
Passageiros; Alcance (nm)

5 | 143 12 | 21 30 | | 35 Tipo de motor | 36

1 | | 6 | 10 | 17 27 20 26 31 | | Pistao˜ Turbofan Turbo-helice ´
