mthsladeira/projetos1/autogenerated/graficos_comparativos/alongamento.pdf

## Comparac¸ao do Alongamento ˜

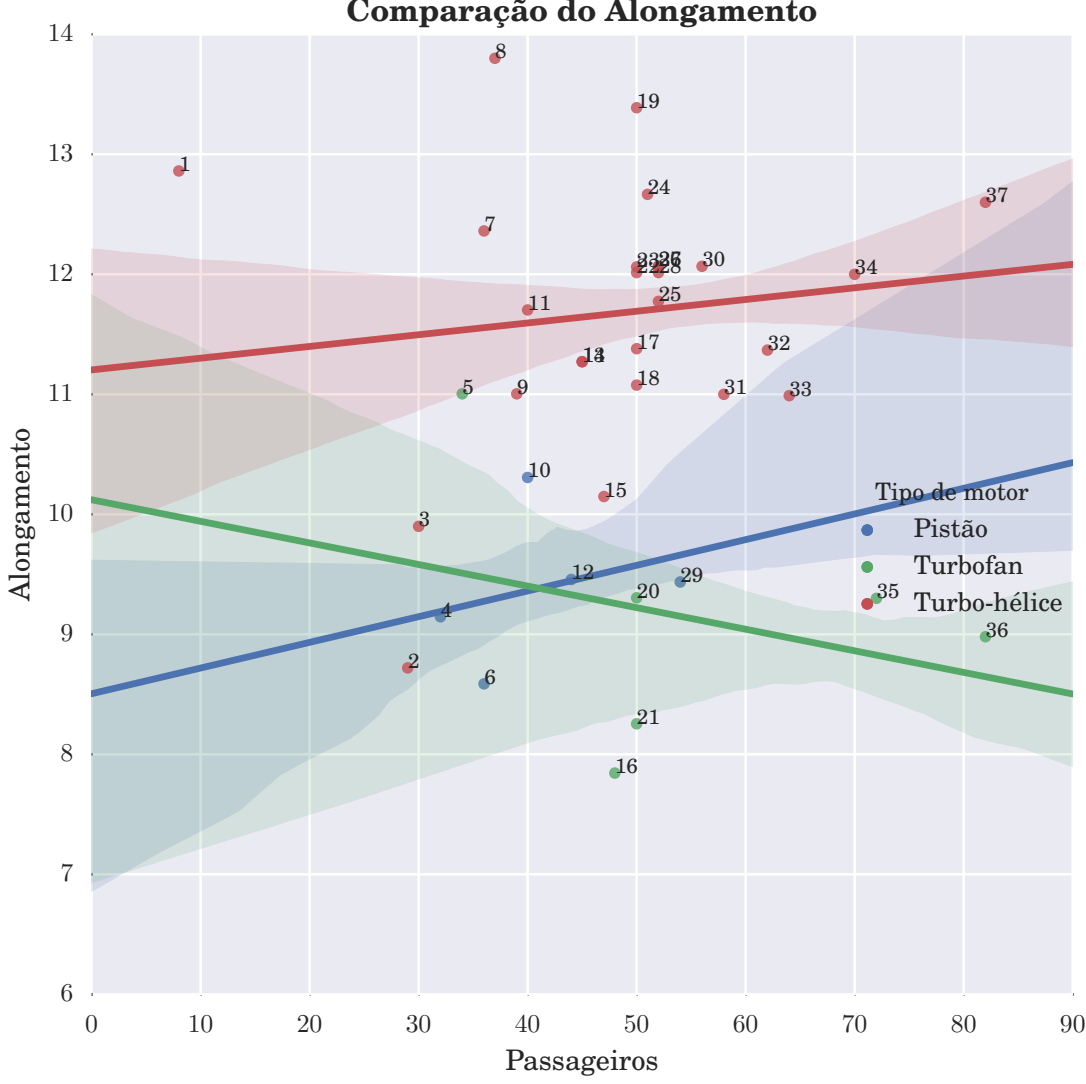
[picture p106: page 1]
Passageiros; Alongamento

10 15 | | | Tipo de motor

3 4 | 12 | 29 20 | | Pistao˜ Turbofan 35 Turbo-helice ´ | 36
