mthsladeira/projetos1/autogenerated/graficos_comparativos/altura.pdf

## Comparac¸ao da Altura ˜

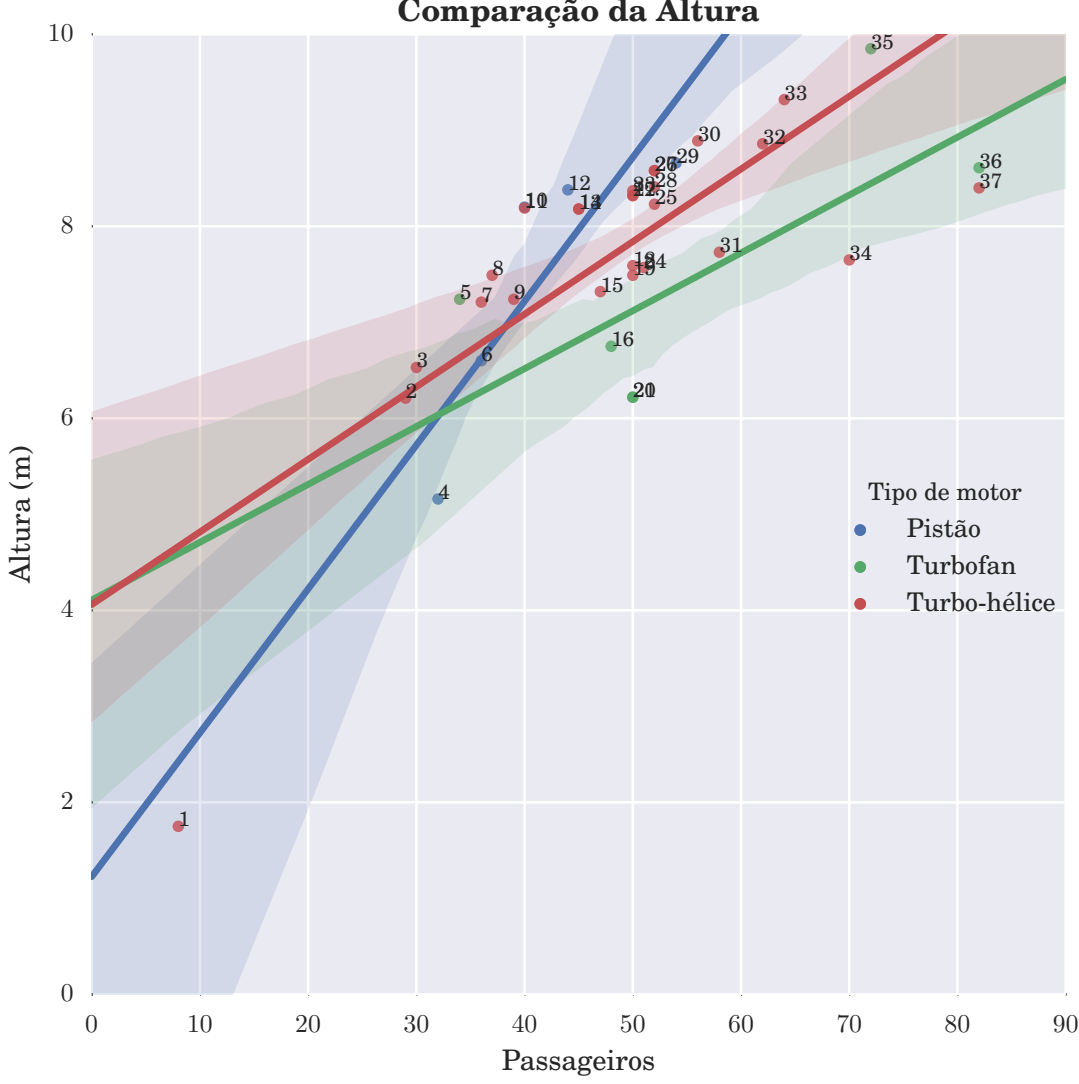
[picture p107: page 1]
Passageiros; Altura (m)

4 | | | | Tipo de motor Pistao˜ Turbofan Turbo-helice ´
