mthsladeira/projetos1/autogenerated/graficos_comparativos/area.pdf

## Comparac¸ao da ˜ Area Alar ´

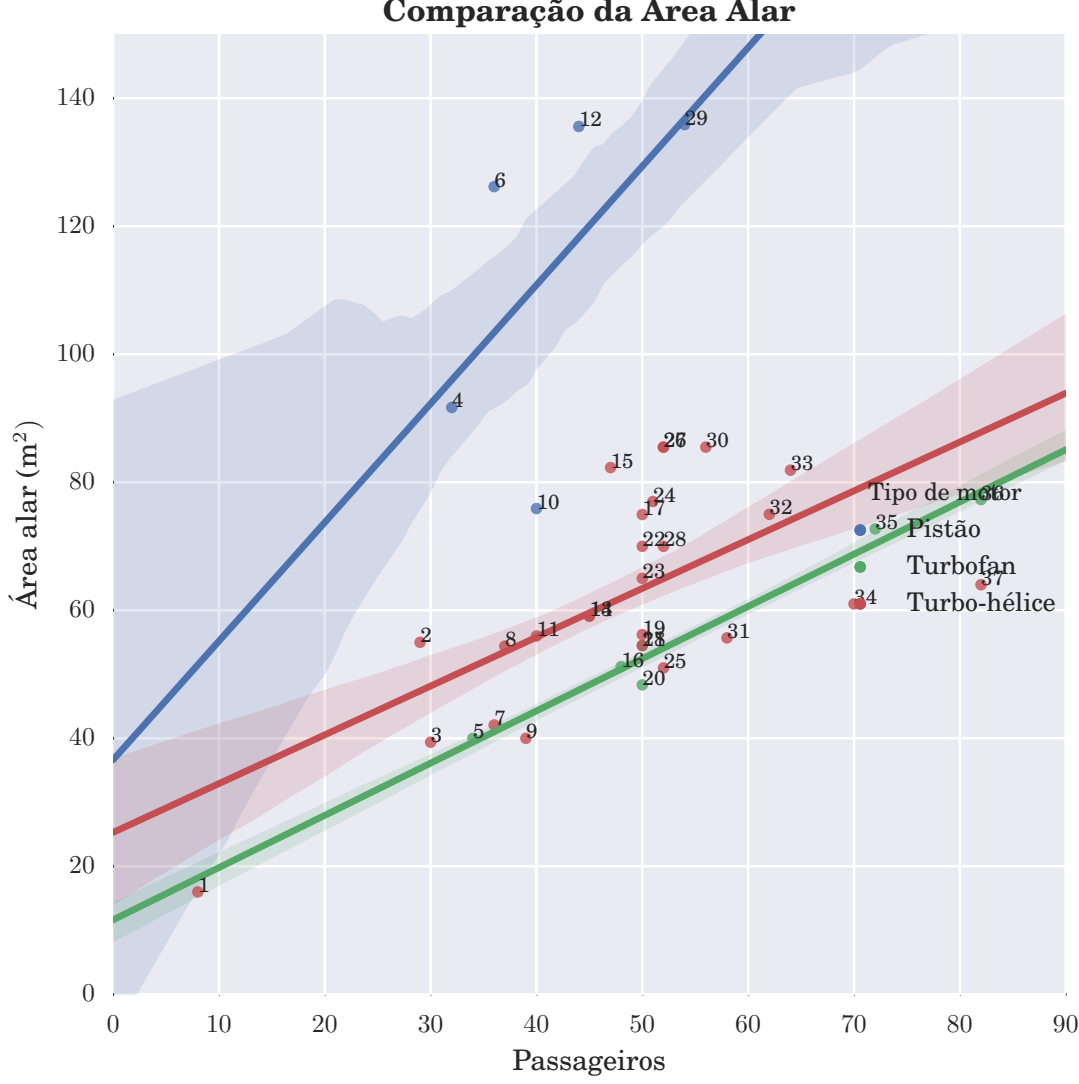
[picture p108: page 1]
Passageiros; Area alar (m2

10 143 | 24 17 22 28 | 32 | Tipo de motor 35 Pistao˜ Turbofan 34 Turbo-helice ´ | 36 37 23
