mthsladeira/projetos1/autogenerated/graficos_comparativos/comprimento.pdf

## Comparac¸ao do Comprimento ˜

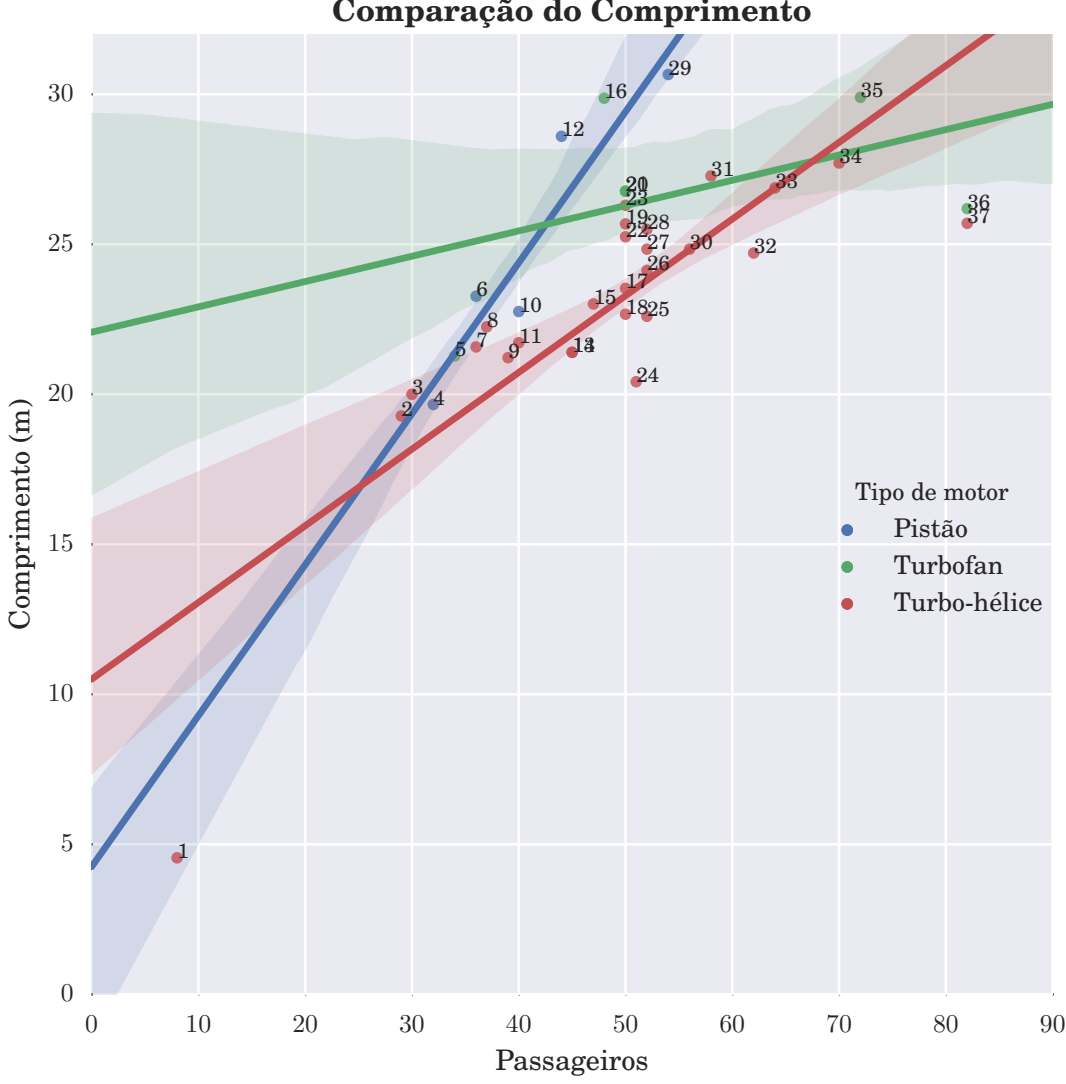
[picture p109: page 1]
Passageiros; Comprimento (m)

2 | | | | | Tipo de motor Pistao˜

Turbofan Turbo-helice ´
