mthsladeira/projetos1/autogenerated/graficos_comparativos/envergadura.pdf

## Comparac¸ao da Envergadura ˜

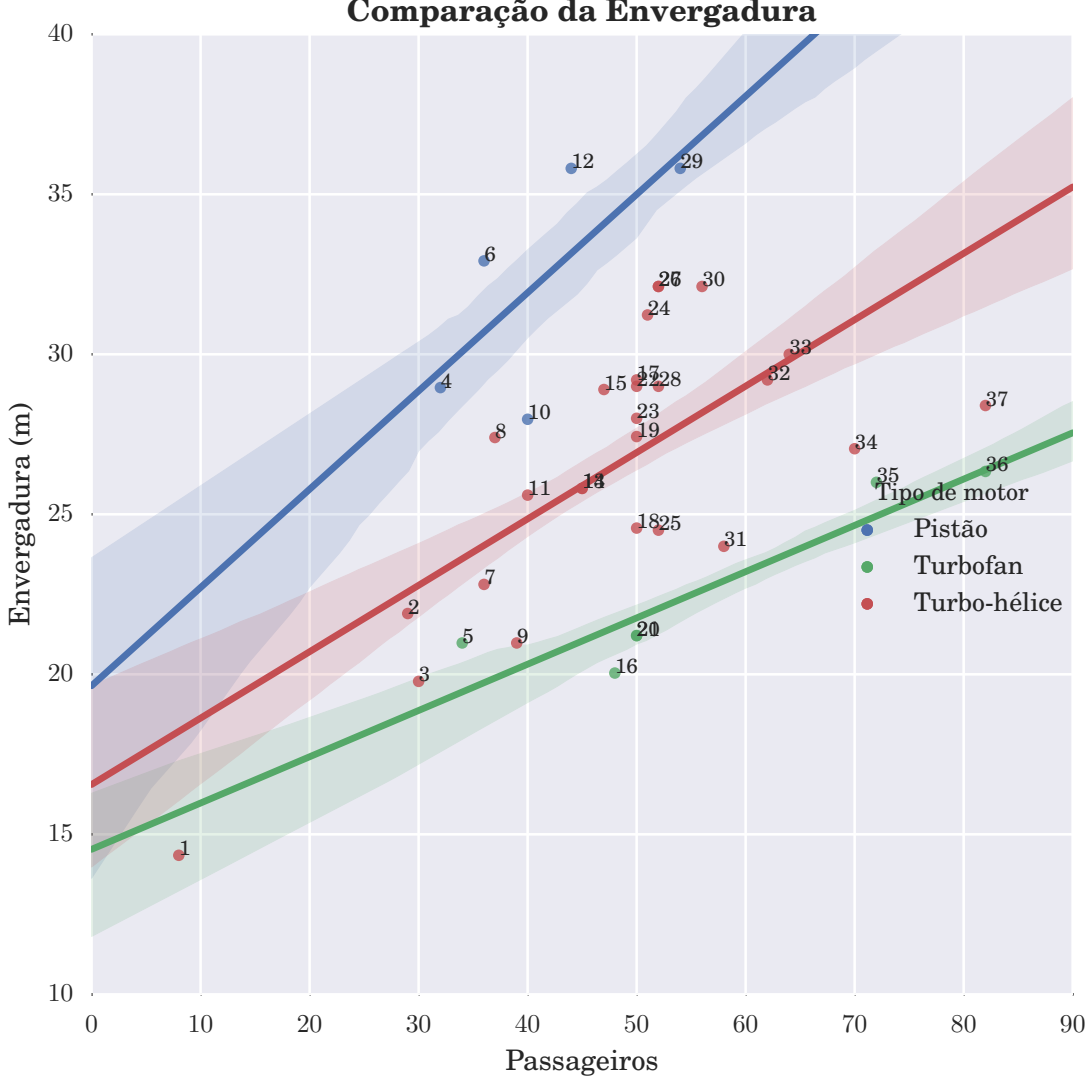
[picture p110: page 1]
Passageiros; Envergadura (m)

4 8 | 15 10 11 143 | 2217 28 19 | 32 | 34 35 Tipo de motor | 37 23 36

2 | 7 5 9 3 | 16 | 18 25 31 201 | | Pistao˜ Turbofan Turbo-helice ´
