mthsladeira/projetos1/autogenerated/graficos_comparativos/mtow.pdf

## Comparac¸ao do MTOW ˜

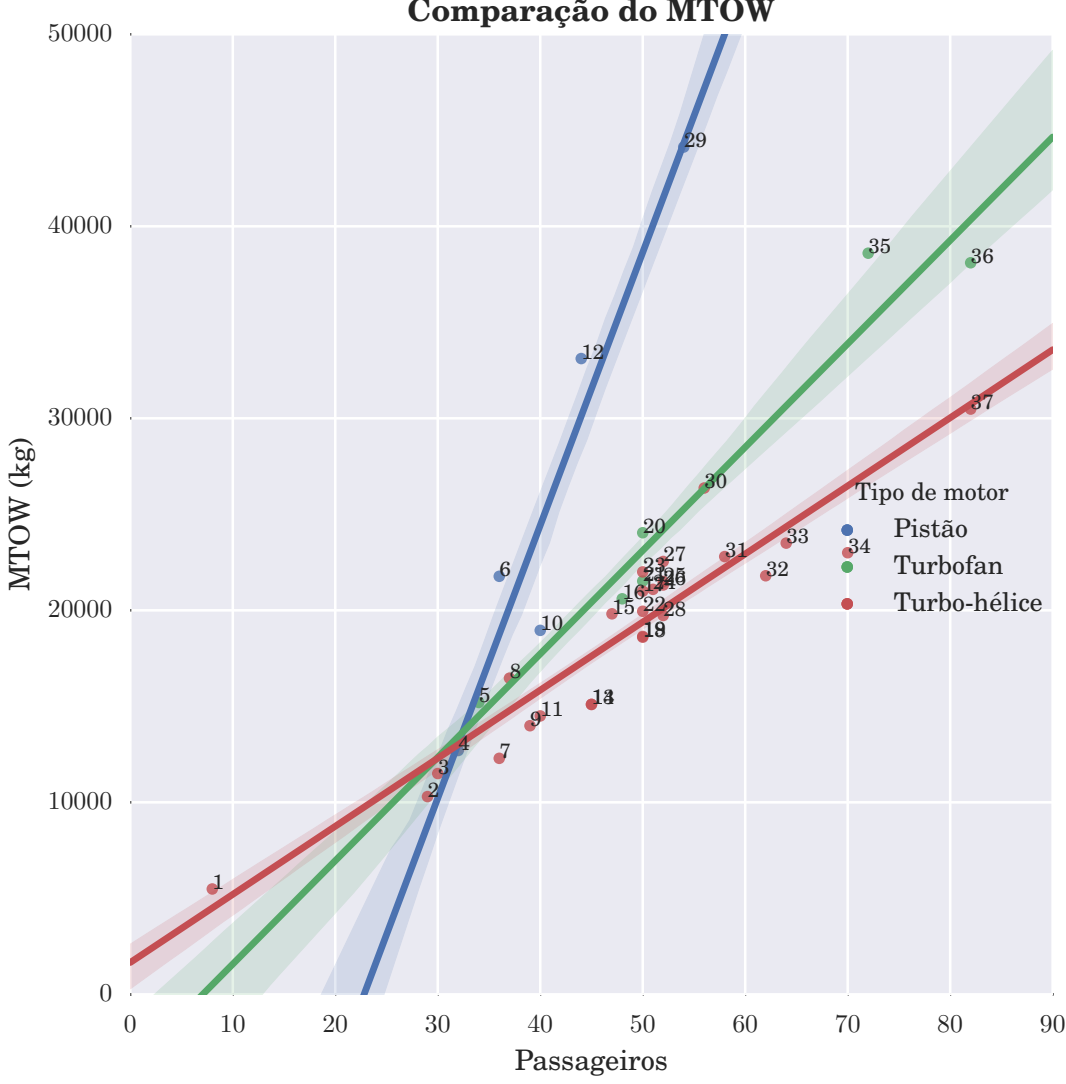
[picture p111: page 1]
Passageiros; MTOW (kg)

6 | 16 | 30 20 31 23 21 1725 24 26 22 | 33 32 27 | Tipo de motor Pistao˜ 34 Turbofan Turbo-helice ´
