mthsladeira/projetos1/autogenerated/graficos_comparativos/pesovazio.pdf

## Comparac¸ao do Peso Vazio ˜

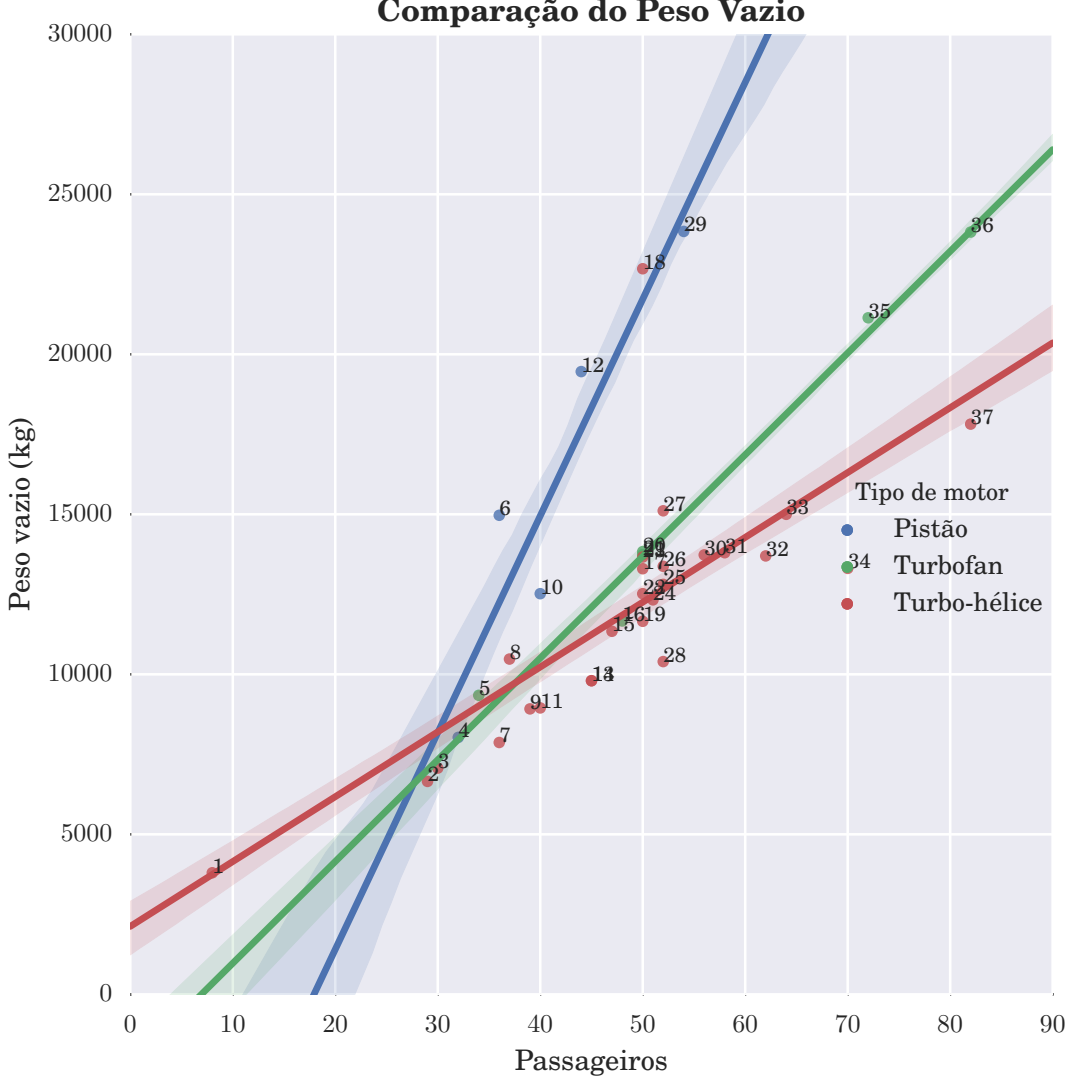
[picture p112: page 1]
Passageiros

6 | 12 | 27 | 33 | Tipo de motor | 37

Peso vazio (kg)

8 | 10 16 15 143 | 2021 23 30 31 26 17 25 22 24 19 28 | 32 | Pistao˜ 34 Turbofan Turbo-helice ´
