mthsladeira/projetos1/autogenerated/graficos_comparativos/teto.pdf

## Comparac¸ao do Teto de Servic¸o ˜

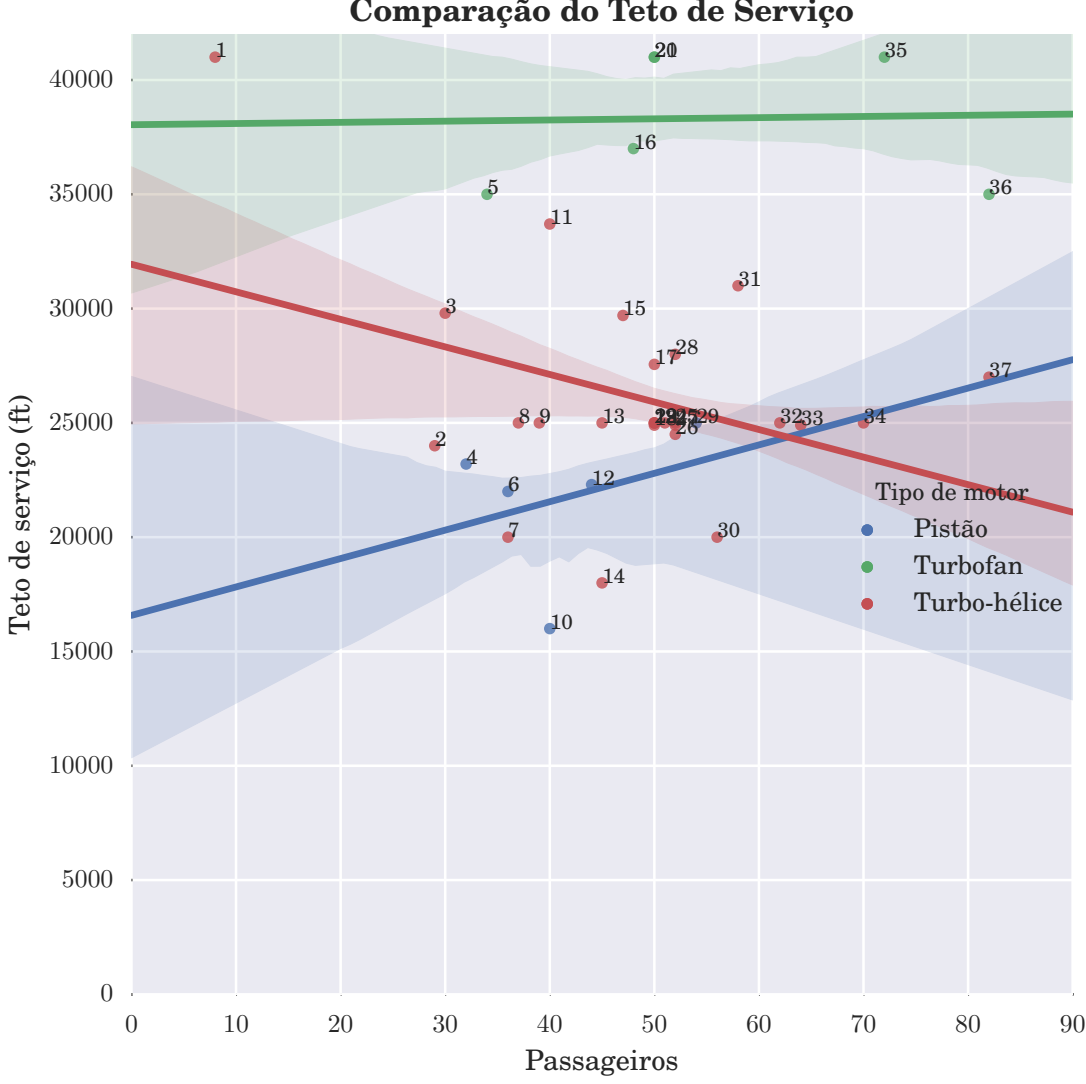
[picture p113: page 1]
Passageiros

Teto de servic¸o (ft)

2 | 4 6 7 | 12 | 30 | | Tipo de motor Pistao˜

14 10 | | | Turbofan Turbo-helice ´
