mthsladeira/projetos1/autogenerated/graficos_comparativos/vcruzeiro.pdf

## Comparac¸ao da Velocidade de Cruzeiro ˜

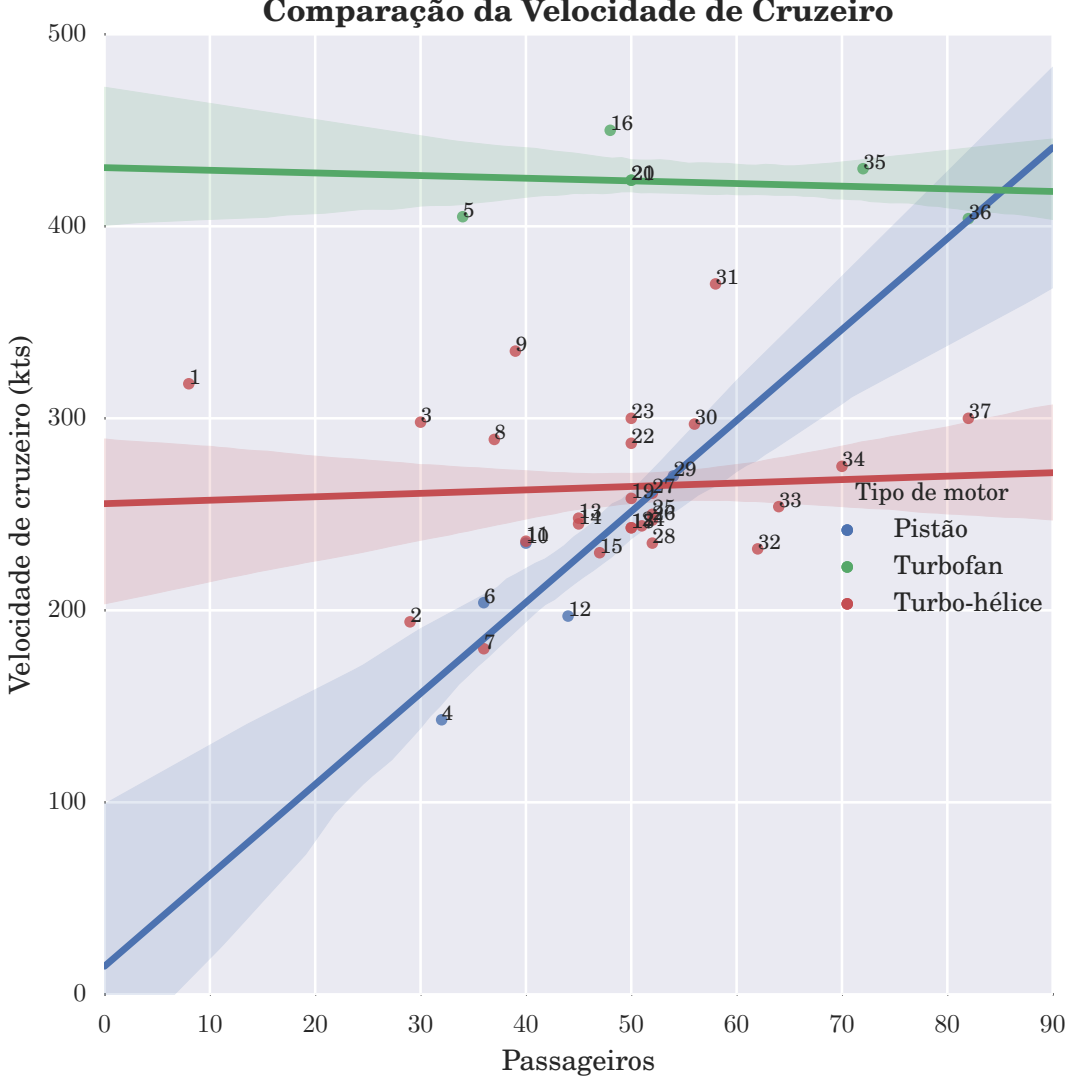
[picture p114: page 1]
Passageiros

Velocidade de cruzeiro (kts)

8 6 | 1413 11 10 15 | 22 29 27 19 1725 1824 26 28 | 33 32 | 34 Tipo de motor Pistao˜ Turbofan Turbo-helice ´
