mthsladeira/projetos1/autogenerated/graficos_comparativos/vmaxima.pdf

Comparac¸ao da Velocidade M ˜ | axima ´

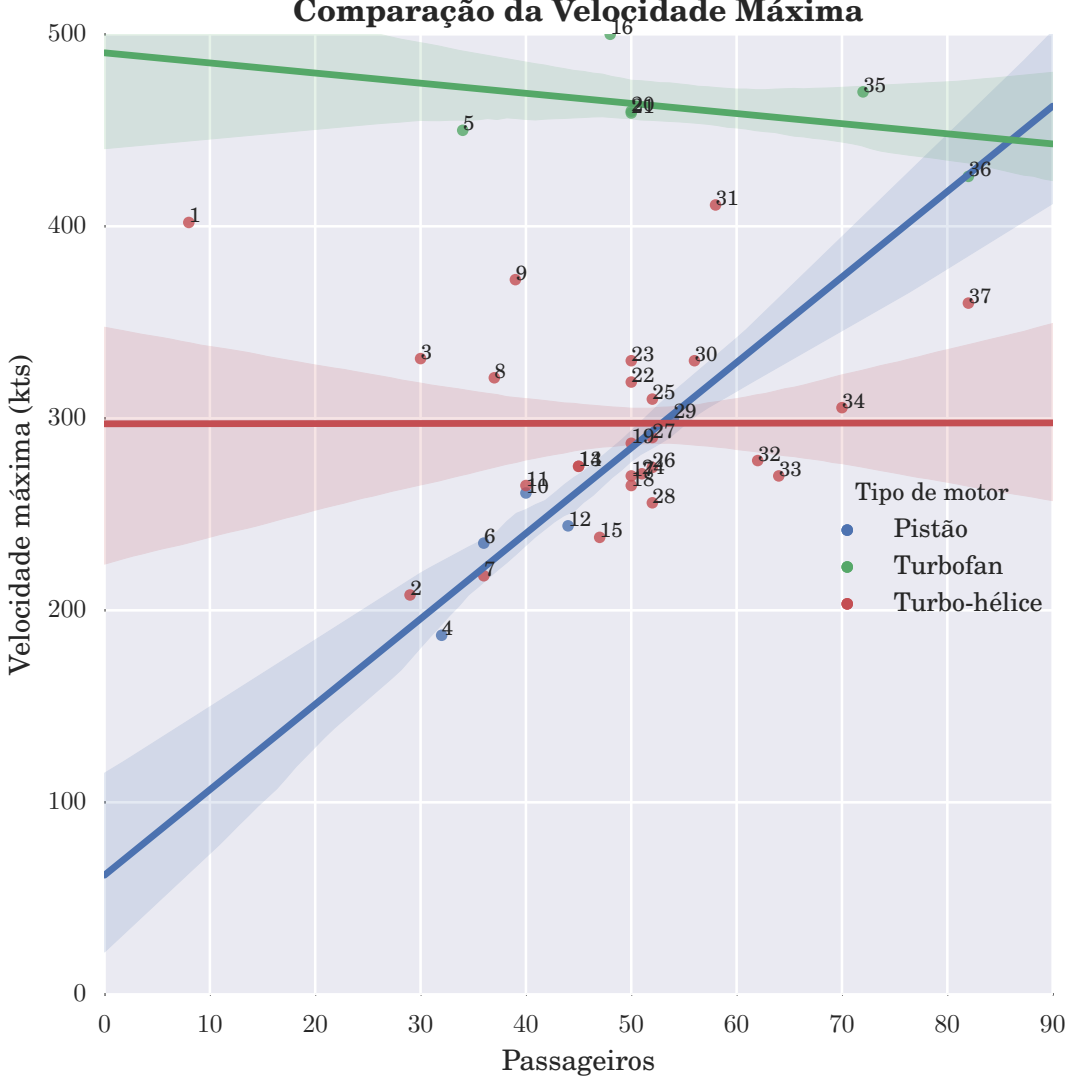
[picture p115: page 1]
Passageiros

Velocidade m´axima (kts)

2 | 6 7 | 143 11 10 12 15 | 27 19 26 17 1824 28 | 32 33 | Tipo de motor Pistao˜ Turbofan Turbo-helice ´
