mthsladeira/projetos1/Desenho/Aeronave.pdf

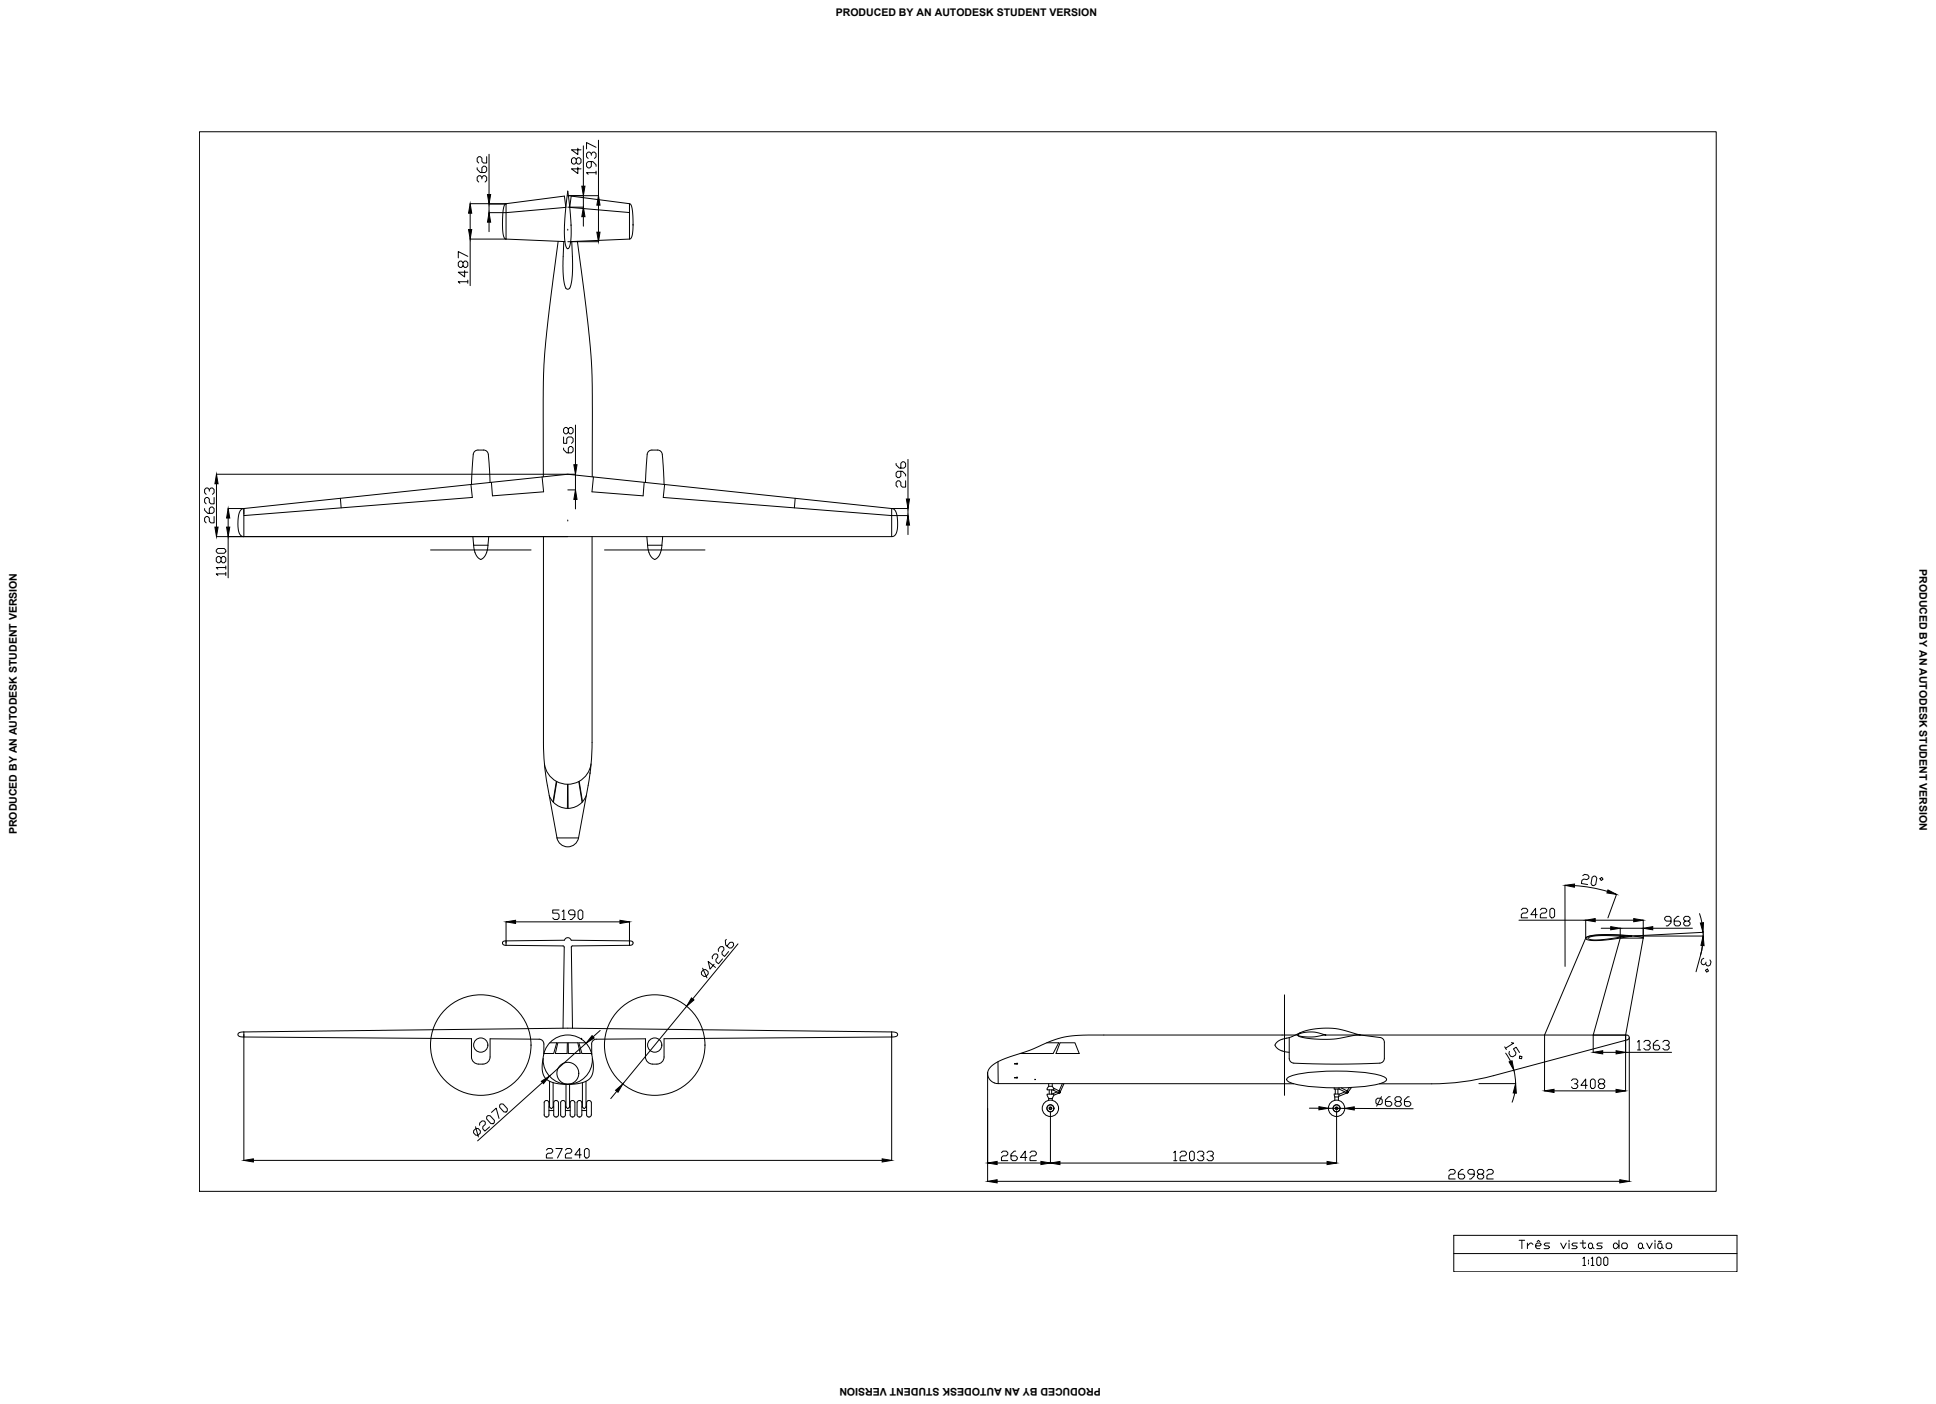
[picture p116: page 1]

PRODUCED BY AN AUTODESK STUDENT VERSION
