mthsladeira/projetos1/Desenho/Asa.pdf

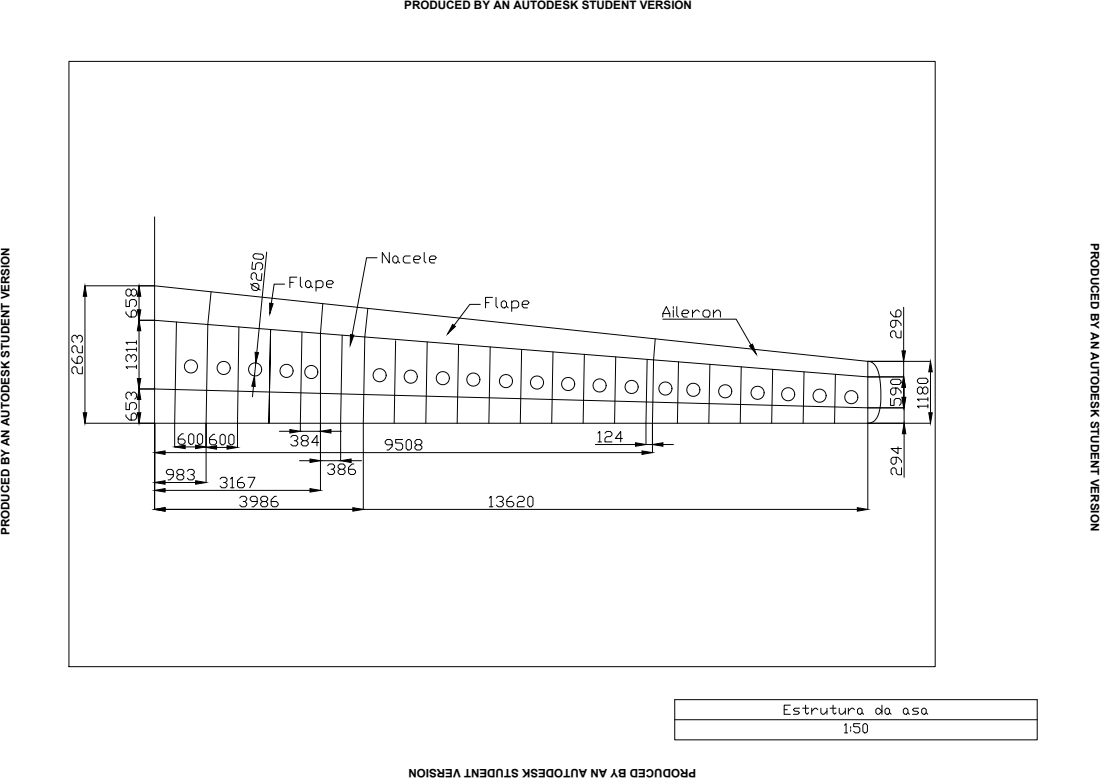
[picture p117: page 1]

PRODUCED BY AN AUTODESK STUDENT VERSION
