mthsladeira/projetos1/Desenho/EH.pdf

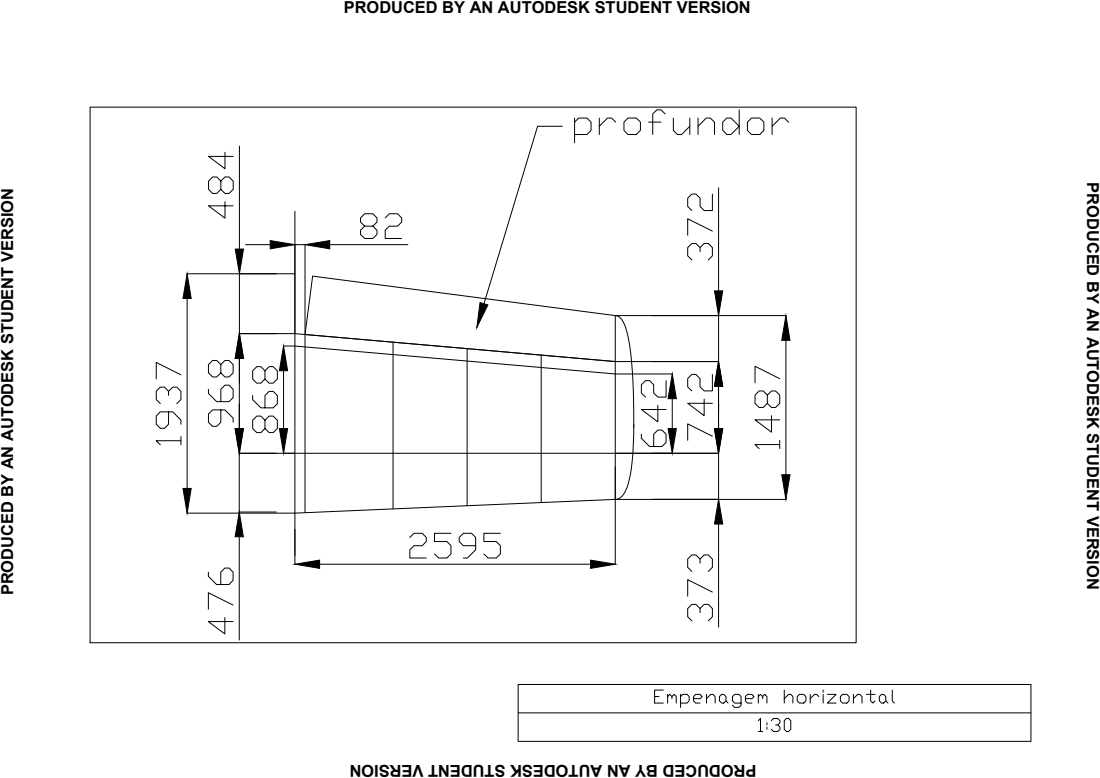
[picture p118: page 1]

PRODUCED BY AN AUTODESK STUDENT VERSION
