mthsladeira/projetos1/Desenho/fuselagem_estrutura.pdf

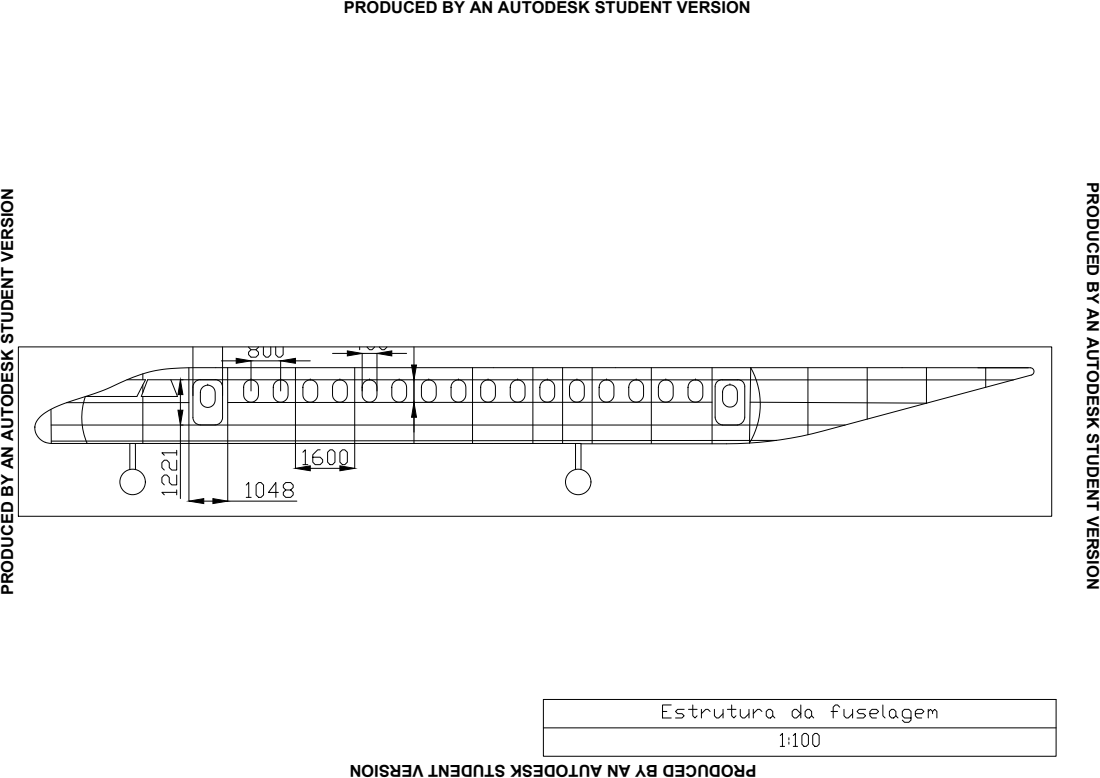
[picture p119: page 1]

PRODUCED BY AN AUTODESK STUDENT VERSION
