mthsladeira/projetos1/Desenho/fuselagem_estrutura_transversal.pdf

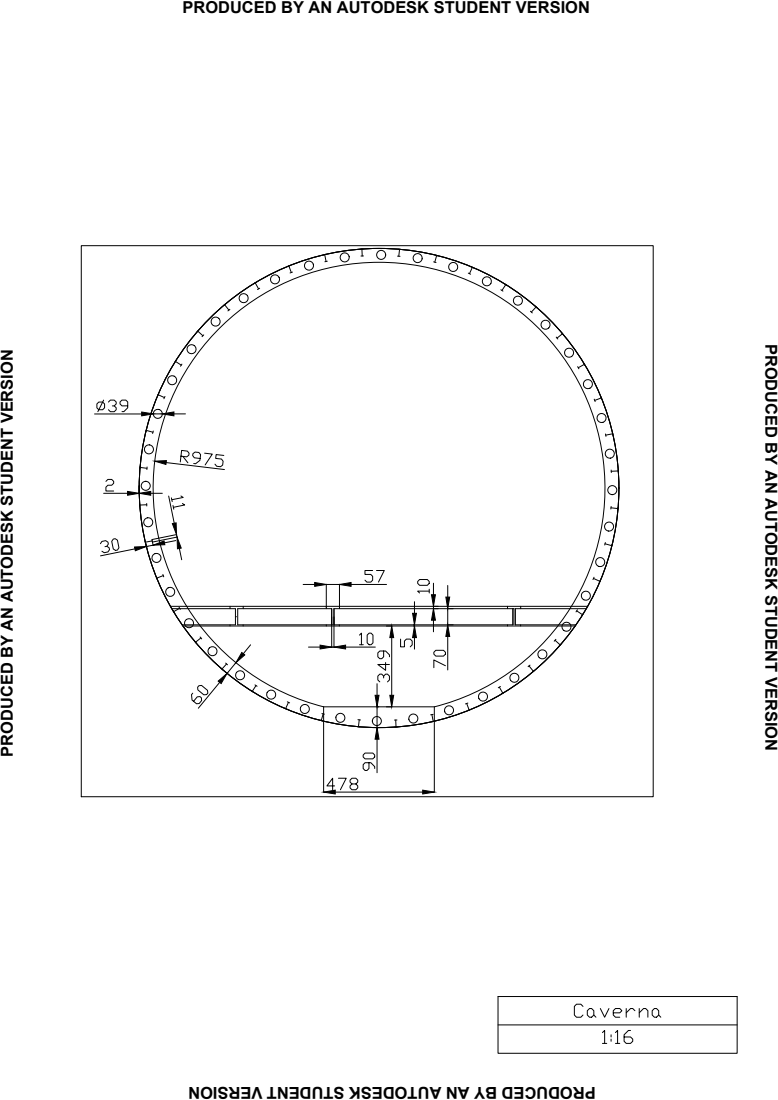
[picture p120: page 1]

PRODUCED BY AN AUTODESK STUDENT VERSION
