mthsladeira/projetos1/Desenho/mecanismo_atuacao2.pdf

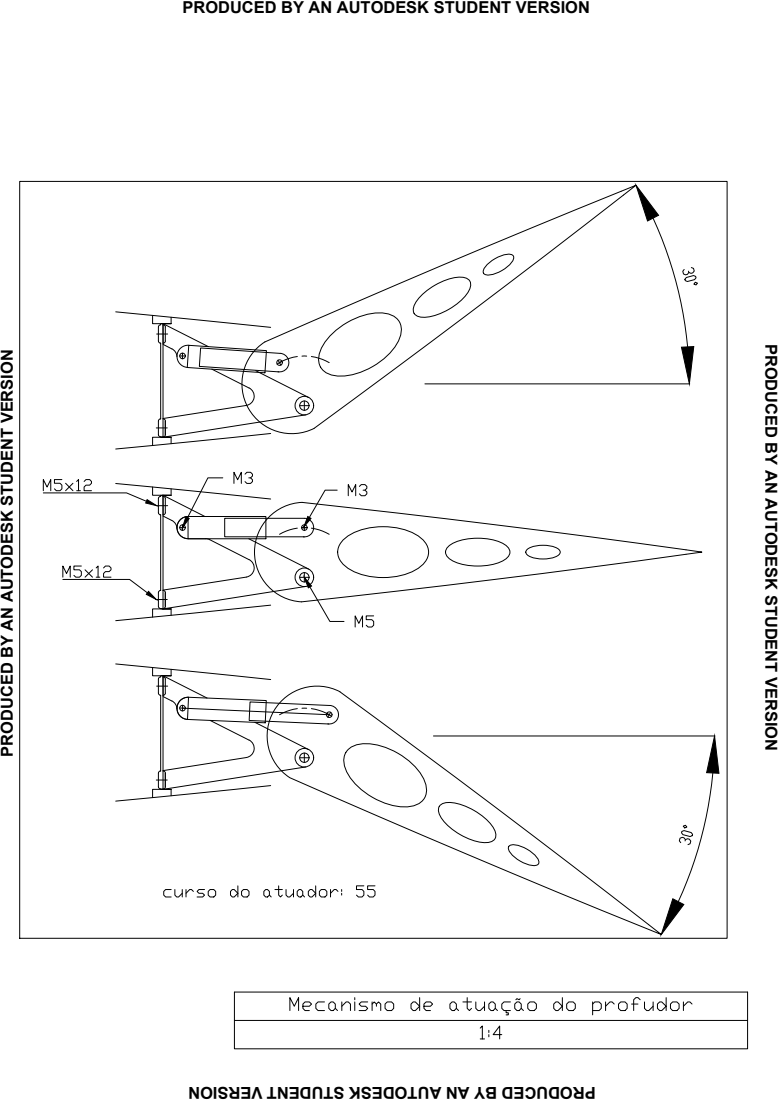
[picture p121: page 1]

PRODUCED BY AN AUTODESK STUDENT VERSION
