mthsladeira/projetos1/Desenho/nervuras.pdf

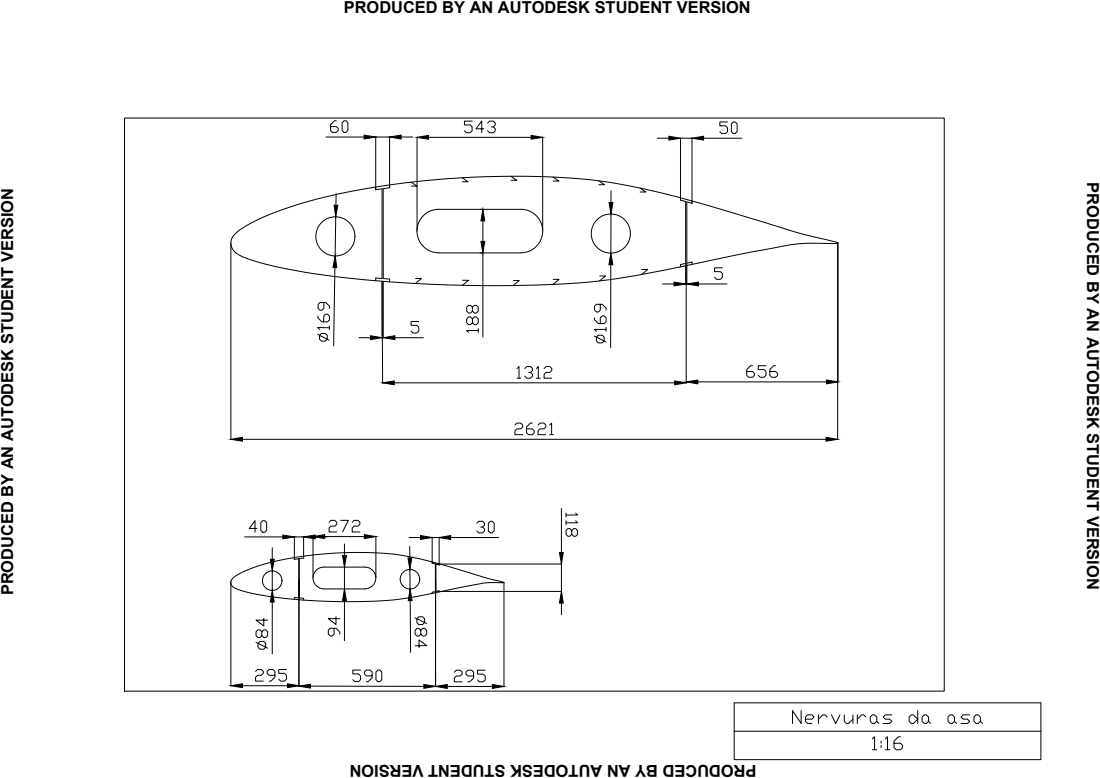
[picture p122: page 1]

PRODUCED BY AN AUTODESK STUDENT VERSION
