mthsladeira/projetos1/Desenho/nervuras_EH.pdf

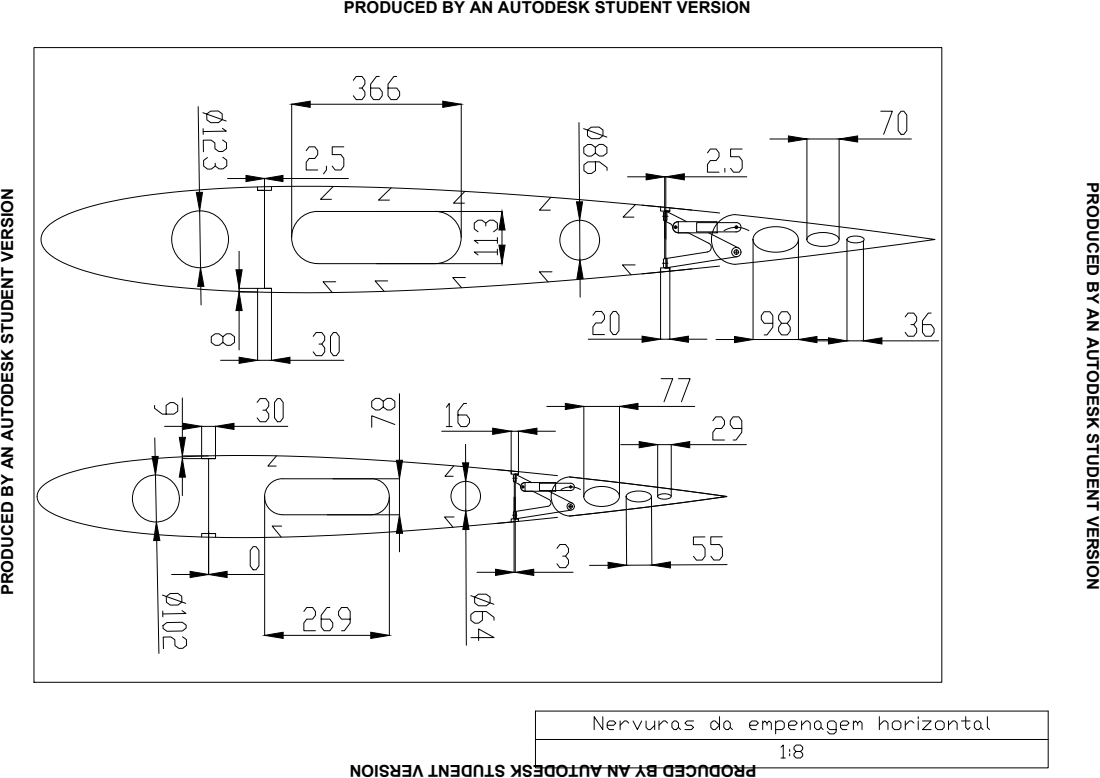
[picture p123: page 1]

PRODUCED BY AN AUTODESK STUDENT VERSION
