mthsladeira/projetos1/Desenho/posicao sistemas.pdf

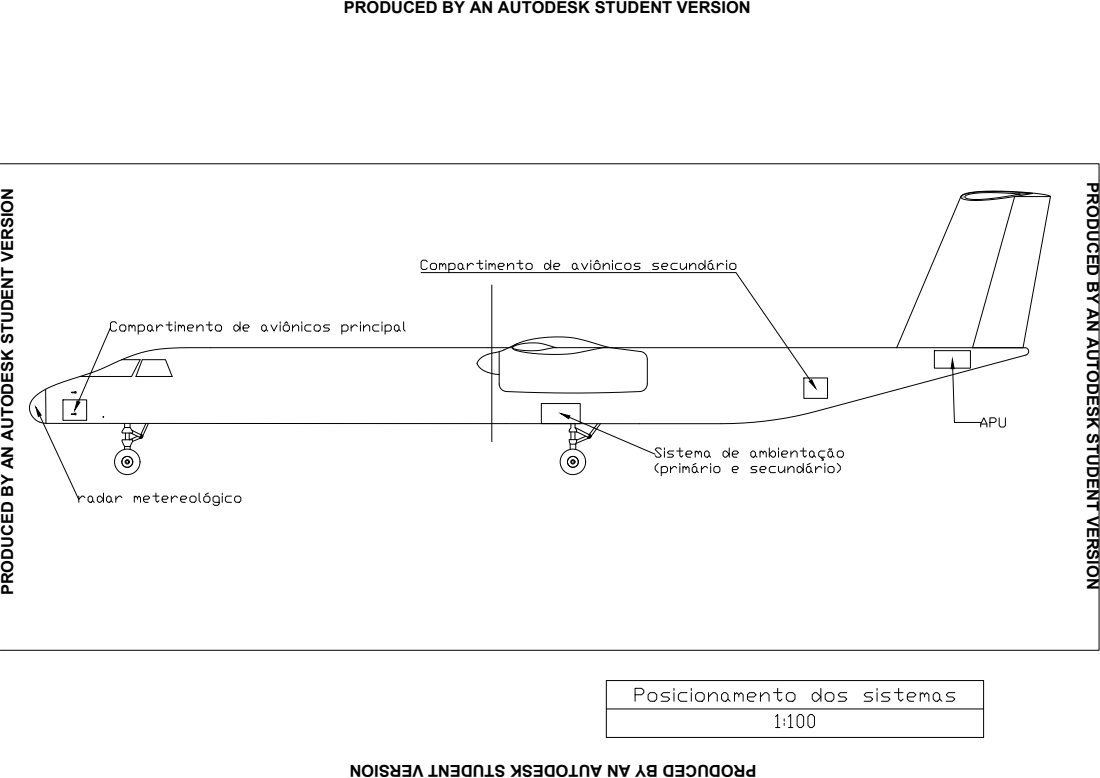
[picture p124: page 1]

PRODUCED BY AN AUTODESK STUDENT VERSION
