mthsladeira/projetos1/Desenho/Aeronave-Modelo.pdf

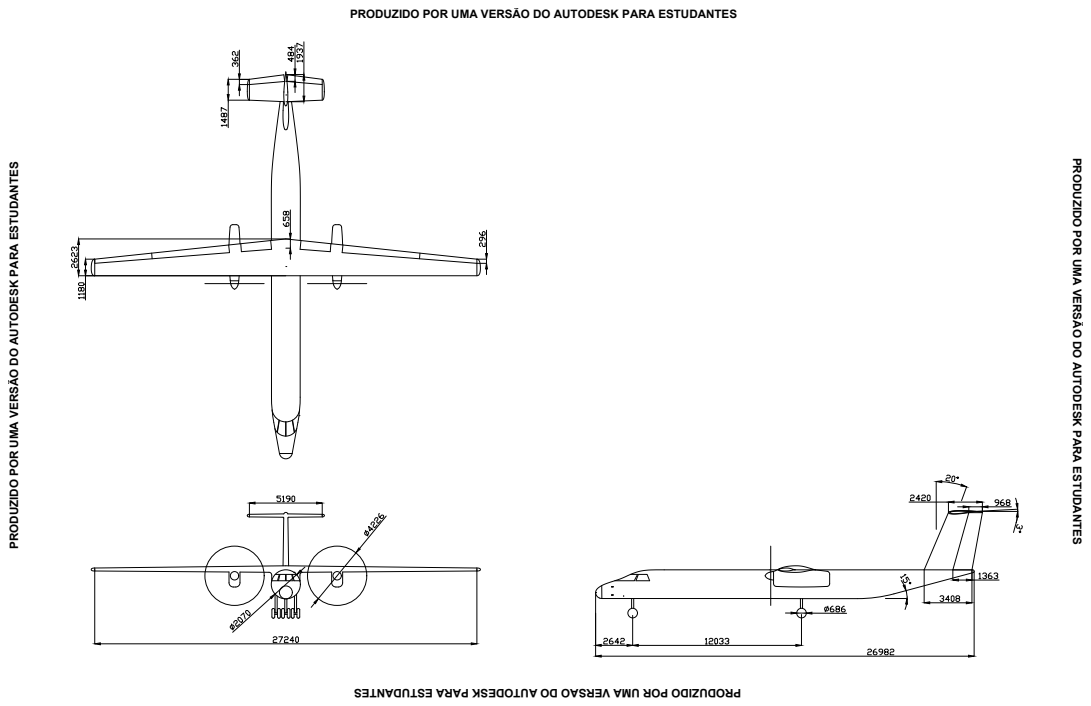
[picture p125: page 1]

PRODUZIDO POR UMA VERSÃO DO AUTODESK PARA ESTUDANTES
