mthsladeira/projetos1/Desenho/Asa-Modelo.pdf

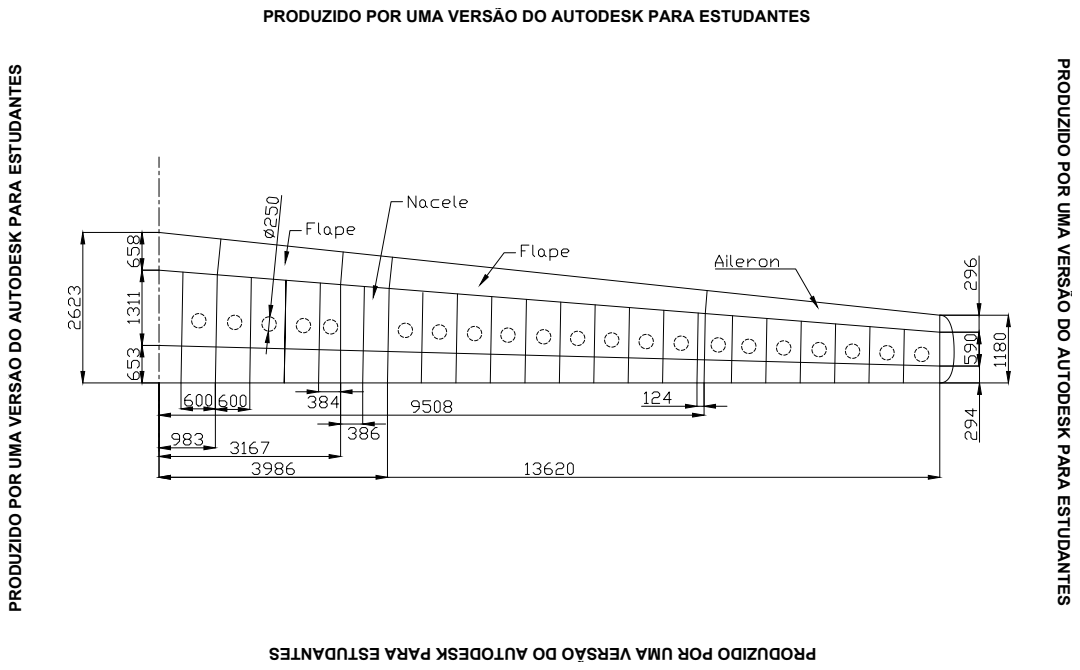
[picture p126: page 1]

PRODUZIDO POR UMA VERSÃO DO AUTODESK PARA ESTUDANTES
