mthsladeira/projetos1/Desenho/EH-Modelo.pdf

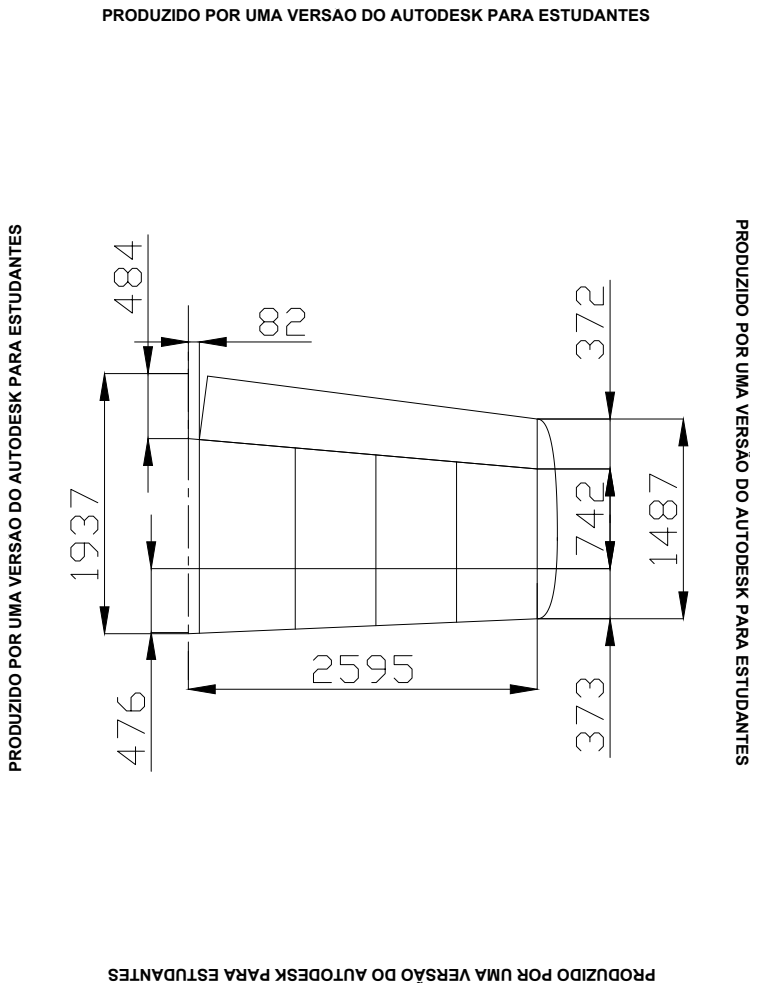
[picture p127: page 1]

PRODUZIDO POR UMA VERSÃO DO AUTODESK PARA ESTUDANTES
