mthsladeira/projetos1/Desenho/fuselagem_estrutura-Modelo.pdf

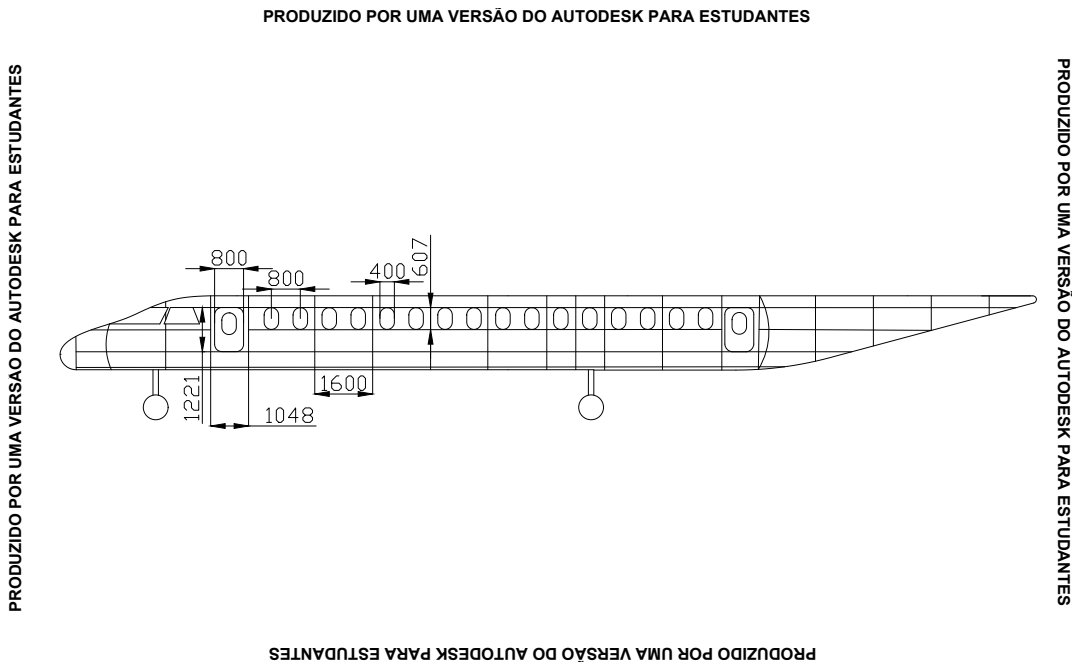
[picture p128: page 1]

PRODUZIDO POR UMA VERSÃO DO AUTODESK PARA ESTUDANTES
