mthsladeira/projetos1/Desenho/fuselagem_estrutura_transversal-Modelo.pdf

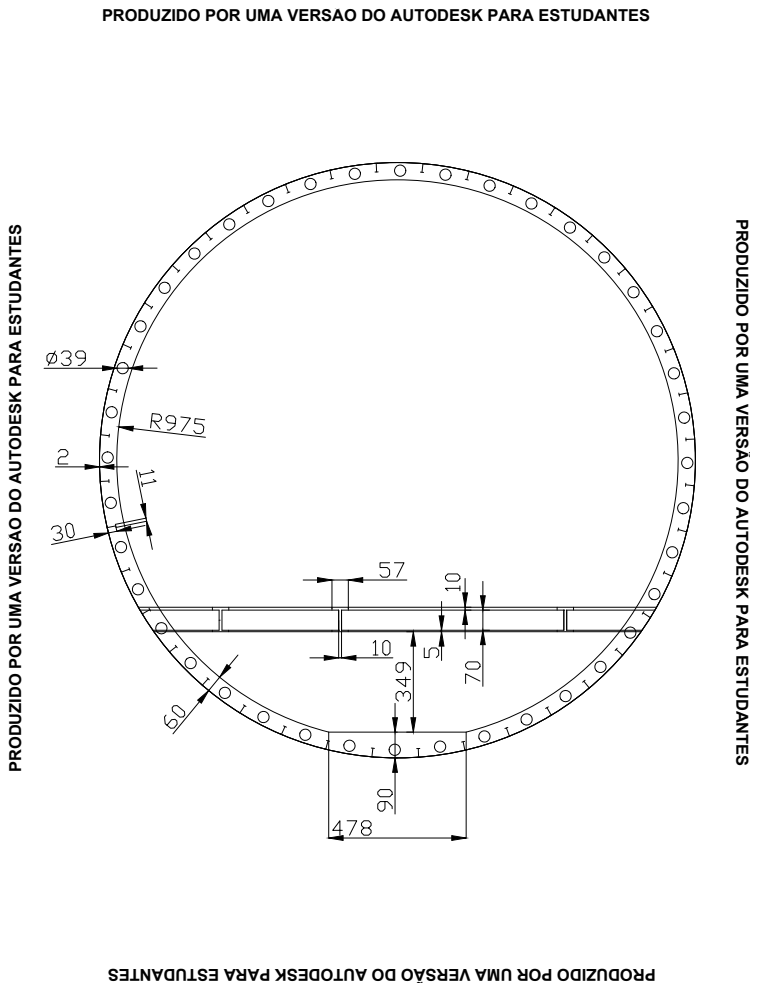
[picture p129: page 1]

PRODUZIDO POR UMA VERSÃO DO AUTODESK PARA ESTUDANTES
