mthsladeira/projetos1/Desenho/nervuras-Modelo.pdf

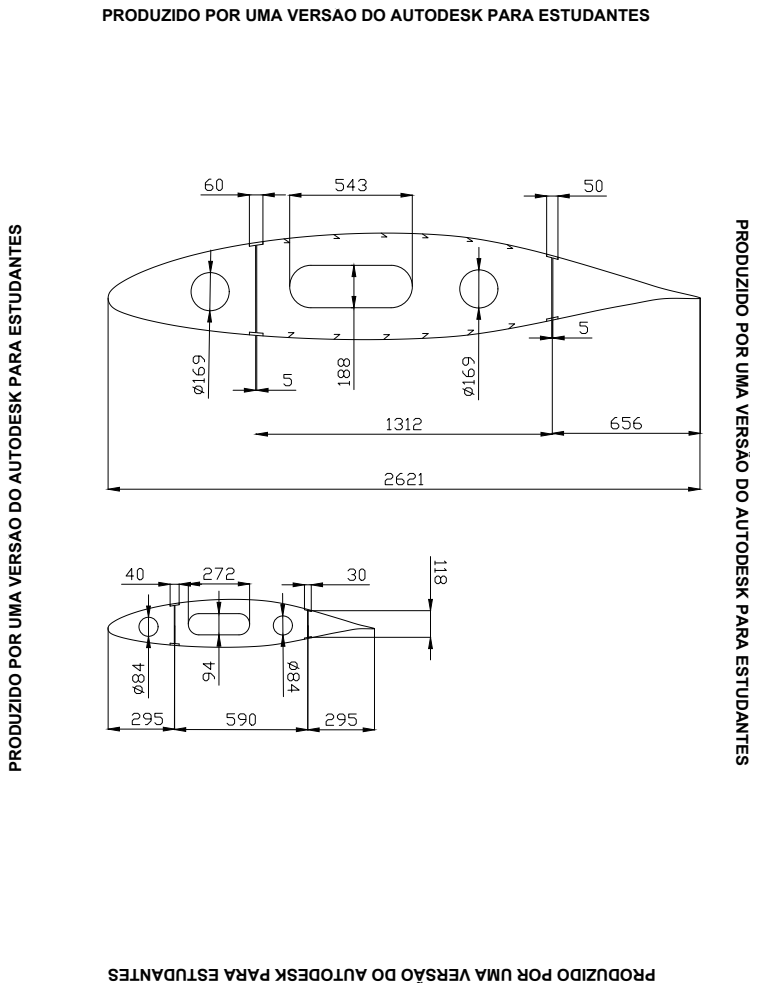
[picture p130: page 1]

PRODUZIDO POR UMA VERSÃO DO AUTODESK PARA ESTUDANTES
