mthsladeira/projetos1/Desenho/nervuras_EH-Modelo.pdf

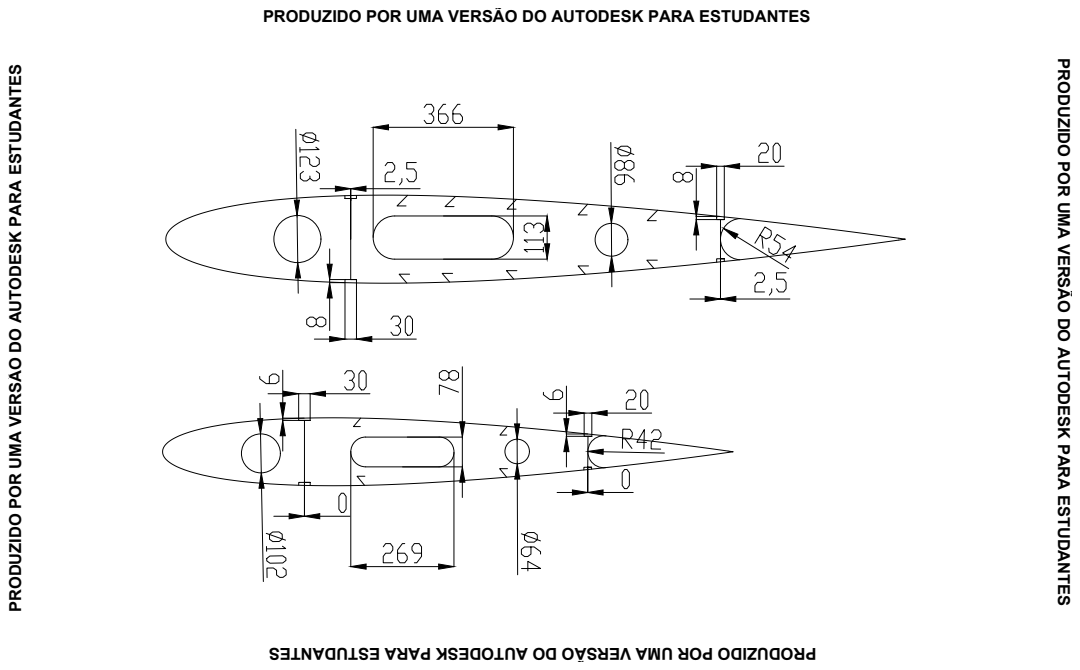
[picture p131: page 1]

PRODUZIDO POR UMA VERSÃO DO AUTODESK PARA ESTUDANTES
