mthsladeira/projetos1/images/ufmg_logo.pdf

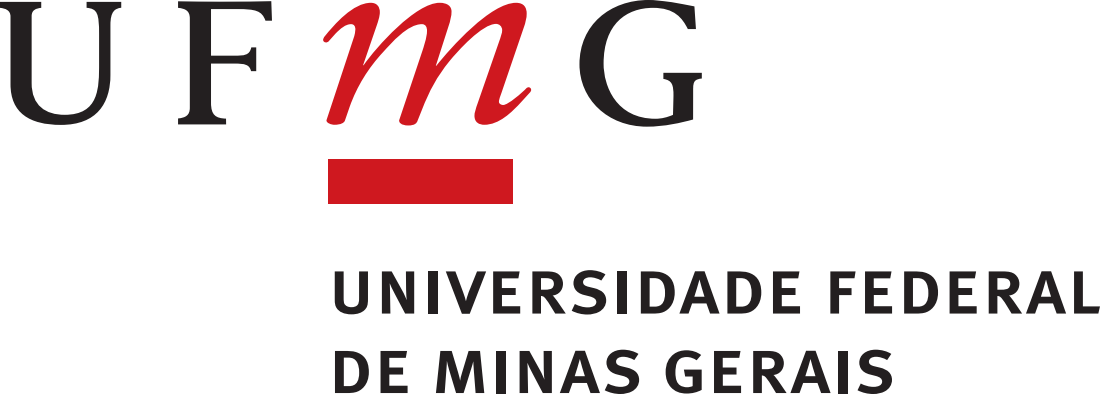
[picture p132: page 1]
