mthsladeira/projetos1/text/parte4/CanardinhoPistolay_3vistas.pdf

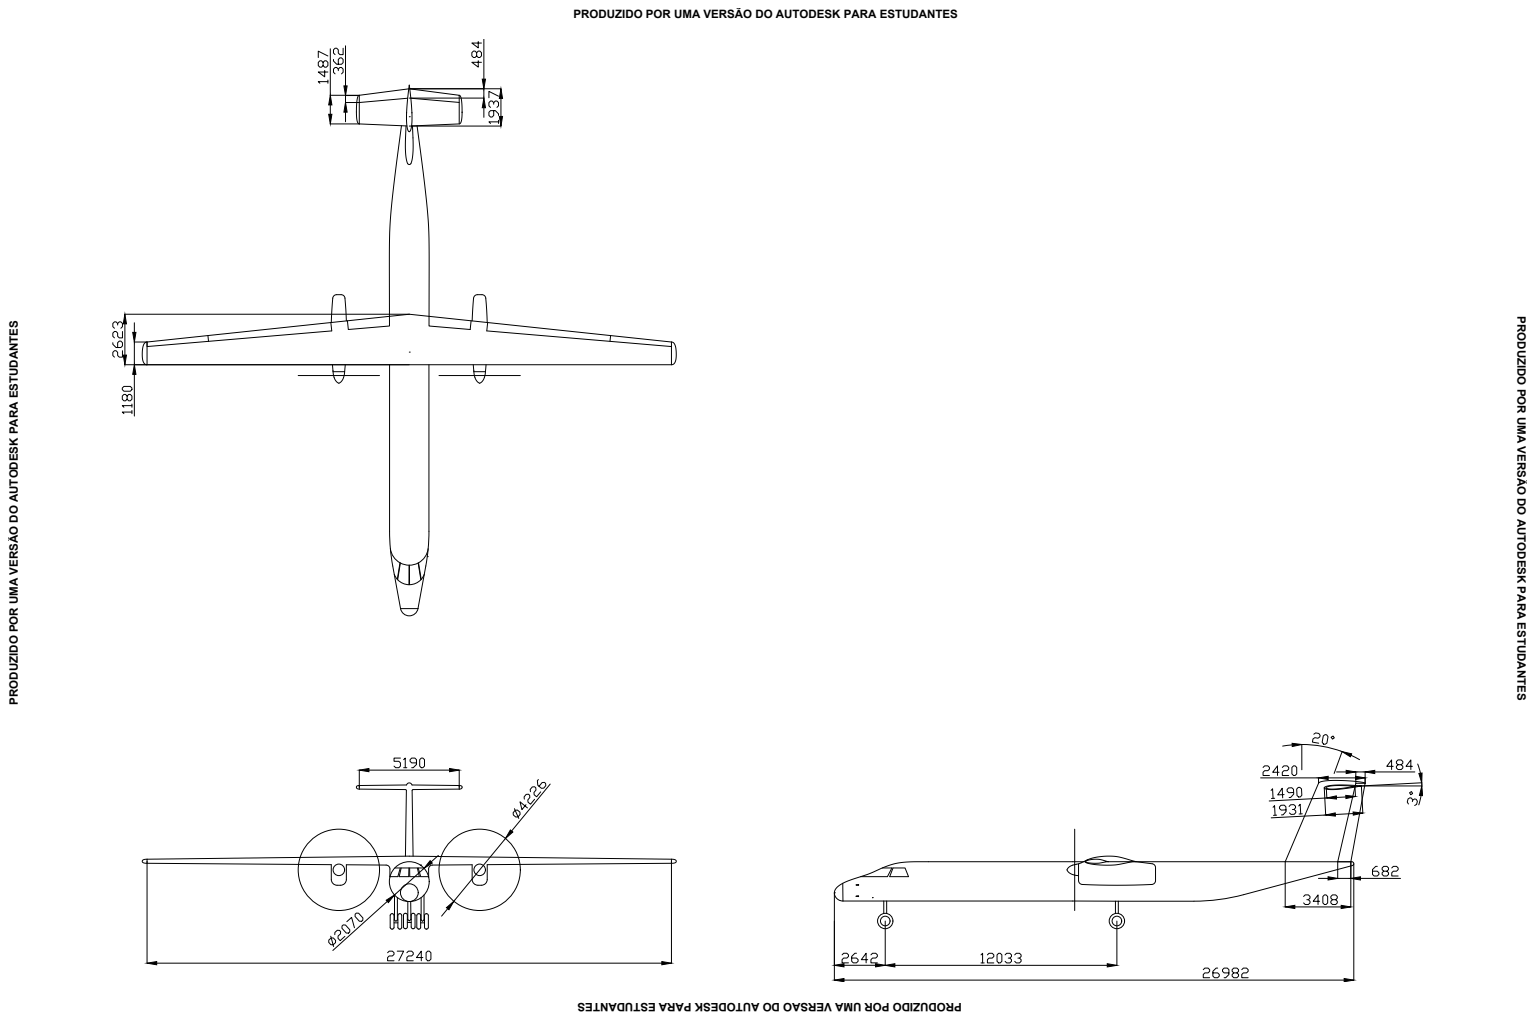
[picture p133: page 1]

PRODUZIDO POR UMA VERSÃO DO AUTODESK PARA ESTUDANTES
