mthsladeira/projetos1/images/parte3/tdp.pdf

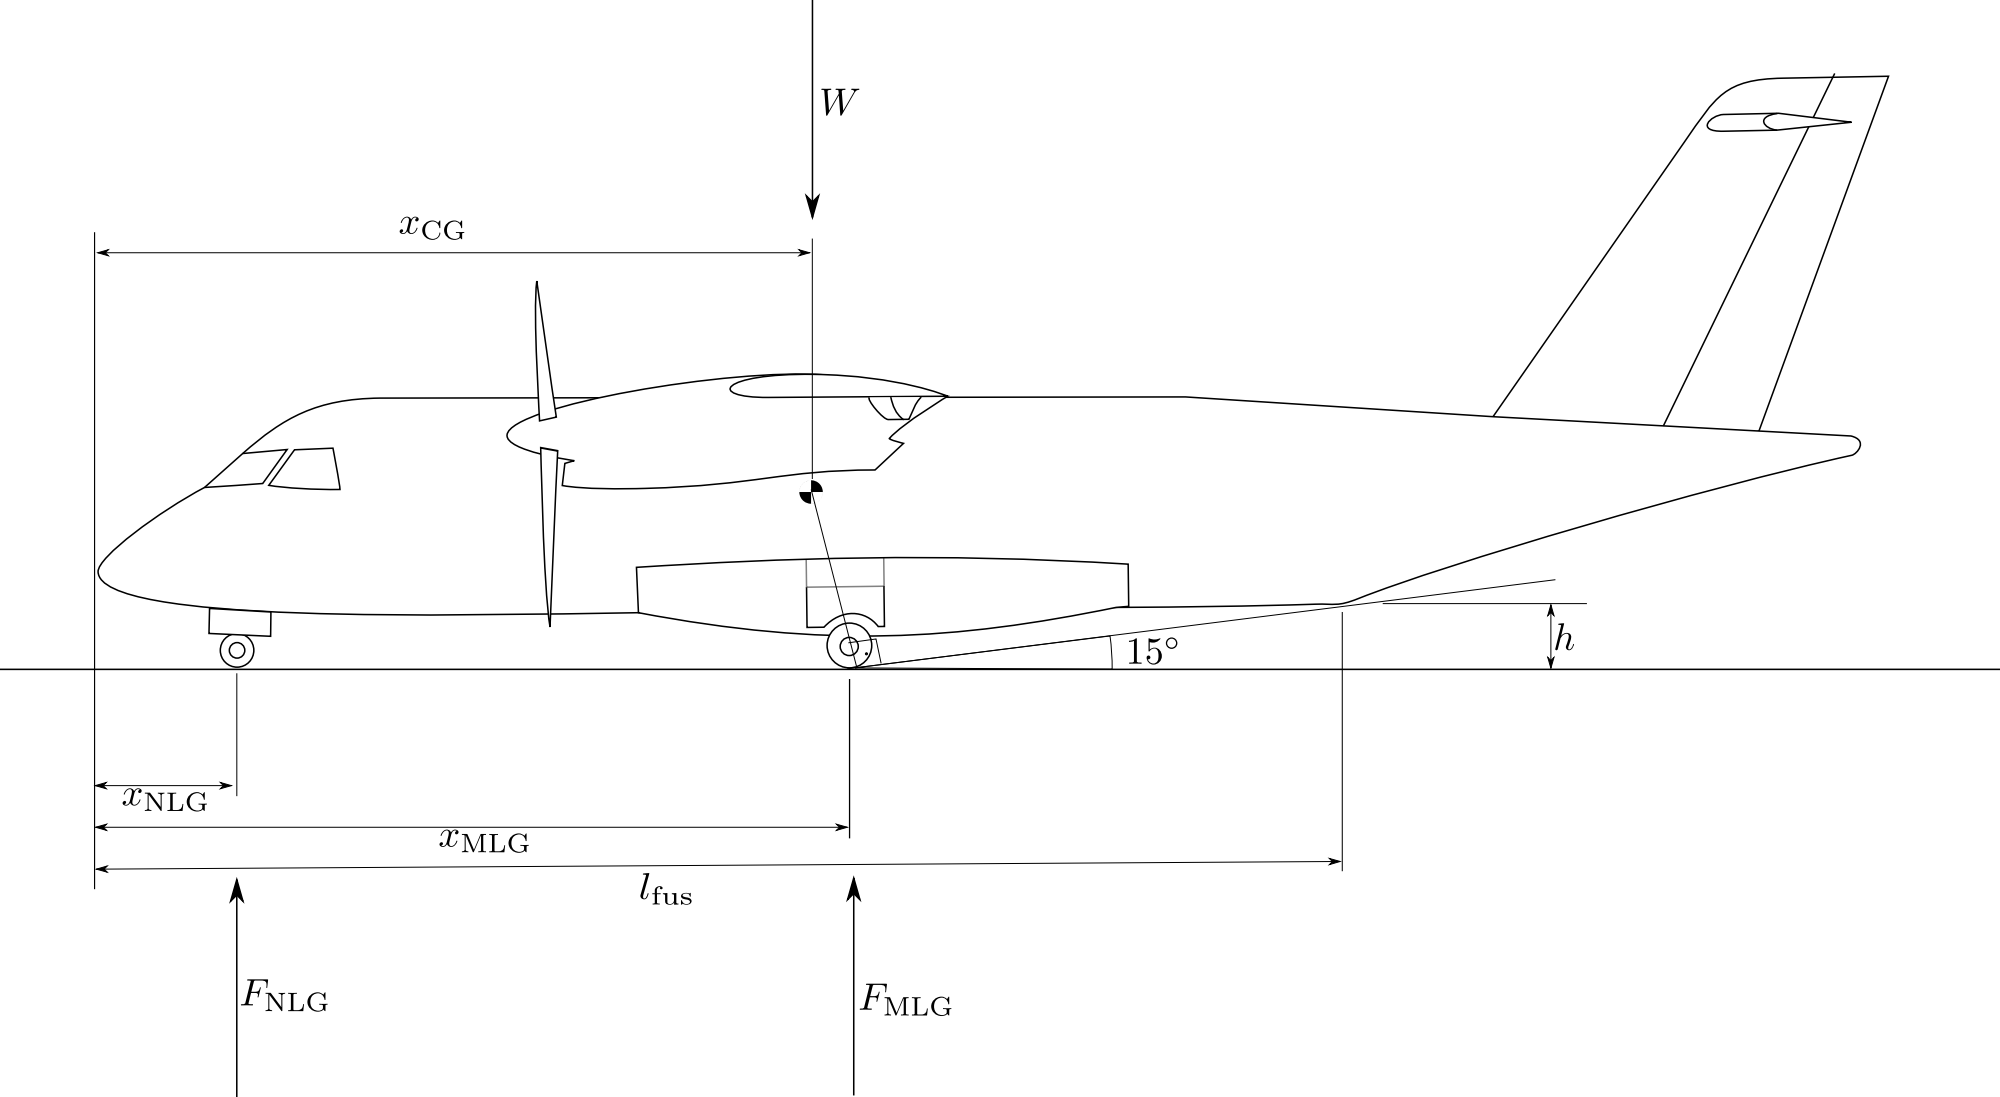
[picture p134: page 1]
