mthsladeira/projetos1/autogenerated/graficos_comparativos/empuxo.pdf

## Comparac¸ao do Empuxo ˜

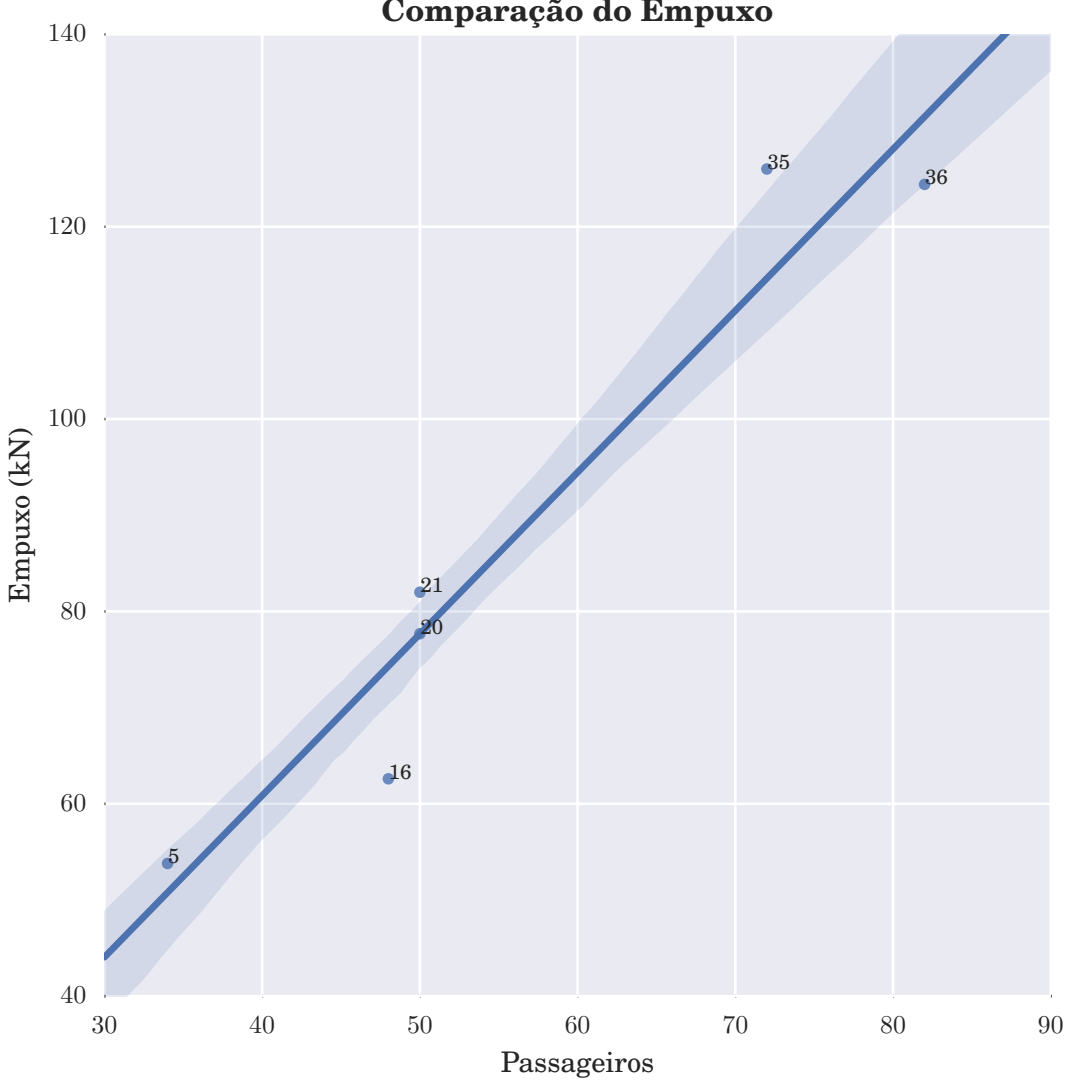
[picture p135: page 1]
Passageiros; Empuxo (kN)

21
16 | 20
