mthsladeira/projetos1/autogenerated/graficos_comparativos/potencia.pdf

Comparac¸ao da Pot ˜ | encia ˆ

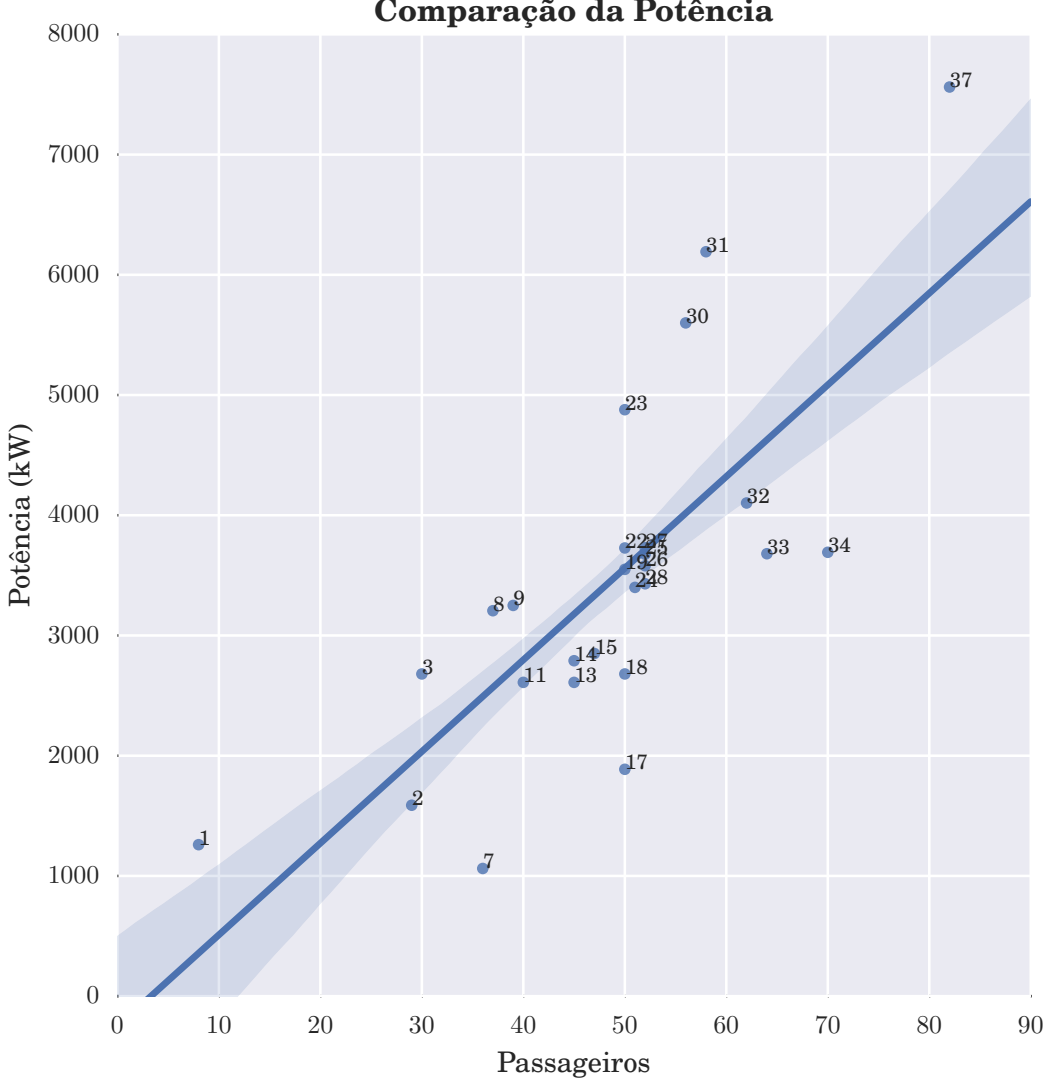
[picture p136: page 1]
Passageiros; Potˆencia (kW)
