mthsladeira/projetos1/text/parte1/tabela_comparativa.pdf

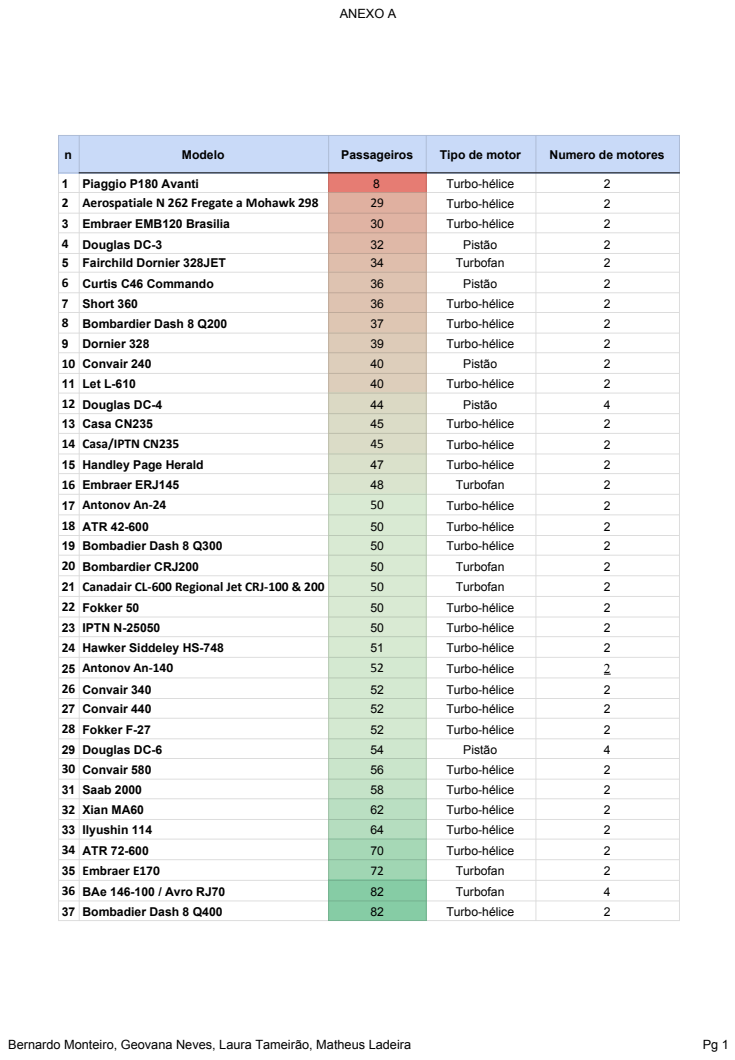
[picture p137: page 1]
ANEXO A; Bernardo Monteiro, Geovana Neves, Laura Tameirão, Matheus Ladeira; Modelo; Passageiros; Tipo de motor; Numero de motores; Piaggio P180 Avanti; Turbo-hélice; 2 Aerospatiale N 262 Fregate a Mohawk 298; Embraer EMB120 Brasilia; 4 Douglas DC-3; Pistão; Fairchild Dornier 328JET; Turbofan; 6 Curtis C46 Commando; Short 360; 8 Bombardier Dash 8 Q200; Dornier 328; 10 Convair 240; 11 Let L-610; 12 Douglas DC-4; 13 Casa CN235; 14 Casa/IPTN CN235; 15 Handley Page Herald; 16 Embraer ERJ145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

33 34 35 36 37 | Ilyushin 114 | 64 | Turbo-hélice 2
ATR 72-600 Embraer E170 BAe 146-100 / Avro RJ70 Bombadier Dash 8 Q400 | 70 | Turbo-hélice 2
72 | Turbofan 2
82 82 | Turbofan 4 Turbo-hélice 2

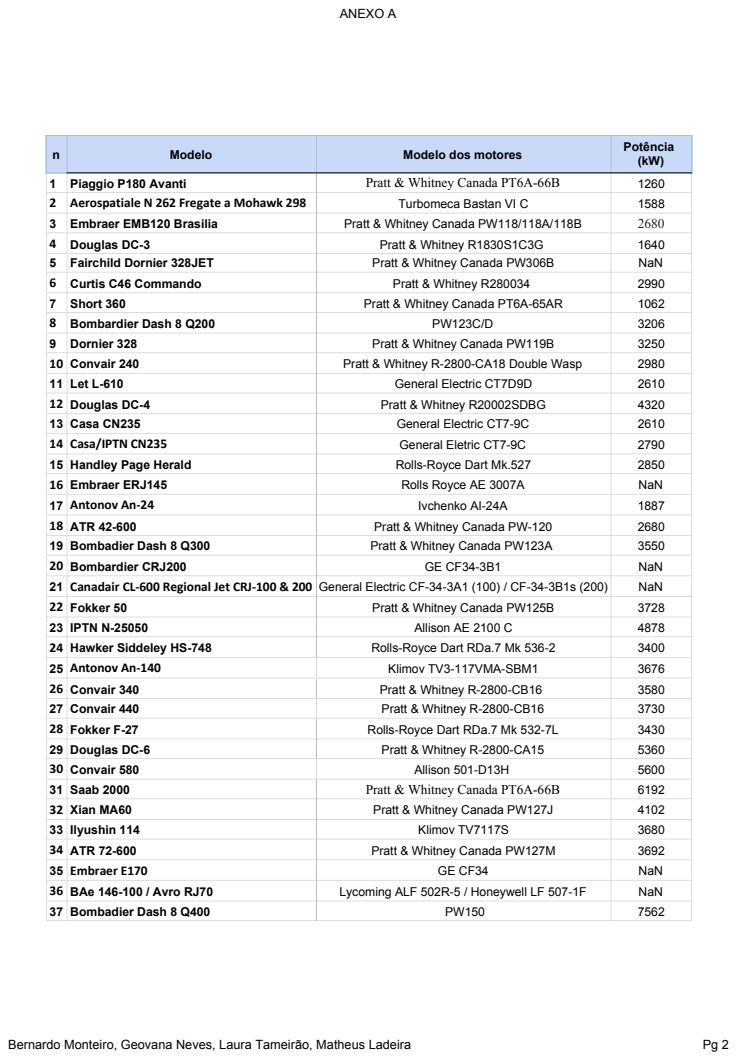
[picture p138: page 2]
Bernardo Monteiro, Geovana Neves, Laura Tameirão, Matheus Ladeira; 3 Embraer EMB120 Brasilia; 4 Douglas DC-3; 5 Fairchild Dornier 328JET; 6 Curtis C46 Commando; 7 Short 360; 8 Bombardier Dash 8 Q200; 9 Dornier 328; 10 Convair 240; 11 Let L-610; 12 Douglas DC-4; 13 Casa CN235 14 Casa/IPTN CN235; 27 Convair 440; 28 Fokker F-27; 29 Douglas DC-6; 30 Convair 580; 31 Saab 2000; 32 Xian MA60; 33 Ilyushin 114; 34 ATR 72-600; 35 Embraer E170; 36 BAe 146-100 / Avro RJ70; 37 Bombadier Dash 8 Q400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

n Modelo | Modelo dos motores Potência (kW)

1 Piaggio P180 Avanti
2 Aerospatiale N 262 Fregate a Mohawk 298

Pratt & Whitney Canada PT6A-66B 1260 Turbomeca Bastan VI C 1588

15 Handley Page Herald
16 Embraer ERJ145
17 Antonov An-24
18 ATR 42-600

19 Bombadier Dash 8 Q300
20 Bombardier CRJ200
21 Canadair CL-600 Regional Jet CRJ-100 & 200
22 Fokker 50

23 IPTN N-25050
24 Hawker Siddeley HS-748
25 Antonov An-140
26 Convair 340

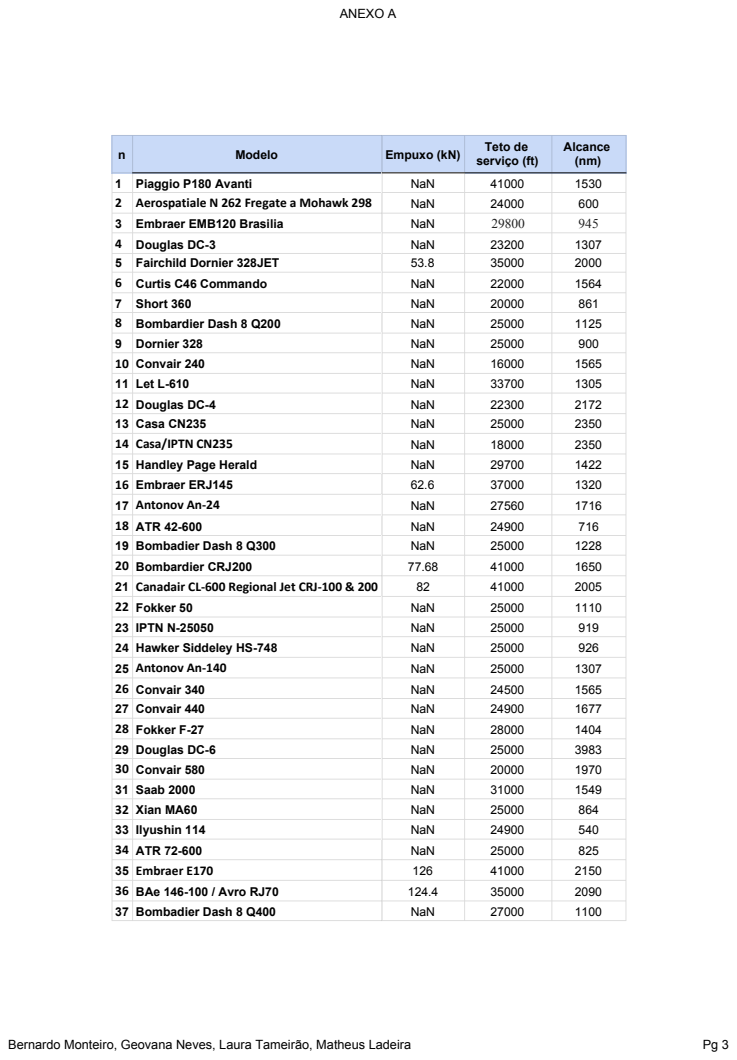
[picture p139: page 3]
Bernardo Monteiro, Geovana Neves, Laura Tameirão, Matheus Ladeira; 3 Embraer EMB120 Brasilia; 4 Douglas DC-3; 5 Fairchild Dornier 328JET; 6 Curtis C46 Commando; 7 Short 360; 8 Bombardier Dash 8 Q200; 9 Dornier 328; 10 Convair 240; 11 Let L-610; 12 Douglas DC-4; 13 Casa CN235 14 Casa/IPTN CN235; 27 Convair 440; 28 Fokker F-27; 29 Douglas DC-6; 30 Convair 580; 31 Saab 2000; 32 Xian MA60; 34 ATR 72-600; 35 Embraer E170; 36 BAe 146-100 / Avro RJ70; 37 Bombadier Dash 8 Q400; NaN

n Modelo | Empuxo (kN) Teto de Alcance serviço (ft) (nm)

1 Piaggio P180 Avanti
2 Aerospatiale N 262 Fregate a Mohawk 298

NaN | 41000 1530

15 Handley Page Herald
16 Embraer ERJ145
17 Antonov An-24
18 ATR 42-600

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

NaN NaN NaN NaN NaN NaN | 25000 1110 25000 919 25000 926 25000 1307 24500 1565 24900 1677 28000 1404 25000 3983 20000 1970 31000 1549 25000 864 24900 540

23 IPTN N-25050
24 Hawker Siddeley HS-748
25 Antonov An-140
26 Convair 340

33 Ilyushin 114

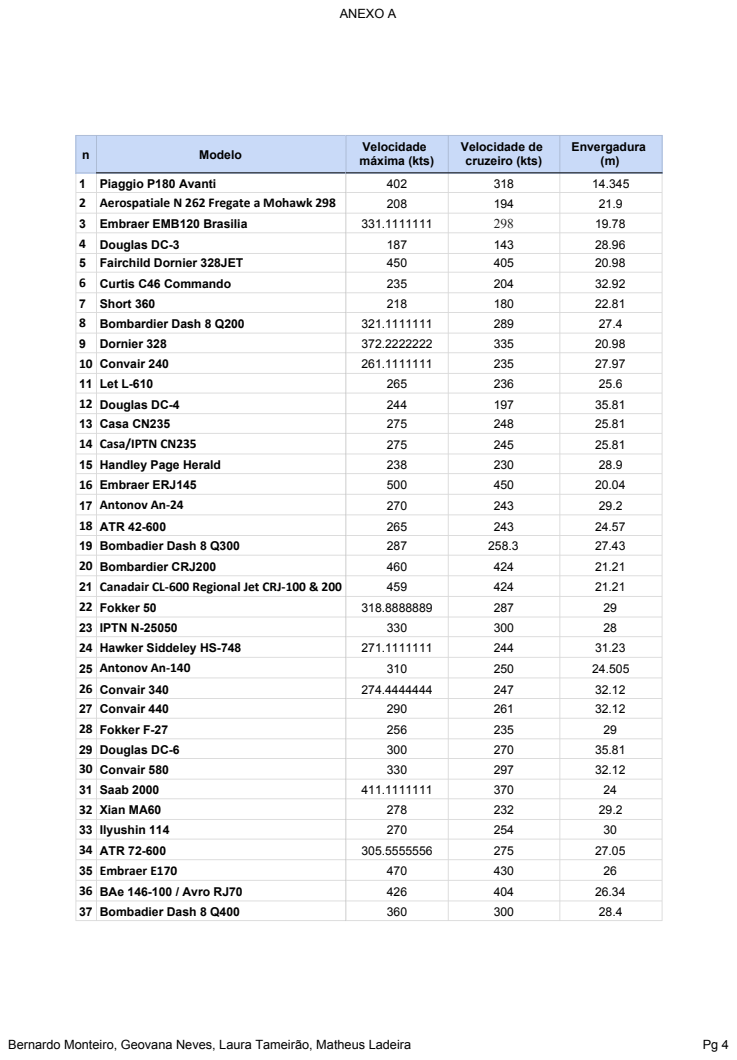
[picture p140: page 4]
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

n Modelo | Velocidade Velocidade de Envergadura máxima (kts) cruzeiro (kts) (m)

1 Piaggio P180 Avanti
2 Aerospatiale N 262 Fregate a Mohawk 298

15 Handley Page Herald
16 Embraer ERJ145
17 Antonov An-24
18 ATR 42-600

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

23 IPTN N-25050
24 Hawker Siddeley HS-748
25 Antonov An-140
26 Convair 340

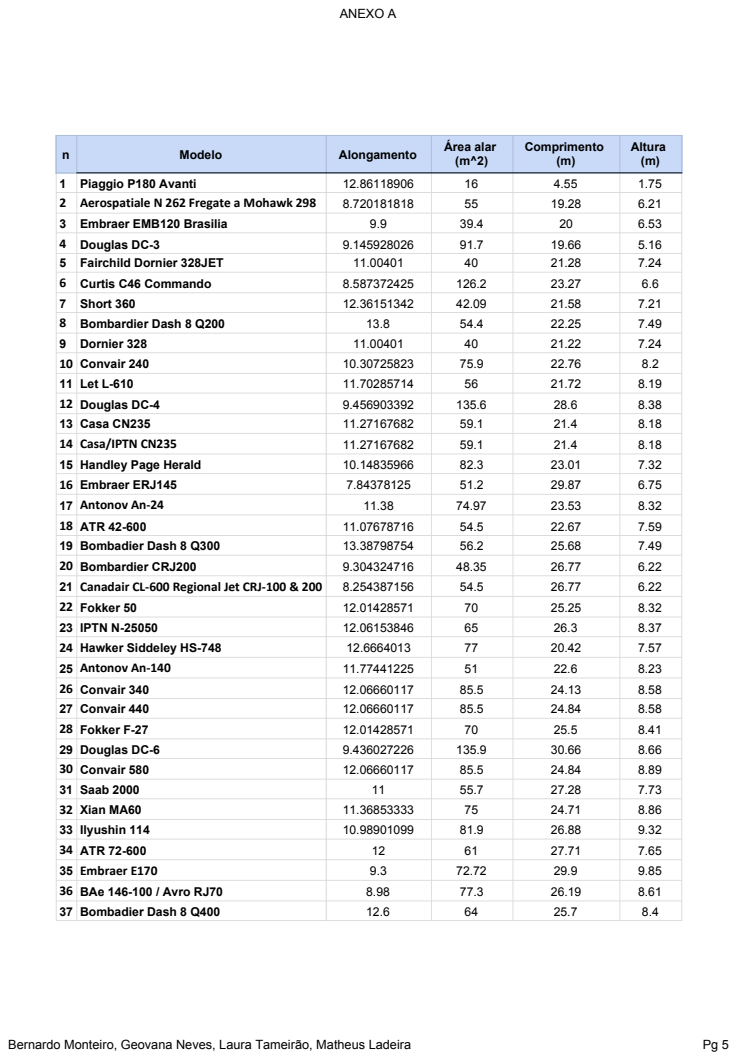
[picture p141: page 5]
Bernardo Monteiro, Geovana Neves, Laura Tameirão, Matheus Ladeira; Modelo; 3 Embraer EMB120 Brasilia; 4 Douglas DC-3; 5 Fairchild Dornier 328JET; 6 Curtis C46 Commando; 7 Short 360; 8 Bombardier Dash 8 Q200; 9 Dornier 328; 10 Convair 240; 11 Let L-610; 12 Douglas DC-4; 13 Casa CN235 14 Casa/IPTN CN235; 27 Convair 440; 28 Fokker F-27; 29 Douglas DC-6; 30 Convair 580; 31 Saab 2000; 32 Xian MA60; 33 Ilyushin 114; 34 ATR 72-600; 35 Embraer E170; 36 BAe 146-100 / Avro RJ70; 37 Bombadier Dash 8 Q400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

1 Piaggio P180 Avanti
2 Aerospatiale N 262 Fregate a Mohawk 298

15 Handley Page Herald
16 Embraer ERJ145
17 Antonov An-24
18 ATR 42-600

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

23 IPTN N-25050
24 Hawker Siddeley HS-748
25 Antonov An-140
26 Convair 340

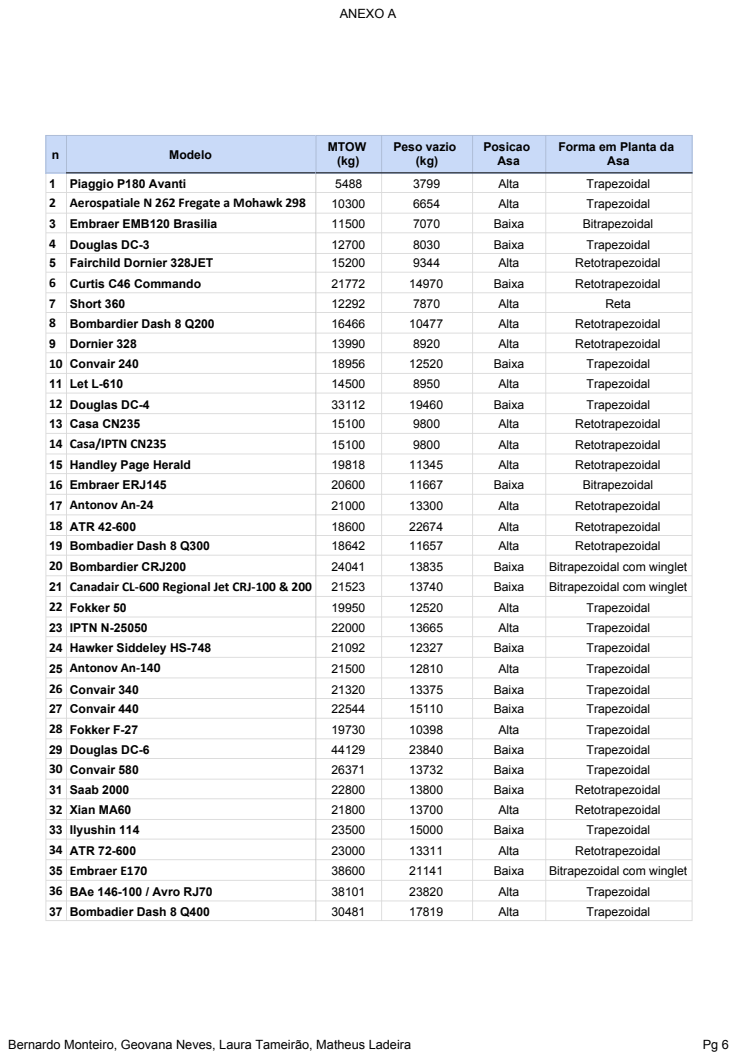
[picture p142: page 6]
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

Forma em Planta da

1 Piaggio P180 Avanti
2 Aerospatiale N 262 Fregate a Mohawk 298

15 Handley Page Herald
16 Embraer ERJ145
17 Antonov An-24
18 ATR 42-600

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

23 IPTN N-25050
24 Hawker Siddeley HS-748
25 Antonov An-140
26 Convair 340

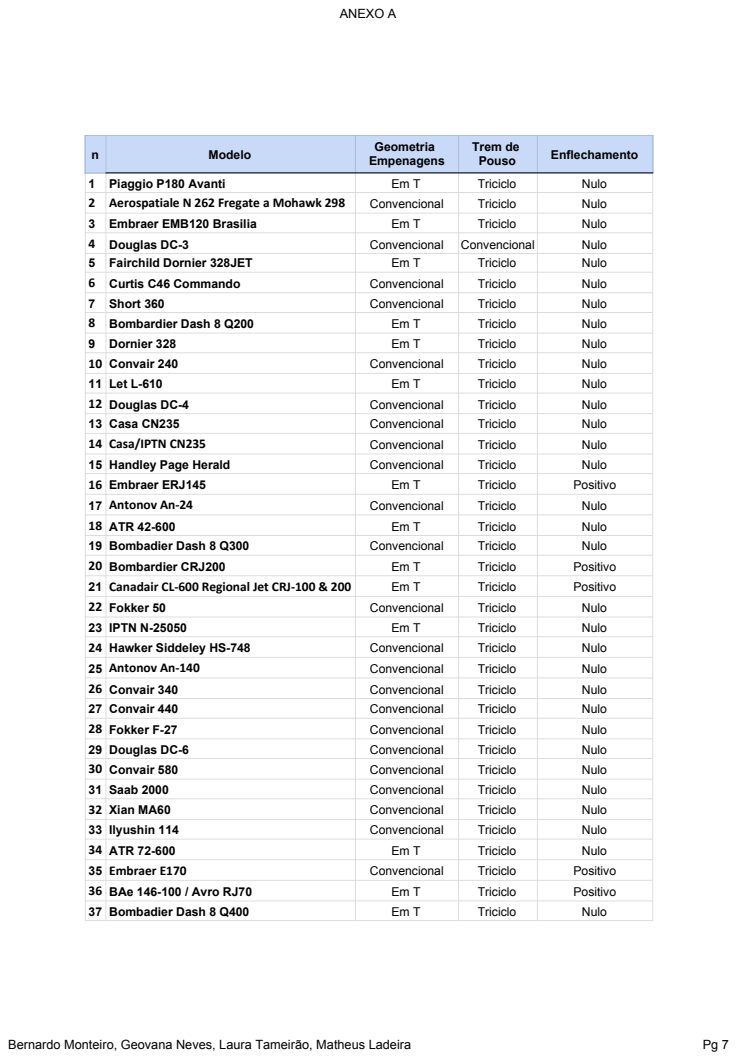
[picture p143: page 7]
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

1 Piaggio P180 Avanti
2 Aerospatiale N 262 Fregate a Mohawk 298

15 Handley Page Herald
16 Embraer ERJ145
17 Antonov An-24
18 ATR 42-600

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

23 IPTN N-25050
24 Hawker Siddeley HS-748
25 Antonov An-140
26 Convair 340
