mthsladeira/projetos1/data/perfis/plots/plot.pdf

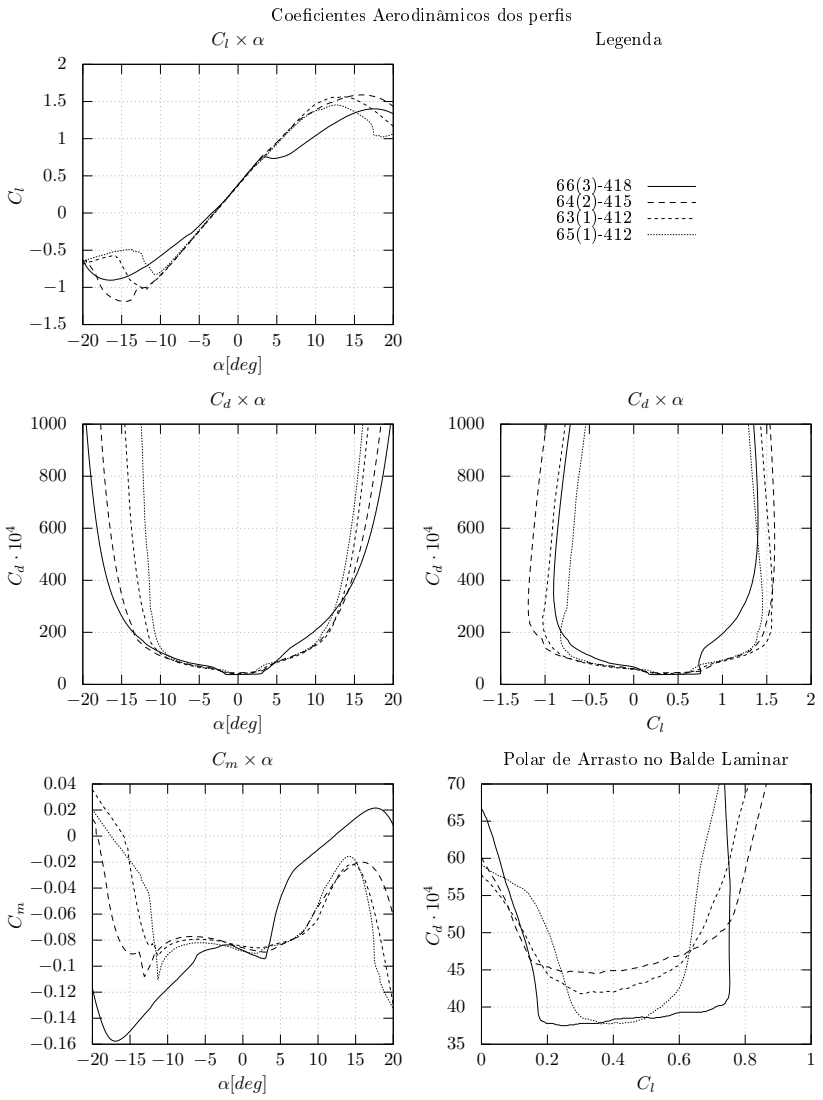
[picture p144: page 1]
α[deg]; Legenda

Coecientes Aerodinâmicos dos pers

Polar de Arrasto no Balde Laminar
