mthsladeira/projetos1/(commit log)

2018-06-10 Do OverLeaf para o GitHub
    [Local_Tabela_Comparativa.csv, tabela_comparativa.csv, teste.csv]
2018-06-10 Peças no SolidWorks
    Asa + empenagens + esboço da fuselagem + esboço da montagem
    [Aeronave.SLDASM, Asa.SLDPRT, Empenagem horizontal.SLDPRT, Empenagem vertical.SLDPRT, Fuselagem.SLDPRT]
2018-06-10 Enflechamento de 20° na EV
    [Aeronave.SLDASM, Empenagem vertical.SLDPRT]
2018-06-11 Inclusao Aerodinamica e Estabilidade
    Inclusao de analise aerodinamica da asa e análise de estabilidade (graficos e tabelas)
2018-06-12 Adição de texto a Parte 3 - Aerodinamica e Estabilidade
    Adição de texto a Parte 3 - Aerodinamica e Estabilidade
2018-06-19 Adicionado motor v0.1
    [Motor.SLDPRT]
2018-06-21 Tabela de CGs (anexo C)
2018-06-21 Acrescimo de cargas e dimensionamento asa
    Acrescimo de cargas e dimensionamento da asa
2018-06-22 Motor v.0.2
    [Motor.SLDPRT]
2018-06-22 Desenho em Solid v1.0
    [Aeronave.SLDASM, Asa.SLDPRT, Empenagem horizontal.SLDPRT, Empenagem vertical.SLDPRT, Fuselagem.SLDPRT, Motor.SLDPRT, Trem de Pouso.SLDPRT]
2018-06-23 Desenho em Solid v1.1
    [Aeronave.SLDDRW]
2018-06-23 Posicionamento do trem de pouso
2018-06-23 Corrigi comprimento da parte pressurizada da fuselagem
    Estava 30m, corrigi para 20m
2018-06-23 Inclusao de texto Passeio de CG
    Inclusao de texto Passeio de CG
2018-06-23 Inclusao de Resumo
2018-09-24 Adição das legendas da parte de Sistemas
2018-09-24 Troquei hinge moment por momento na articulação
    pq o texto eh em pt_br e o bauzer não gosta de misturar
2018-09-24 Nova fuselagem
    [Aeronave.SLDASM, Empenagem vertical.SLDPRT, Fuselagem.SLDPRT]
2018-09-24 exclusão dos marcadores de merge
2018-09-25 Aumento da empenagem vertical
    [Aeronave.SLDASM, Aeronave.SLDDRW, Empenagem vertical.SLDPRT]
2018-09-25 Correção de equacao
    Correção de equacao
2018-09-26 Delete main_vg.pdf
    Não tem porque fazer controle de versão para o arquivo compilado
2018-09-26 Analise de mach no perfil
    e mudar sistemas para a pasta da parte 4
2018-09-26 Analise de estabilidade sem APU
2018-09-28 Correção das imagens da parte de sistemas
2018-10-01 Desenho no autocad
    [Aeronave.DWG]
2018-10-22 Exportação do desenho para AutoCAD
    [Aeronave.DWG, Aeronave.SLDASM, Aeronave.SLDDRW]
2018-10-22 Renanme: SolidWorks > Desenho
    [Aeronave.DWG, Aeronave.SLDASM, Aeronave.SLDDRW, Asa.SLDPRT, Empenagem horizontal.SLDPRT, Empenagem vertical.SLDPRT, Fuselagem.SLDPRT, Motor.SLDPRT]
2018-10-27 Update no desenho
    [Aeronave.DWG, Aeronave.SLDASM, Aeronave.SLDDRW, Asa.SLDPRT, Empenagem horizontal.SLDPRT, Empenagem vertical.SLDPRT]
2018-10-29 adição dos codigos para calculo de cargas liquidas da eh.
2018-11-01 Cotas adicionadas + menores correções
    [Aeronave.DWG]
2018-11-03 Detalhes modificados no desenho
    [Aeronave.DWG]
2018-11-04 Adição do calculo de cargas
2018-11-25 Correções na Asa + Arquivo no formato para FEMAP
    [Asa.SLDPRT, Asa.x_t]
2018-11-25 Corrigi extensao das figuras de cargas
    Algum idiota colocou caixa alta e baixa misturada nos jpg.
    Arrumei essa merda que nao tava compilando
    hashtag mensagem mal educada
2018-11-25 Envelope de pressurizacao da cabine
2018-11-25 Adicionei estruturas fuselagem a parte 4
2018-11-25 Adiciona arquivo estrutura fuselagem
    Tinha esquecido disso. Sorry.
2018-11-25 atualiazação do mecanismo de retração do trem de pouso
2018-11-25 adição das cargas na fuselagem
2018-11-25 Desenhos finais
    [Aeronave.DWG, Asa.DWG, EH.DWG, fuselagem_estrutura.DWG, fuselagem_estrutura_transversal.DWG, nervuras.DWG, nervuras_EH.DWG]
2018-12-04 Limpeza de arquivos antigos
2018-12-04 Desenhos que o Bauzer pediu v0.1
    [Aeronave.DWG, mecanismo_atuacao.DWG]
2018-12-06 Versao final. Estou enviando para o Bauzer
